tomorrozy/gesture-control-car/docs/README.md

# 文档中心

这里汇总了从零基础到完整实现这个项目所需的全部资料，一共 **47 篇**。

---

## 怎么读（两条路线）

### 路线 A：零基础，目标是把车做出来

```
03-零基础落地包/  →  01-八阶段教程/  →  02-图解字典/  →  04-调试笔记/
   器材、工具链         每阶段怎么实现        概念看不懂查这里      卡住了查这里
```

1. 先看 [`03-零基础落地包/`](03-零基础落地包/)：买什么、装什么、怎么供电上电
2. 按 [`01-八阶段教程/`](01-八阶段教程/) 从阶段一做到阶段八，每阶段做完对照
   [`03-零基础落地包/04-八阶段逐阶段操作与验收门禁.md`](03-零基础落地包/04-八阶段逐阶段操作与验收门禁.md) 验收
3. 遇到不懂的名词查 [`02-图解字典/`](02-图解字典/)
4. 出 bug 先翻 [`04-调试笔记/`](04-调试笔记/)

### 路线 B：有嵌入式基础，只想看实现

```
00-学习路线与工程全景  →  01-八阶段教程  →  05-参考资料
```

先看 [`00-学习路线与工程全景.md`](00-学习路线与工程全景.md) 建立整体架构，再按需查具体阶段。

---

## 目录说明

### [`00-学习路线与工程全景.md`](00-学习路线与工程全景.md)

整个工程的架构分层、代码地图、学习路线图。**建议最先看这篇。**

### [`01-八阶段教程/`](01-八阶段教程/)　13 篇

项目的九个阶段（对应《Taurus 2027 电控组三面》任务书）：

| 阶段 | 内容 | 文档 |
|---|---|---|
| 一 | 双机通信 | [阶段一_双机通信_V2.md](01-八阶段教程/阶段一_双机通信_V2.md) |
| 二 | 电机驱动 | [阶段二_电机驱动_V2.md](01-八阶段教程/阶段二_电机驱动_V2.md) |
| 三 | 通信控电机 | [阶段三_通信控电机_V2.md](01-八阶段教程/阶段三_通信控电机_V2.md) |
| 四 | 蓝牙无线 | [阶段四_蓝牙无线_V2.md](01-八阶段教程/阶段四_蓝牙无线_V2.md) |
| 五 | MPU6050 姿态解算 | [阶段五_MPU6050解算_V2.md](01-八阶段教程/阶段五_MPU6050解算_V2.md) |
| 六 | 手势控电机 | [阶段六_手势控电机_V2.md](01-八阶段教程/阶段六_手势控电机_V2.md) |
| 七 | 速度闭环 PID | [阶段七_速度闭环PID_V2.md](01-八阶段教程/阶段七_速度闭环PID_V2.md) |
| 八 | 手势控小车 | [阶段八_手势控小车_V2.md](01-八阶段教程/阶段八_手势控小车_V2.md) |
| 八·任务1 | 差速转向原理 | [阶段八任务1_原理详解.md](01-八阶段教程/阶段八任务1_原理详解.md) |
| 八·任务2 | 速度环与前馈 | [阶段八任务2_原理详解.md](01-八阶段教程/阶段八任务2_原理详解.md) |

### [`02-图解字典/`](02-图解字典/)　9 篇

每个阶段配一份图解，把抽象概念（PWM、编码器、互补滤波、PID）画成图和类比。
**看不懂教程时来这里查。**

### [`03-零基础落地包/`](03-零基础落地包/)　7 篇

从「什么都没有」到「板子上电」的完整清单：

- [01-器材采购与到货核对清单.md](03-零基础落地包/01-器材采购与到货核对清单.md)
- [02-工具链与软件安装配置.md](03-零基础落地包/02-工具链与软件安装配置.md)
- [03-供电共地与上电安全.md](03-零基础落地包/03-供电共地与上电安全.md)
- [04-八阶段逐阶段操作与验收门禁.md](03-零基础落地包/04-八阶段逐阶段操作与验收门禁.md)
- [05-引脚权威总表与阶段接线改动.md](03-零基础落地包/05-引脚权威总表与阶段接线改动.md)
- [06-各阶段编译前补文件清单.md](03-零基础落地包/06-各阶段编译前补文件清单.md)

### [`04-调试笔记/`](04-调试笔记/)　8 篇

每个阶段真实踩过的坑：现象 → 原因 → 排查方法 → 解决。按阶段对应，出问题直接查。

### [`05-参考资料/`](05-参考资料/)　5 篇

- [STM32电控术语词典.md](05-参考资料/STM32电控术语词典.md) —— 200+ 条电控术语，按主题分类
- [代码模板速查.md](05-参考资料/代码模板速查.md) —— 常用外设初始化代码片段
- [Yaw零飘问题详解.md](05-参考资料/Yaw零飘问题详解.md) —— MPU6050 航向角漂移的成因与对策
- [嘉立创硬件解析与软硬映射.md](05-参考资料/嘉立创硬件解析与软硬映射.md) —— 原理图与代码的对应关系
- [硬件事实清单.md](05-参考资料/硬件事实清单.md) —— 已核实 / 待确认的硬件参数表

另外还有：

- [`硬件与接线.md`](硬件与接线.md) —— 两端完整引脚表（从驱动源码提取，与代码一致）
- [`通信协议.md`](通信协议.md) —— 13 字节帧格式、校验算法、无线参数

---

## 说明

- 文档中的代码片段与本仓库 `遥控/`、`FreeRTOS小车/` 下的实际源码对应
- 部分文档来自早期学习与调试过程，个别图片未能保留（已在文中标注）
- 术语、引脚、参数以 [`硬件与接线.md`](硬件与接线.md) 与源码为准
