tomorrozy/gesture-control-car/docs/硬件与接线.md

# 硬件与接线

> 所有引脚均从对应驱动源码中提取，与实际工程一致。
> 修改接线后，若代码里的引脚宏没同步改，请以代码为准。

---

## 一、手柄端（遥控 · STM32F103 中容量）

启动文件为 `startup_stm32f10x_md.s`，对应中容量芯片（如 STM32F103C8T6 / RCT6）。

| 模块 | 信号 | 引脚 | 模式 | 代码位置 |
|---|---|---|---|---|
| MPU6050 | SCL | **PB6** | 开漏输出（软件 I2C） | `APP/MyI2C.c` |
| MPU6050 | SDA | **PB7** | 开漏输出 | `APP/MyI2C.c` |
| OLED | SCL | **PB8** | 开漏输出（软件 I2C） | `APP/OLED.c` |
| OLED | SDA | **PB9** | 开漏输出 | `APP/OLED.c` |
| nRF24L01 | CSN | **PA0** | 推挽输出 | `APP/nRF24L01_API.c` |
| nRF24L01 | CE | **PA1** | 推挽输出 | 同上 |
| nRF24L01 | SCK | **PA2** | 推挽输出 | 同上 |
| nRF24L01 | MOSI | **PA3** | 推挽输出 | 同上 |
| nRF24L01 | MISO | **PA4** | 上拉输入 | 同上 |
| nRF24L01 | IRQ | **PA5** | 上拉输入 | 同上 |
| 按键 | KEY1 | **PB12** | 上拉输入（按下为低） | `APP/key/key.h` |
| 按键 | KEY2 | **PB13** | 上拉输入 | 同上 |
| 按键 | KEY3 | **PB14** | 上拉输入 | 同上 |
| 按键 | KEY4 | **PB15** | 上拉输入 | 同上 |
| 按键 | KEY5 | **PA8** | 上拉输入 | 同上 |
| DHT22 | DATA | **PA12** | 单总线 | `APP/dht22.h`（未接入主流程） |
| LED | LED0 | **PC13** | 推挽输出 | `APP/led/led.h` |
| LED | LED8 | **PA7** | 推挽输出 | 同上 |
| 时基 | — | TIM4 | 1 ms 中断 | `Public/time4.c` |

> 注意：`led.h` 里定义了 LED0~LED8，但 `LED_Init()` 实际只初始化了 **LED0(PC13)** 和 **LED8(PA7)**，其余被注释掉了 —— 因为 LED2~LED6 与 nRF24L01 的 PA1~PA5 引脚冲突。

## 二、小车端（FreeRTOS · STM32F103ZE）

启动文件为 `startup_stm32f10x_hd.s`，对应高容量芯片（开发板为 STM32F103ZE）。

### 电机与编码器

| 功能 | 信号 | 引脚 | 模式 / 外设 | 代码位置 |
|---|---|---|---|---|
| 左电机方向 | IN1 | **PB12** | 推挽输出 | `HARDWARE/LED/Motor.c` |
| 左电机方向 | IN2 | **PB13** | 推挽输出 | 同上 |
| 右电机方向 | IN3 | **PB14** | 推挽输出 | 同上 |
| 右电机方向 | IN4 | **PB15** | 推挽输出 | 同上 |
| 左电机 PWM | PWM_A | **PA0** | TIM2_CH1，复用推挽 | `HARDWARE/LED/PWM.c` |
| 右电机 PWM | PWM_B | **PA1** | TIM2_CH2，复用推挽 | 同上 |
| 左编码器 | A / B 相 | **PA6 / PA7** | TIM3 编码器模式 TI12，上拉输入 | `HARDWARE/LED/Encoder.c` |
| 右编码器 | A / B 相 | **PB6 / PB7** | TIM4 编码器模式 TI12，上拉输入 | 同上 |

PWM 频率：`72 MHz / 36 / 100 = 20 kHz`（`PSC = 35`，`ARR = 99`），占空比 `0~100`。

### 无线与显示

| 模块 | 信号 | 引脚 | 模式 | 说明 |
|---|---|---|---|---|
| nRF24L01 | CSN | **PA2** | 推挽输出 | 软件 SPI |
| nRF24L01 | CE | **PA3** | 推挽输出 | |
| nRF24L01 | SCK | **PA4** | 推挽输出 | |
| nRF24L01 | MOSI | **PA5** | 推挽输出 | ⚠️ 与 LED1 复用，见下 |
| nRF24L01 | MISO | **PB0** | 上拉输入 | |
| nRF24L01 | IRQ | **PB1** | 上拉输入 | |
| OLED | SCL | **PB9** | 开漏输出 | ⚠️ 与手柄端**相反** |
| OLED | SDA | **PB8** | 开漏输出 | |
| 串口1 | TX / RX | **PA9 / PA10** | 复用推挽 / 浮空输入 | 115200 8N1 |
| LED | LED0 | **PC13** | 推挽输出 | |
| LED | LED1 | **PA5** | 推挽输出 | ⚠️ 与 nRF MOSI 冲突 |

> ⚠️ **已知引脚冲突**：小车端 `LED_Init()` 把 **PA5** 配成推挽输出，而 nRF24L01 的 **MOSI 也是 PA5**。
> `main()` 里 `NRF24L01_Init()` 在 `LED_Init()` 之后执行，所以最终是无线模块生效，LED1 实际不可用
> （SPI 通信时它会被高频翻转）。如果你要真正用 LED1，请改到别的引脚。

## 三、供电注意事项

- **nRF24L01 必须 3.3 V**，接 5 V 会烧毁；模块电源脚建议并联 **10 µF** 钽电容，否则上电握手偶发失败。
- 电机与主控建议**分开供电**，电机启动瞬间的电流跌落会导致单片机复位。
- H 桥和主控要**共地**。
- OLED、MPU6050 也是 3.3 V 器件，注意电平匹配。

## 四、原理图

[`1.原理图/手势小车.epro`](../1.原理图/手势小车.epro) 是**立创 EDA 专业版**工程文件，
用 [立创 EDA 专业版](https://pro.lceda.cn/) 打开即可查看/编辑。该文件是 ZIP 二进制格式，属于设计源文件，直接提交进 Git 仓库。
