tomorrozy/gesture-control-car/docs/00-学习资料总索引.md

---
title: 学习库总索引
tags:
  - RM电控
  - STM32/导航
  - MOC
version: V2
updated: 2026-10-23
---

> [!danger] 🚨 版本交接指令
> 请将旧版 `00_学习库总索引_V1.md` 移入回收站，保存此 `_V2` 文件，并确认全库双链无断链（当前 19 篇、0 断链）。

# 00 · RM_STM32 学习库总索引（V2）

> [!tip] 配套
> 本页是导航；八阶段教程与八篇 Debug 档案互链，找不到东西先回这里。

---

## 📡 本页怎么用

> [!info] 预习指南：先看这三个问题
> 本页只回答“从哪开始、现在缺什么、哪条是硬伤”。

| 你想干什么 | 点哪里 |
| :--- | :--- |
| 按顺序从头学 | 「八阶段进度表」，从阶段一开始 |
| 某个现象不对，想排错 | 对应阶段的 `Debug_阶段X_...` |
| 想知道代码里哪些是坑 | 「硬伤清单」与「待补信息」 |
| 想知道审到哪一步了 | 「审查与修复记录」 |

---

## 一、八阶段进度表（含审查状态）

| 阶段 | 主教程 | 错题本 | 核心一句话 | 审查 |
|:--:|---|---|---|:--:|
| 一 · 双机通信 | [[阶段一_主教程_双机通信_V2]] | [[Debug_阶段一_双机通信_V2]] | 13 字节帧：A5 / 长度 / 数据 / XOR / 0D | ✅ V2 |
| 二 · 电机驱动 | [[阶段二_主教程_电机驱动_V2]] | [[Debug_阶段二_电机驱动_V2]] | 20 kHz PWM + 四倍频编码器 | ✅ V2 |
| 三 · 通信控电机 | [[阶段三_主教程_通信控电机_V2]] | [[Debug_阶段三_通信控电机_V2]] | 收包 → 加锁 → 映射 → PID → 输出 | ✅ V2 |
| 四 · 蓝牙无线 | [[阶段四_主教程_蓝牙无线_V2]] | [[Debug_阶段四_蓝牙无线_V2]] | 软件 SPI + nRF24L01 寄存器 | ✅ V2 |
| 五 · 姿态解算 | [[阶段五_主教程_MPU6050解算_V2]] | [[Debug_阶段五_MPU6050解算_V2]] | 软件 I2C + 互补滤波 α=0.95 | ✅ V2 |
| 六 · 手势控电机 | [[阶段六_主教程_手势控电机_V2]] | [[Debug_阶段六_手势控电机_V2]] | gesture 是备用通道，车用连续量 | ✅ V2 |
| 七 · 速度闭环 PID | [[阶段七_主教程_速度闭环PID_V2]] | [[Debug_阶段七_速度闭环PID_V2]] | 位置式 PI，20 ms，无 D | ✅ V2 |
| 八 · 手势控小车 | [[阶段八_主教程_手势控小车_V2]] | [[Debug_阶段八_手势控小车_V2]] | 差速：一加一减 | ✅ V2 |

---

## 二、本库结构

```text
RM_STM32_学习库\
├─ 00_MOC与索引\00_学习库总索引_V2.md   ← 本页
├─ 01_阶段一_双机通信\ … 08_阶段八_手势控小车\   （各 1 篇 V2 主教程）
├─ 80_Debug错题本\                                （8 篇 V2，与主教程互链）
└─ _归档_V1\                                      （17 篇旧版，按 00_索引 + 01–08 子目录排序，仅备查）
```

**命名**：`阶段X_主教程_主题_Vn.md`、`Debug_阶段X_主题_Vn.md`；现行全为 **V2**，旧版统一收进 `_归档_V1\`（双链仍可解析，但不作为学习入口）。
**每篇结构**：YAML → `[!info]` 雷达 → 任务对表 → 结构总览 → 逐行（`【第 X 行】` + `[!abstract]`）→ 现象 → 缺口 → `[!success]` 审计报告 → 勘误记录。

---

## 三、基准事实（全库统一，已逐行核对）

| 项目 | 事实 | 出处 |
|---|---|---|
| MCU / 主频 | STM32F103C8T6 ×2；72 MHz（HSE 8 MHz × `PLLMULL9`） | `system_stm32f10x.c`、`stm32f10x.h` |
| 协议 | 13 字节：`A5 / 09 / pitch4 / roll4 / gesture1 / XOR / 0D` | 两端 `main.c` |
| 无线 | nRF24L01，`RF_CH=40`（2440 MHz）、2 Mbps、32 字节定长 | `nRF24L01_API.c` |
| 控制周期 | 20 ms（`configTICK_RATE_HZ=1000`） | `main.c:303`、`FreeRTOSConfig.h:97` |
| 发送节拍 | 100 ms（≈10 Hz） | `遥控 main.c:156` |
| 编码器 | 常数 `52` → 反推 **13 线**（4×13）；减速比 **1:13** → 676 计数/输出圈 | `main.c:265`、你的确认 |
| PID | 位置式 PI：Kp=2.0、Ki=1.5、Kd=0（D 未实现） | `main.c:84/166` |
| 时延 | 100 + 20 + 20 ≈ **140 ms** | `main.c:206/303` |

---

## 四、硬伤清单（审查后刷新）

| # | 硬伤 | 位置 | 后果 | 修法 |
|:--:|---|---|---|---|
| 1 | **失联不停车** | `task_rx` 无超时 | 遥控断电后车继续跑 | 记最后收包 tick，超 300 ms 目标清零 |
| 2 | **无 VOFA 打印** | 全工程裸 `printf` = 0 | 闭环无法量化 | 用阶段七 3.10 的打印，调参时开 |
| 3 | **差速无归一化** | `main.c:256–259` 各自截断 | 大角度斜推比例失真（5.5:1→3.25:1） | 等比缩放（阶段八 3.8） |
| 4 | **反馈系数 9.27666** | `main.c:265–266` | 与 1:13 不符 → 反馈高估约 40% | 改 `13.0f` 后重调 Ki（前提：线数=13） |
| 5 | **三套左右开关** | 遥控 `Gesture_Map:66` 互换后门 + 小车 `REVERSE_TURN` + 遥控 `×-1.0f` | 同时改会互相抵消，方向排查困难 | 只保留一个入口，其余置默认 |
| 6 | **三套阈值** | 遥控 15/15、控制 10/15、显示 10/15 | `pitch=12°` 时屏幕说停、车却走 30% | 统一常量，或把阈值集中到一个头文件 |

**死代码/死变量（答辩会被问）**：`g_gesture` 只写不读（96/202）；`MIN_SPEED` 未使用（221）；`channel` 未使用（97）；`cos_pitch` 算了不用（MPU6050.c:120）；`kd`/`prev_err` 未参与公式（85）。

---

## 五、待补信息（我仍未掌握，不猜）

| 项 | 需要什么 | 影响 |
|:--:|---|---|
| TB6612 实物接线 | PWMA/PWMB/AIN1/AIN2/BIN1/BIN2/STBY 各接哪 | “前进”是否与代码一致 |
| 嘉立创工程 | BOM（CSV）+ 原理图 PDF | `.eprj2` 当前只剩空 `attributes` 表，读不出元件/网络 |
| 编码器线数 | 是否 13 线 | 决定 52/676 与 40% 修正是否成立 |
| 电机额定转速 | 铭牌参数 | 决定 0~100 对应多少 cm/s |
| 物理方向 | 前进/左转是否与逻辑一致 | 需上车实测（`REVERSE_TURN`/取反/接线三者耦合） |
| `LOOP_TIME` | 主循环实测周期 | 阶段五互补滤波的 `0.01f` 是假设 |

---

## 六、审查与修复记录（本轮全量）

| 阶段 | 审查发现 | 处理 | 复验项 |
|:--:|---|---|:--:|
| 一 | 9 处行号偏移（3.1/3.2 与 Debug） | 已修（V1.1） | 29 |
| 二 | 13 处行号 + 4 类反向漏检（输入捕获/滤波、LED/OLED、13 线归因） | 已修 → **V2 落盘** | 107 |
| 三 | 局部量类型缺失、轮询无出处、分组错标 | 已修（V1.1） | 95 |
| 四 | 3.3/3.7 行号、代码块压缩未声明 | 已修（V1.1） | 79 |
| 五 | `cos_pitch` 块失真、`WriteReg` 依赖、main 双校准 | 已修（V1.1） | 153 |
| 六 | 66 行注释、`REVERSE_TURN` 宏、`#if` 分支 | 已修（V1.1） | 71 |
| 七 | 13 线归因、右轮补偿、全局量类型 | 已修（V1.1） | 71 |
| 八 | 显示任务整段漏检、`#if` 分支、补偿链路 | 已修 → **V2 落盘** | 74 |

**总计**：逐行断言复验 **约 730 项**，全库双链 **0 断链**。

---

## 七、学习顺序与依赖

```text
阶段一（协议）→ 阶段二（电机/编码器）→ 阶段三（链路打通）
   → 阶段四（无线）→ 阶段五（姿态）→ 阶段六（手势语义）
   → 阶段七（闭环）→ 阶段八（整机）
```

依赖：三←一+二；六←五；七←二+三；八←三+六+七。可跳读：阶段四寄存器细节、阶段七调参细节。

---

## 八、防幻觉审计报告

> [!success] 🛡️ 防幻觉审计报告
> 1. **代码出处核实**：是。本页所有基准事实、硬伤位置、死变量行号均来自已逐行审查的源文件（两端 `main.c`、`nRF24L01_API.c`、`MyI2C.c`、`MPU6050.c`、`PWM.c`、`Motor.c`、`Encoder.c`、`led.c/led.h`、`FreeRTOSConfig.h`、`system_stm32f10x.c`）。
> 2. **库的纯洁性**：未混用；全库按 StdPeriph + FreeRTOS 描述，无 `HAL_`。
> 3. **脑补排查**：否。硬件接线/线数/转速/物理方向/`LOOP_TIME` 一律列“待补”，未编造；`13 线`明确标为**反推值**。
> 4. **本次悬空依赖**：`00_学习库总索引_V1.md` 已由本 V2 取代；全库 19 篇、0 断链。

#RM电控 #STM32 #MOC
