tomorrozy/gesture-control-car/docs/00-学习路线与工程全景.md

---
tags:
  - STM32/教程
  - STM32/代码驱动
  - 电控组
aliases:
  - 代码驱动教程 00
  - 工程全景与学习路线图
type: 教程
status: 进行中
project: STM32手势小车
---

# 零基础 · 代码驱动教程｜第 0 步：工程全景与学习路线图

> **本轮只做"地图"，不逐行讲代码。** 目的只有一个：在你看第一行代码之前，先知道这个工程有几块、每块干什么、按什么顺序看、每章学完你会看到什么现象。

---

## 〇、开场三句实话（先说清楚，免得后面误会）

1. **你消息里的【总纲】【目录树】正文没有贴上来**（只传过来了 4 个 @ 路径）。所以我**没有等**，直接读了磁盘上的真实内容：
   - `Taurus 2027电控组三面.pdf`（7 页，八阶段 + 进阶拓展的题目要求）
   - `FreeRTOS小车\`、`遥控\` 两个 Keil 工程的全部源码（已转成 UTF-8 副本逐个读过）
   - 你库里已有的《三面题八阶段代码阶梯》《README 阅读顺序》等笔记
2. **我用来当"总纲"的是这两样东西**：`三面题八阶段代码阶梯_read0.txt` 的八阶段骨架 + PDF 的得分点。如果你手里那份总纲是**另一个文件**，把它发我，我按它重排章节（章节名、顺序都能改）。
3. **下面凡是我写"行号"的地方，都是我在磁盘上实测的真实行号**；凡是我不确定的（比如某个硬件参数），我会直接写"待确认"，不猜。

---

## 一、这是一个什么工程：一句话 + 两张角色卡

**一句话**：两块 STM32F103C8T6 组成的"手势遥控车"——
**手带端（`遥控\`）戴在手上**，用 MPU6050 测出俯仰角/横滚角，打包成 13 字节的无线帧发出去；
**小车端（`FreeRTOS小车\`）装车上**，收到帧后把角度换算成左右轮目标速度，用编码器做速度闭环 PID，驱动两个电机差速转向。

```
        手带端（遥控工程）                          小车端（FreeRTOS小车工程）
  ┌──────────────────────────┐             ┌──────────────────────────────┐
  │ MPU6050 ──软件I2C──┐     │             │  nRF24L01 ──软件SPI──┐         │
  │                    ↓     │  2.4GHz     │                      ↓         │
  │              互补滤波     │  13字节帧   │  解包 → pitch/roll            │
  │                    ↓     │ ──────────► │           ↓                   │
  │           手势映射 Gesture│             │   姿态→左右轮目标速度          │
  │                    ↓     │             │           ↓                   │
  │       打包 0xA5…0x0D      │             │   PID 闭环（编码器反馈）        │
  │                    ↓     │             │           ↓                   │
  │  OLED（给人看）  nRF发送   │             │  PWM → TB6612 → 电机 → 编码器  │
  └──────────────────────────┘             └──────────────────────────────┘
```

### 角色卡 A：手带端 `遥控\`

| 项目 | 实测值 |
|---|---|
| Keil 工程文件 | `Template.uvprojx` |
| 芯片 / 容量宏 | `STM32F103C8` / `STM32F10X_MD`（64 KB Flash、20 KB RAM） |
| 启动文件 | `Libraries\CMSIS\startup_stm32f10x_md.s` |
| **有没有操作系统** | **没有**。裸机：`main()` 里一个 `while(1)`，加一个 1 ms 定时器中断 |
| 时间基准 | `TIM4` 1 ms 中断（`Public\time4.c`），中断里给 `Time_ms` 加 1 并扫描按键 |
| 主循环节拍 | 循环显示 OLED；`Time_ms > 100` 时打包并发送一帧 → **约 10 Hz** |
| 无线 | nRF24L01，**软件 SPI**，引脚 `PA0~PA5`（CSN/CE/SCK/MOSI/MISO/IRQ） |
| 显示 | OLED SSD1306，**软件 I2C**，`SCL=PB8`、`SDA=PB9` |
| 姿态传感器 | MPU6050，**软件 I2C**，`SCL=PB6`、`SDA=PB7` |
| 人机输入 | 5 个按键：`PB12/PB13/PB14/PB15/PA8`（上拉输入，按下为低） |
| 指示灯 | `PC13`（LED0）、`PA7`（LED8） |

### 角色卡 B：小车端 `FreeRTOS小车\`

| 项目 | 实测值 |
|---|---|
| Keil 工程文件 | `USER\FreeRTOS.uvprojx` |
| 芯片 / 容量宏 | `STM32F103C8` / `STM32F10X_MD`（同左） |
| 启动文件 | `CORE\startup_stm32f10x_hd.s` ⚠️ **hd（大容量）启动文件 + MD 容量宏 = 不自洽，第 1 章专门核对** |
| **有没有操作系统** | **有**。FreeRTOS，4 个任务（start/rx/ctrl/disp），**全部静态创建**（不 malloc） |
| 任务节拍 | `task_rx` 20 ms 收一次包、`task_ctrl` 20 ms 跑一次 PID、`task_disp` 50 ms 刷一次屏 |
| 无线 | nRF24L01，软件 SPI，引脚 `PA2~PA5` + `PB0/PB1`（CSN/CE/SCK/MOSI + MISO/IRQ） |
| 显示 | OLED，软件 I2C，**`SCL=PB9`、`SDA=PB8`（与手带端正好相反！）** |
| 执行器 | 2 路 PWM：`PA0`(TIM2_CH1)、`PA1`(TIM2_CH2)；方向脚 `PB12~PB15`；接 TB6612 |
| 反馈 | 编码器：左轮 TIM3(`PA6/PA7`)、右轮 TIM4(`PB6/PB7`)，四倍频计数 |
| 指示灯 | `PC13`、`PA5` ⚠️ **PA5 同时是 nRF 的 MOSI，被 LED_Init 抢过一次** |

> **必须记住的一件事**：`nRF24L01_API.c`、`OLED.c`、`led.c` 在**两个工程里各有一份同名文件，但里面的引脚定义不同**。
> Windows 文件系统不区分大小写，VS Code 的标签页也长得一样 —— 这是新手最容易"改了没反应"的地方。
> 从下一章起，我每次都会在代码块第一行标清来源路径。

---

## 二、整体架构：五层楼

```
┌──────────────────────────────────────────────────────────────────────┐
│ L4 应用层   遥控/User/main.c          小车/USER/main.c                │
│            手势映射 + 打包            解包 + 姿态映射 + PID + 4任务    │
├──────────────────────────────────────────────────────────────────────┤
│ L3 中间件   内联协议(0xA5…0x0D)  XOR校验    ├── FreeRTOS 内核          │
│            互补滤波(MPU6050.c 内)           │  tasks/queue/list/timers │
│            速度环 PID(main.c 内)            │  port(ARM_CM3)/heap_4    │
├──────────────────────────────────────────────────────────────────────┤
│ L2 驱动层   led  PWM  Motor  Encoder  OLED  OLED_Data                 │
│             nRF24L01_API  MyI2C  MPU6050  key  time4  SysTick          │
│             usart  delay  sys           ← 这些是"本项目自己写的"        │
├──────────────────────────────────────────────────────────────────────┤
│ L1 库函数   STM32F10x_FWLib（23 个外设驱动：gpio/tim/usart/rcc/…）      │
│            作用：把"写寄存器"包装成"填结构体 + 调函数"                  │
├──────────────────────────────────────────────────────────────────────┤
│ L0 底座     startup_stm32f10x_*.s（向量表/复位入口）                    │
│             system_stm32f10x.c（时钟树 → 72 MHz）                      │
│             stm32f10x.h（所有寄存器的名字）  core_cm3（内核）           │
│             stm32f10x_it.c（异常/中断入口）                            │
└──────────────────────────────────────────────────────────────────────┘
                              ▲ 再往下就是硬件：芯片、电机、屏幕、无线模块
```

### 每层的职责，用一句人话讲

| 层 | 职责 | 什么时候你会改它 |
|---|---|---|
| **L0 底座** | 芯片上电后**第一段执行的代码**：填向量表 → 调 `SystemInit()` 把 8 MHz 晶振倍频到 72 MHz → 跳进 `main()` | 几乎不改，但**必须看懂一次**（第 1 章），否则永远不知道为什么"忘了开时钟外设就不动" |
| **L1 库函数** | 官方固件库。每个外设一套 `XXX_Init()/XXX_Cmd()` | 不改，只查：想确认某个参数有什么可选项时翻它的 `.h` |
| **L2 驱动层** | 本项目作者写的"把某个硬件变成几个函数"：`Motor_SetPWM()`、`Encoder_Get()`、`OLED_ShowString()` | **你最常改的一层**（换引脚、加显示行、调 PWM 频率） |
| **L3 中间件** | 跟具体硬件无关的"算法与调度"：协议打包/解包、互补滤波、PID、FreeRTOS | 调参、改进算法都在这层 |
| **L4 应用层** | 决定"什么时候调用谁"：任务循环、主循环、状态机 | 加功能先看这层 |

### 为什么这个工程要分这么多层（也是你以后自己写代码该照抄的结构）

- **换硬件只动 L2**：比如把 OLED 从 PB8/PB9 换到 PB10/PB11，只改 `OLED.c` 里 3 行，L3/L4 一行不动。
- **换算法只动 L3**：把互补滤波换成卡尔曼滤波，`main.c` 里 `MPU6050_GetAngle()` 的调用完全不用改。
- **换流程只动 L4**：把 `while(1)` 改成 FreeRTOS 任务，是因为 L3 的 PID、协议都被封装成了函数，可以随便搬。

---

## 三、一次完整的"抬手 → 轮子转"（8 跳数据流）

这一节是全套教程的**主线剧情**，后面每一章都是在这条链上摘下一环来讲。

| 跳 | 发生什么 | 代码位置（实测行号） |
|:--:|---|---|
| ① | **读传感器**：I2C 连读 14 字节 → 加速度 ax/ay/az + 陀螺 gx/gy/gz | `遥控\APP\MPU6050.c` `MPU6050_GetData()` |
| ② | **算角度**：加速度算"绝对倾角"，陀螺积分算"变化量"，两者用 α=0.95 互补融合 → `pitch/roll` | `遥控\APP\MPU6050.c` 第 89–137 行 |
| ③ | **变手势**：`pitch>15°`→前进，`<-15°`→后退，`roll>15°`→左，`<-15°`→右，否则停 | `遥控\User\main.c` 第 62–73 行 `Gesture_Map()` |
| ④ | **打包**：`[0xA5][0x09][pitch 4B][roll 4B][gesture 1B][XOR][0x0D]` = 13 字节，补 0 到 32 字节 | `遥控\User\main.c` 第 75–93 行 `Protocol_Pack()` |
| ⑤ | **发无线**：写 TX FIFO → CE 拉高 → 等 IRQ 变低（发送完成） | `遥控\APP\nRF24L01_API.c` `NRF24L01_SendData()` |
| ⑥ | **收无线 + 解包**：读 32 字节 → 逐字段校验 → 限幅 ±80° → 加互斥量写入全局变量 | `FreeRTOS小车\USER\main.c` 第 182–208 行 `task_rx()` / 第 42–55 行 `Protocol_Unpack()` |
| ⑦ | **变目标速度**：pitch→前后速度 `speed_x`（去 10° 死区），roll→转向分量 `speed_y`（去 15° 死区）；`targetL=speed_x+speed_y`、`targetR=speed_x-speed_y` | 同文件 第 230–259 行 |
| ⑧ | **闭环 + 驱动**：编码器测实际转速 → PID 算 PWM → 限幅/起转补偿 → `Motor_SetPWM()` → H 桥 → 轮子 → 编码器…回到 ⑧ | 同文件 第 261–304 行 + `Encoder.c` + `Motor.c` + `PWM.c` |

> **一句话记住整条链**：`姿态 → 角度 → 手势/速度 → 帧 → 空中 → 帧 → 左右轮速 → PWM → 轮子 → 编码器 → 回到 PID`。
> 学完之后，你应该能在纸上默画出这 8 跳，并说出每一跳在哪个文件。

---

## 四、零基础学习路线图：18 章（第 0 章是预备课）

**难度**：★ 入门（照着抄就能过）｜★★ 基础（理解概念）｜★★★ 进阶（要动手调试）｜★★★★ 较难（要查手册）｜★★★★★ 综合（要整机联调）

**学时**是"零基础 + 每章都要上板验证"的保守估计，全套约 **90~100 小时**，一周 2 章约 9~10 周。

### 第一部分 · 地基：让程序跑起来，并且知道自己为什么能跑（第 0~2 章）

| 章 | 标题 | 主要文件 | 学完你能看到的现象 | 难度 | 前置 | 学时 |
|:--:|---|---|---|:--:|:--:|:--:|
| **0** | **预备课：这套工程怎么打开、编译、下载** | `*.uvprojx`、`keilkilll.bat`、`OBJ\*.hex` | Keil 能编译 0 error、ST-Link 能下载、串口助手能连上 | ★ | 无 | 2 |
| **1** | **从复位到 main：芯片上电后的 100 毫秒** | `startup_stm32f10x_hd.s`、`system_stm32f10x.c`、`main.c` 第 141–172 行 | 说清"为什么每个外设都要先开时钟"；能在 `main()` 第一行打断点，看变量 | ★★ | 0 | 3 |
| **2** | **GPIO：点灯与按键** | `led.c/.h`、`key.c/.h` | PC13 灯 1 Hz 闪；按键短按/长按在同一块板上被区分开 | ★★ | 1 | 4 |

### 第二部分 · 接口：让芯片会说话、会看（第 3~5 章）

| 章 | 标题 | 主要文件 | 学完你能看到的现象 | 难度 | 前置 | 学时 |
|:--:|---|---|---|:--:|:--:|:--:|
| **3** | **串口 + printf：板子开口说话** | `usart.c/.h`、`delay.c` | 电脑串口助手每 500 ms 收到一行 `Hello 1`，且能反向发数据回板子 | ★★ | 1 | 4 |
| **4** | **OLED：给板子一张脸** | `OLED.c`、`OLED.h`、`OLED_Data.h` | 128×64 屏上显示中文"姿态："和数字；改一个数字立刻变 | ★★★ | 2,3 | 6 |
| **5** | **定时器：给程序装一颗心跳** | `time4.c`、`SysTick.c`、`main.c` 的 `Time_ms` | 1 ms 中断里计数，OLED 上看到秒表；理解"中断打断 main" | ★★★ | 2,3 | 4 |

### 第三部分 · 执行器与传感器：让它动、让它感知（第 6~9 章）

| 章 | 标题 | 主要文件 | 学完你能看到的现象 | 难度 | 前置 | 学时 |
|:--:|---|---|---|:--:|:--:|:--:|
| **6** | **PWM 与 H 桥：电机转起来** | `PWM.c/.h`、`Motor.c/.h` | 电机 0→100 占空比由慢到快，`-100` 反转 | ★★ | 2 | 4 |
| **7** | **编码器：让车知道自己转多快** | `Encoder.c/.h` | 串口打印"每 20 ms 的脉冲数"，用手转轮子数字会变正负 | ★★★ | 6 | 5 |
| **8** | **软件 I2C 与 MPU6050：读出姿态原始值** | `MyI2C.c/.h`、`MPU6050_Reg.h`、`MPU6050.c` 前半 | OLED 上 6 个数字：静止时 ax≈0、az≈2048，转动时 gx/gy 变化 | ★★★★ | 2,4 | 6 |
| **9** | **互补滤波：把抖动的数字变成稳定的角度** | `MPU6050.c` 第 89–137 行 | 板子倾斜 30°，屏幕角度跟手且不抖；快速晃动不飘 | ★★★★ | 8 | 6 |

### 第四部分 · 通信：让两块板子隔空对话（第 10~13 章）

| 章 | 标题 | 主要文件 | 学完你能看到的现象 | 难度 | 前置 | 学时 |
|:--:|---|---|---|:--:|:--:|:--:|
| **10** | **nRF24L01（上）：软件 SPI 与寄存器** | 小车端 `nRF24L01_API.c` 第 1–130 行 | `NRF24L01_Check()` 返回 0，OLED 显示"无线模块正常" | ★★★★ | 2,3 | 6 |
| **11** | **nRF24L01（下）：收发模式与 32 字节包** | 两端 `nRF24L01_API.c` 后半 + `main.c` 的初始化 | 一块板按键，另一块板 OLED 上的数字变 | ★★★★ | 10 | 6 |
| **12** | **自定义协议：0xA5 / 长度 / XOR / 0x0D** | 遥控 `main.c` 第 75–93 行、小车 `main.c` 第 42–55 行 | 串口助手抓到 13 字节帧；故意改坏校验字节，接收端丢弃 | ★★★ | 11 | 4 |
| **13** | **手势映射：角度变成指令** | 遥控 `main.c` 第 62–73、126–168 行 | 抬手显示"前进"、翻腕显示"左右"；10 Hz 发送节拍可测 | ★★ | 9,12 | 3 |

### 第五部分 · 闭环与整机：把碎片缝成一辆车（第 14~17 章）

| 章 | 标题 | 主要文件 | 学完你能看到的现象 | 难度 | 前置 | 学时 |
|:--:|---|---|---|:--:|:--:|:--:|
| **14** | **PID：速度闭环** | 小车 `main.c` 第 58–90、261–305 行 | 目标 50 时轮子稳定在 50；**用手捏住轮子，松手后它会"顶"回原速** | ★★★★★ | 7,12 | 8 |
| **15** | **差速转向：姿态变成左右轮速** | 小车 `main.c` 第 211–305 行 | 抬手前进、翻腕原地转、斜推走弧线；OLED 显示 9 种状态 | ★★★★★ | 13,14 | 6 |
| **16** | **FreeRTOS：把一个大循环拆成四个任务** | `FreeRTOSConfig.h`、`portmacro.h`、`main.c` 第 108–208 行 | 三个任务按 20/20/50 ms 各跑各的，OLED 不再拖慢 PID | ★★★★★ | 12,14 | 8 |
| **17** | **整机联调 + 答辩** | `stm32f10x_it.c`、`delay.c`、全部 | 车能跑；能回答"丢包怎么办""为什么 PID 要 20 ms 一次""yaw 为什么漂" | ★★★★★ | 全部 | 8 |

---

## 五、章节依赖图（先学哪章）

```
                        ┌──── 0 预备课 ────┐
                        │                  │
                        ▼                  ▼
                        1 启动 ──────────► 2 GPIO
                         │                  │  │  │
              ┌──────────┼───────────┐      │  │  └──────────────┐
              ▼          ▼           ▼      ▼  ▼                 ▼
          3 串口     5 定时器      6 PWM ──► 7 编码器          4 OLED
              │          │           │        │                   │
              │          │           │        │                   ▼
              │          │           │        │              8 I2C/MPU6050
              │          │           │        │                   │
              │          ▼           │        │                   ▼
              │      10 nRF(上)      │        │              9 互补滤波
              │          │           │        │                   │
              │          ▼           │        │                   │
              └─────► 11 nRF(下)     │        │                   │
                         │           │        │                   │
                         ▼           │        │                   │
                     12 协议 ────────┘        │                   │
                         │                    │                   │
                         ▼                    │                   │
                     13 手势映射 ◄────────────┼───────────────────┘
                         │                    │
                         ▼                    ▼
                     15 差速 ◄────────► 14 PID
                         │                    │
                         └──────┬─────────────┘
                                ▼
                          16 FreeRTOS
                                │
                                ▼
                          17 整机联调
```

**三条硬依赖**（违反就会听不懂）：
1. **第 4 章（OLED）必须在第 8 章之前** —— 后面所有调试都靠屏幕看数字，没有屏幕你没法自测。
2. **第 7 章（编码器）必须在第 14 章（PID）之前** —— PID 的"反馈量"就是编码器读数。
3. **第 12 章（协议）必须在第 13/14/15 章之前** —— 后面所有"数据从无线来"的假设都建立在这套帧格式上。

**可以跳过的章节**（如果你只想先让车动起来）：第 5、16 章可以最后补；但第 4、7、12 章跳过会卡住。

---

## 六、按什么顺序把代码发给我（批次表）

**规则三条**：
- **一次只发 1~2 个文件**，按下面批次顺序走。发多了我会主动说"这轮只用其中 X"，浪费你的带宽。
- **发文件时不用解释**，直接拖进来就行；如果我需要某个头文件（`.h`），会在表里写清。
- **.c 和 .h 成对发**（宏定义、函数声明常在 `.h` 里，缺了我就得猜，而我不猜）。

| 批次 | 发给我的文件（相对 `Taurus car\`） | 用到它的章节 | 备注 |
|:--:|---|:--:|---|
| **1** | `FreeRTOS小车\USER\main.c` | 第 1 章 | ★ 全套的地图。这轮只讲第 1–180 行，其余部分先当黑盒 |
| **2** | `FreeRTOS小车\HARDWARE\LED\led.c` + `led.h` | 第 2 章 | 最短的驱动（37 行），最适合第一次逐行拆 |
| **3** | `遥控\APP\key\key.c` + `key.h` | 第 2 章（下半） | 按键状态机 + 长按短按，第一次见"时间"参与逻辑 |
| **4** | `FreeRTOS小车\SYSTEM\usart\usart.c` + `usart.h` | 第 3 章 | printf 重定向 + 中断接收状态机 |
| **5** | `FreeRTOS小车\HARDWARE\LED\OLED.c` + `OLED.h` | 第 4 章 | 只用前 200 行（GPIO/软件 I2C/写命令）；字模文件不用发 |
| **6** | `遥控\Public\time4.c` + `遥控\Public\SysTick.c` | 第 5 章 | 定时器中断 vs SysTick 延时，两种"时间"对比 |
| **7** | `FreeRTOS小车\HARDWARE\LED\PWM.c` + `Motor.c` | 第 6 章 | 时基单元 + H 桥真值表 |
| **8** | `FreeRTOS小车\HARDWARE\LED\Encoder.c` + `Encoder.h` | 第 7 章 | 编码器接口模式 + 溢出 |
| **9** | `遥控\APP\MyI2C.c` + `MyI2C.h`、`MPU6050_Reg.h` | 第 8 章 | 软件 I2C 时序 + 寄存器地址表 |
| **10** | `遥控\APP\MPU6050.c` + `MPU6050.h` | 第 8–9 章 | 一次发，分两章讲（读数据 / 算角度） |
| **11** | `FreeRTOS小车\HARDWARE\LED\nRF24L01_API.c` + `nRF24L01_API.h` | 第 10 章 | 只讲前 130 行（SPI + 读写寄存器 + Check） |
| **12** | `遥控\APP\nRF24L01_API.c` | 第 11 章 | 对比两端差异（引脚、地址、发送流程） |
| **13** | `遥控\User\main.c` | 第 12–13 章 | 打包 + 手势 + 100 ms 节拍主循环 |
| **14** | （不用新文件）回头用第 1 批的 `main.c` | 第 14–15 章 | 讲第 58–90 行 PID 和第 211–305 行 task_ctrl |
| **15** | `FreeRTOS小车\FreeRTOS\include\FreeRTOSConfig.h` + `FreeRTOS\portable\RVDS\ARM_CM3\portmacro.h` | 第 16 章 | 配置项 + 移植层宏，讲清"任务切换靠什么" |
| **16** | `FreeRTOS小车\USER\stm32f10x_it.c` + `SYSTEM\delay\delay.c` | 第 17 章 | 中断总入口 + FreeRTOS 下的延时（最后一个坑：`SysTick_Handler` 在哪） |

**这些不用你发**（我已在磁盘上读过，讲课时会直接引用行号）：
`STM32F10x_FWLib\`（固件库）、`FreeRTOS\` 内核源码、`startup_*.s`、`stm32f10x.h`、`OLED_Data.c`（字模，只讲结构）、`Obj\*.o`、`*.uvguix.*`、`dht22.c`（**不在工程里，是遗留文件**）。

---

## 七、我先扫了一遍代码，记下了 12 个"坑"（讲到哪章就展开哪个）

> 这些不是我编的，都是代码里**真实存在**的不一致。**先给你看，是为了让你知道：这工程不是"完美教材"，而是"能跑的实战代码"——真正值钱的能力，是能看出这些。**

| # | 坑 | 位置 | 会放在哪章 |
|:--:|---|---|:--:|
| 1 | **两个工程的 OLED 的 SCL/SDA 正好相反**：小车 `SCL=PB9,SDA=PB8`；遥控 `SCL=PB8,SDA=PB9` | 两端 `OLED.c` 第 79–99 行 | 4 |
| 2 | 小车 `LED_Init()` 把 **PA5** 配成推挽输出并拉高，而 PA5 是 nRF 的 **MOSI** | `小车\led.c` 第 31–35 行 | 2 / 10 |
| 3 | 小车 `led.c` 注释写"PB5 和 PE5"，实际代码是 **PC13 和 PA5**（正点原子模板残留） | 同上 第 16、25 行 | 2 |
| 4 | `MyI2C.c` 注释写"PB10/PB11"，实际是 **PB6/PB7** | `遥控\MyI2C.c` 第 52–64 行 | 8 |
| 5 | 遥控端 **TX 地址 0x11…，RX_ADDR_P0 却是 0xAA…** → 自动 ACK 收不到，每包白重发 10 次 | `遥控\nRF24L01_API.c` | 11 |
| 6 | 遥控发送用 `while(NRF_IRQ == 1)` **死等**，没有超时 → 模块掉线就卡死 | 同上 `NRF24L01_SendData()` | 11 |
| 7 | 互补滤波里 `LOOP_TIME=0.01`（假设 10 ms 一次），但主循环里有软件 I2C + 整屏刷新，实际周期可能 30~100 ms → **积分时间失真** | `遥控\MPU6050.c` 第 13、127 行 | 9 |
| 8 | `Key_1menu()` 定义了但 `main()` **从没调用**（死代码）；`dht22.c` 根本没加进工程 | `遥控\User\main.c`、`uvprojx` 文件列表 | 2 |
| 9 | 手势字节 `gesture` 打包发了，但小车 **收下就存着不用**，控制和显示都重新用 pitch/roll 算 | 两端 `main.c` | 13 |
| 10 | `g_act_left = enc/52/0.02/9.27666*5` 里的 **9.27666 是经验标定系数**，不是物理常数 | 小车 `main.c` 第 265–266 行 | 14 |
| 11 | 小车启动文件是 **hd（大容量）**，器件却是 C8/MD；`configTOTAL_HEAP_SIZE=10KB` 且全部静态创建却仍链接 `heap_4.c` | `uvprojx`、`FreeRTOSConfig.h` | 1 / 16 |
| 12 | 遥控判"前进"阈值 15°，小车 `DEAD_ZONE` 却是 10° → 15°~10° 之间会出现"手以为在动、车没动"的空档 | 两端 `main.c` | 15 |

---

## 八、和你那份"总纲"（三面题八阶段）怎么对上

| 三面题阶段 | 题目得分点 | 落到本教程的哪几章 |
|:--:|---|---|
| 阶段一 双机通信基础 | UART 双向、两板互连、0xA5…0x0D 协议、UART+DMA | 第 3、10、11、12 章（**DMA 你这工程没做**，第 17 章给补法） |
| 阶段二 电机驱动基础 | PWM 正反转、转速/位置、按键模式 + LED、OLED 显示 | 第 2、4、6、7 章（**按键模式与 LED 指示小车端没有**，第 2 章给改法） |
| 阶段三 双机通信控电机 | 一板发指令、另一板执行、指令切目标速度 | 第 12 章 + 第 14 章 |
| 阶段四 无线通信 | 用蓝牙/nRF 替换有线 | 第 10、11 章（本工程用 nRF，**没用 HC-05**） |
| 阶段五 MPU6050 姿态解算 | I2C 原始数据、互补/卡尔曼、角度稳定、yaw 零漂 | 第 8、9 章（**yaw 零漂**在第 9 章专讲） |
| 阶段六 手势控单电机 | 手势映射、无线发手势 | 第 13 章 + 第 14 章 |
| 阶段七 速度闭环 PID | 固定目标、VOFA+ 波形整定、IMU 映射速度 | 第 14 章（**VOFA+ 打印**第 14 章末尾补） |
| 阶段八 手势控小车 | 差速前进/后退/左转/右转 | 第 15 章 |
| 进阶拓展 | FreeRTOS 调度 | 第 16 章（**CAN、上位机在线调参**没做，第 17 章列路线） |

> **一句话**：这个工程是"**八个阶段全部压进了最终版**"的一份代码，所以它很"满"——第 14 章以后你会看到，同一个 `main.c` 里同时有协议、PID、姿态映射、RTOS 四件事。教程的任务就是把它一层层拆开。

---

## 九、开讲之前，需要你补充 3 样东西（不阻塞，可以边学边补）

1. **接线**：TB6612 的 PWMA/PWMB/AIN1/AIN2/BIN1/BIN2 实际接哪几个脚？编码器 A/B 相是否按 `TIM3=PA6/PA7`、`TIM4=PB6/PB7` 接的 nRF 是 3.3 V 还是 5 V 转 3.3 V？
   → 一份**接线表或照片**即可。没有它，第 6/7/11 章的"现象"只能靠猜。
2. **电机参数**：型号（JGB37-520？）、减速比、编码器线数（11 线还是 13 线）。
   → 第 7、14 章要拿它验算 `52 计数/圈` 和 `9.27666` 到底对不对。
3. **你那份"学习总纲"的原文**：如果就是 `三面题八阶段代码阶梯` + PDF，回我一句"就是它"；如果是别的文件，发我，我按它重排第五节。

---

## 十、下一轮你会收到什么

你只要发**第 1 批**：`FreeRTOS小车\USER\main.c`（一个文件）。

我会按固定结构给你**第 1 章《从复位到 main：芯片上电后的 100 毫秒》**：
【本节目标】【先看现象：上电那一刻发生了什么】【代码逐段拆解（第 1–180 行，只讲 main + 任务创建骨架）】【背后的知识点：启动文件 / 向量表 / 时钟树 / 72 MHz 是怎么来的 / 为什么必须 `RCC_APB2PeriphClockCmd`】【关键调用链：`Reset_Handler → SystemInit → main → vTaskStartScheduler`】【常见坑：hd 启动文件、`NVIC_PriorityGroupConfig(NVIC_PriorityGroup_4)` 为什么是 4、`delay_init()` 里改了 SysTick】【动手练习 3 个】【本章小结】。

**本章学完的验收标准**（先给你，提前有个底）：
- [ ] 能在 Keil 里单步执行，看到程序从 `Reset_Handler` 走进 `main`
- [ ] 能说出 `SystemInit()` 把 8 MHz 变成 72 MHz 用了哪两级倍频
- [ ] 能把第 1 章 3 个练习改完并上板看到现象

---

*本文档由"第 0 步"生成，后续每章会以 `01 …`、`02 …` 递增命名，放在本文件夹内。*
