tomorrozy/gesture-control-car/docs/01-八阶段教程/阶段一_双机通信_V2.md

---
title: 阶段一 主教程 双机通信
tags:
  - RM电控
  - STM32/阶段一
  - STM32/外设/UART
  - STM32/协议
version: V2
updated: 2026-10-23
code_base:
  - FreeRTOS小车/SYSTEM/usart/usart.c
  - FreeRTOS小车/SYSTEM/usart/usart.h
  - FreeRTOS小车/USER/main.c
  - 遥控/User/main.c
---

> [!danger] 🚨 版本交接指令
> 请将旧版 `阶段一_主教程_双机通信_V1.md` 移入回收站，保存此 `_V2` 文件，并把 `Debug_阶段一_双机通信_V1.md` 与全库双链改指本文件。

# 阶段一 · 主教程 · 双机通信

> [!tip] 配套错题本
> 本阶段排错专用：[[Debug_阶段一_双机通信_V2]]

---

## 📡 本章前置知识点雷达

> [!info] 预习指南：在啃代码之前，先认识这些“硬核名词”
> 本章围绕以下 5 个概念展开。

| 知识点名称 | 一句话通俗解释 | 在本章代码中的角色 |
| :--- | :--- | :--- |
| **UART 异步串行** | 两根线按约定速度一位一位传，不共享时钟。 | `usart.c` 初始化 PA9/PA10 |
| **波特率 8N1** | 每秒多少位、几位数据、有无校验、几位停止位。 | `uart_init(115200)` |
| **中断接收 RXNE** | 收到一个字节就打断 CPU。 | `USART1_IRQHandler` |
| **自定义协议帧** | 给数据套“信封”：帧头/长度/数据/校验/帧尾。 | `Protocol_Pack / Unpack` |
| **printf 重定向** | 让 `printf` 的字从串口出去。 | `fputc` + `#pragma import` |

---

## 一、本阶段任务与得分点

| 任务 | 要求 | 本工程现状 |
|:--:|---|---|
| 1 | UART 与电脑双向通信 | 串口通了，但主程序**裸 `printf` 调用 0 处**、无人读接收缓冲 |
| 2 | 两块板 UART 互连 | 未做（实际走 nRF 无线） |
| 3 | 自定义协议 `0xA5…0x0D` | 已完成（13 字节，两端对称） |
| 4 | UART + DMA | 未做（`DMA_Init`/`USART_DMACmd` 各 0 处） |

---

## 二、代码结构总览

| 文件 | 行数 | 作用 | 本章重点行 |
|---|:--:|---|---|
| `SYSTEM\usart\usart.c` | 132 | 初始化 + printf 重定向 + 接收状态机 | 10–33、53–61、63–101、103–130 |
| `SYSTEM\usart\usart.h` | 38 | 缓冲长度、接收开关 | 1–37 |
| `USER\main.c`（小车） | 393 | 协议解包、`uart_init(115200)` | 22–55、145、192 |
| `User\main.c`（遥控） | 220 | 协议打包、发 32 字节 | 23–24、75–93、131–165 |

---

## 三、逐行精讲

### 3.1 半主机开关与标准库桩（usart.c 10–25 行）

```c
//加入以下代码,支持printf函数,而不需要选择use MicroLIB
#if 1
#pragma import(__use_no_semihosting)
//标准库需要的支持函数
struct __FILE
{
	int handle;

};
FILE __stdout;
//定义_sys_exit()以避免使用半主机模式
void _sys_exit(int x)
{
	x = x;
}
```

【第 10 行】注释：说明这段是为了“不勾 MicroLIB 也能用 printf”。
【第 11 行】`#if 1`：总开关，改 0 整段失效。
【第 12 行】`#pragma import(__use_no_semihosting)`：禁止半主机。
【第 13 行】注释。
【第 14 行】`struct __FILE`：标准库要求的文件句柄类型。
【第 15 行】`{` 开始。
【第 16 行】`int handle;` 成员。
【第 18 行】`};` 结束。
【第 20 行】`FILE __stdout;`：给 stdout 一个实体。
【第 22 行】`_sys_exit`：空实现骗过链接器。
【第 23–25 行】函数体 `{ x = x; }`，把参数用掉避免告警。

> [!abstract] 人话翻译
> 这段只为“让 `printf` 能编译、能链接”：工程没勾 MicroLIB，标准库要求补文件句柄类型、stdout 实体、退出函数，补完就不走半主机。

### 3.2 fputc：把字符塞进串口（usart.c 27–32 行）

```c
int fputc(int ch, FILE *f)
{
	while((USART1->SR&0X40)==0);//循环发送,直到发送完毕
    USART1->DR = (u8) ch;
	return ch;
}
```

【第 27 行】重定义 C 库“输出一个字符”。
【第 28 行】函数体开始。
【第 29 行】等 `SR` 的 bit6（TC，发送完成），没完成原地等。
【第 30 行】把字符写进 `DR`，硬件按波特率发出。
【第 31 行】返回字符。
【第 32 行】函数结束。

> [!abstract] 人话翻译
> `printf("Hi")` 会逐字符调用它：先等上一字节彻底发完（TC），再写新字节进数据寄存器，文字就从 PA9 流出。`0x40` 等的是“发完”，比等“寄存器空”更稳。

### 3.3 串口初始化 · 时钟与引脚（usart.c 63–80 行）

```c
void uart_init(u32 bound){
	GPIO_InitTypeDef GPIO_InitStructure;
	USART_InitTypeDef USART_InitStructure;
	NVIC_InitTypeDef NVIC_InitStructure;

	RCC_APB2PeriphClockCmd(RCC_APB2Periph_USART1|RCC_APB2Periph_GPIOA, ENABLE);
	...
	GPIO_InitStructure.GPIO_Pin = GPIO_Pin_9;
	GPIO_InitStructure.GPIO_Speed = GPIO_Speed_50MHz;
	GPIO_InitStructure.GPIO_Mode = GPIO_Mode_AF_PP;
	GPIO_Init(GPIOA, &GPIO_InitStructure);
	...
	GPIO_InitStructure.GPIO_Pin = GPIO_Pin_10;
	GPIO_InitStructure.GPIO_Mode = GPIO_Mode_IN_FLOATING;
	GPIO_Init(GPIOA, &GPIO_InitStructure);
```

【第 63 行】`uart_init(u32 bound)`：参数是波特率。
【第 64–66 行】三个结构体：GPIO、USART、NVIC。
【第 69 行】同时开 USART1 与 GPIOA 时钟。
【第 72 行】`GPIO_Pin_9`：PA9 = TX。
【第 73 行】`50MHz` 输出速度。
【第 74 行】`AF_PP`：复用推挽（交给串口外设）。
【第 75 行】写入 GPIOA 配置。
【第 78 行】`GPIO_Pin_10`：PA10 = RX。
【第 79 行】`IN_FLOATING`：浮空输入。
【第 80 行】写入配置。

> [!abstract] 人话翻译
> 先给串口和 GPIOA 通电，再把 PA9 设成“喇叭”（复用推挽）、PA10 设成“耳朵”（浮空输入）。两个模式不对称，这是 UART 的标准接法。

### 3.4 中断与串口参数（usart.c 83–101 行）

```c
	NVIC_InitStructure.NVIC_IRQChannel = USART1_IRQn;
	NVIC_InitStructure.NVIC_IRQChannelPreemptionPriority=3 ;
	NVIC_InitStructure.NVIC_IRQChannelSubPriority = 3;
	NVIC_InitStructure.NVIC_IRQChannelCmd = ENABLE;
	NVIC_Init(&NVIC_InitStructure);
	...
	USART_InitStructure.USART_BaudRate = bound;
	USART_InitStructure.USART_WordLength = USART_WordLength_8b;
	USART_InitStructure.USART_StopBits = USART_StopBits_1;
	USART_InitStructure.USART_Parity = USART_Parity_No;
	USART_InitStructure.USART_HardwareFlowControl = USART_HardwareFlowControl_None;
	USART_InitStructure.USART_Mode = USART_Mode_Rx | USART_Mode_Tx;
	USART_Init(USART1, &USART_InitStructure);
	USART_ITConfig(USART1, USART_IT_RXNE, ENABLE);
	USART_Cmd(USART1, ENABLE);
}
```

【第 83 行】选中 USART1 中断通道。
【第 84 行】抢占优先级 3。
【第 85 行】子优先级 3（本工程 `main.c:143` 用 Group_4，子优先级位宽 0，此值实际不生效）。
【第 86 行】使能该中断。
【第 87 行】写入 NVIC。
【第 91 行】波特率 = `bound`（实际调用 115200）。
【第 92 行】8 位数据。
【第 93 行】1 位停止。
【第 94 行】无校验。
【第 95 行】无硬件流控。
【第 96 行】收发都开。
【第 98 行】写入串口参数。
【第 99 行】开 RXNE 中断（收到字节就进中断）。
【第 100 行】串口总开关。
【第 101 行】函数结束。

> [!abstract] 人话翻译
> 顺序是：引脚 → 中断 → 通信暗号（115200 8N1、无流控）→ 中断使能 → 总开关。少一步都会“看着正常但不通”。

### 3.5 接收状态机前半（usart.c 103–119 行）

```c
void USART1_IRQHandler(void)
{
	u8 Res;

	if(USART_GetITStatus(USART1, USART_IT_RXNE) != RESET)
		{
		Res =USART_ReceiveData(USART1);

		if((USART_RX_STA&0x8000)==0)
			{
			if(USART_RX_STA&0x4000)
				{
				if(Res!=0x0a)USART_RX_STA=0;
				else USART_RX_STA|=0x8000;
				}
```

【第 103 行】中断函数名必须与向量表一致。
【第 104 行】函数体开始。
【第 105 行】`u8 Res;` 暂存字节。
【第 107 行】确认是 RXNE 引起中断。
【第 109 行】读走数据（读 DR 清 RXNE，防反复进中断）。
【第 111 行】bit15 = 接收完成。
【第 113 行】bit14 = 已收到过 0x0D。
【第 115 行】应是换行却不是 → 整帧作废。
【第 116 行】回车+换行齐 → 置完成位。
【第 119 行】未收到 0x0D 的分支开始。

> [!abstract] 人话翻译
> 中断里先确认“确实收到字节”，立刻读走；再看状态位：若已见回车，就只等换行——是换行举旗“收完”，不是就作废。

### 3.6 接收状态机后半（usart.c 120–130 行）

```c
				if(Res==0x0d)USART_RX_STA|=0x4000;
				else
					{
					USART_RX_BUF[USART_RX_STA&0X3FFF]=Res ;
					USART_RX_STA++;
					if(USART_RX_STA>(USART_REC_LEN-1))USART_RX_STA=0;
					}
				}
			}
     }
}
```

【第 120 行】收到 0x0D 只置 bit14，不存。
【第 121 行】否则是普通数据。
【第 123 行】用低 14 位当索引存字节。
【第 124 行】计数 +1。
【第 125 行】超 199 清零，防写穿缓冲。
【第 126–130 行】收尾闭合花括号。

> [!abstract] 人话翻译
> 普通字节写缓冲、计数加一，超限整体清零；0x0D 只标记。一个 16 位变量同时当“两个标志 + 计数器”，省内存但读取必须掩码。

### 3.7 协议定义与结构体（main.c 22–40 行）

```c
/* ==================== 通信协议（内联） ==================== */
#define FRAME_HEAD        0xA5
#define FRAME_TAIL        0x0D

#define GESTURE_NONE   0
#define GESTURE_FWD    1
#define GESTURE_BACK   2
#define GESTURE_LEFT   3
#define GESTURE_RIGHT  4
#define GESTURE_STOP   5

#define PAYLOAD_LEN  9
#define FRAME_LEN    (4 + PAYLOAD_LEN)   /* = 13 */

typedef struct {
    float   pitch;
    float   roll;
    uint8_t gesture;
} AttitudePayload_t;
```

【第 22 行】协议直接内联在 `main.c`，没有独立协议文件。
【第 23–24 行】帧头 `0xA5`、帧尾 `0x0D`。
【第 26–31 行】6 个手势编号 0~5。
【第 33 行】数据区 9 字节。
【第 34 行】整帧 = 4 + 9 = 13。
【第 36–40 行】结构体：两个 `float` + 一个 `uint8_t`。

> [!abstract] 人话翻译
> 13 字节 = 帧头 1 + 长度 1 + pitch 4 + roll 4 + gesture 1 + 校验 1 + 帧尾 1。`PAYLOAD_LEN=9` 是数据区长度，不是整帧长度——最容易记混。

### 3.8 解包：四道验身再取值（main.c 42–55 行）

```c
static int Protocol_Unpack(const uint8_t *buf, int len, AttitudePayload_t *p)
{
    uint8_t chk = 0, i;
    if (len != FRAME_LEN)             return -1;
    if (buf[0] != FRAME_HEAD)         return -1;
    if (buf[1] != PAYLOAD_LEN)        return -1;
    if (buf[len - 1] != FRAME_TAIL)   return -1;
    for (i = 1; i < 2 + PAYLOAD_LEN; i++) chk ^= buf[i];
    if (chk != buf[2 + PAYLOAD_LEN])  return -1;
    memcpy(&p->pitch,   buf + 2, 4);
    memcpy(&p->roll,    buf + 6, 4);
    p->gesture = buf[10];
    return 0;
}
```

【第 42 行】`static int`：仅本文件可见，成功 0、失败 −1。
【第 43–44 行】函数体与变量。
【第 45 行】长度必须 13。
【第 46 行】帧头必须 `0xA5`。
【第 47 行】长度字节必须 9。
【第 48 行】末字节必须 `0x0D`。
【第 49 行】第 1~10 字节逐字节异或。
【第 50 行】与第 11 字节比对。
【第 51 行】第 2~5 字节 → `pitch`。
【第 52 行】第 6~9 字节 → `roll`。
【第 53 行】第 10 字节 → `gesture`。
【第 54–55 行】返回成功 / 函数结束。

> [!abstract] 人话翻译
> 解包像验票：长度、票头、编号、撕口，最后对防伪码（异或）。用 `memcpy` 避免 float 对齐问题。

### 3.9 打包：清黑板、填格子、算防伪码（遥控 main.c 75–93 行）

```c
static int Protocol_Pack(const AttitudePayload_t *p, uint8_t *out)
{
    uint8_t chk = 0, i;
    memset(out, 0, 32);
    out[0] = FRAME_HEAD;
    out[1] = PAYLOAD_LEN;
    memcpy(out + 2, &p->pitch, 4);
    memcpy(out + 6, &p->roll,  4);
    out[10] = p->gesture;
    for (i = 1; i < 2 + PAYLOAD_LEN; i++) chk ^= out[i];
    out[2 + PAYLOAD_LEN] = chk;
    out[3 + PAYLOAD_LEN] = FRAME_TAIL;
    return FRAME_LEN;
}
```

【第 75 行】打包函数。
【第 76–77 行】函数体与变量。
【第 79 行】`memset(out, 0, 32)`：清 **32** 字节（运输层定长）。
【第 81–82 行】填帧头、数据区长度。
【第 83–84 行】两个 float。
【第 85 行】手势放第 10 字节。
【第 88–89 行】异或校验，放第 11 字节。
【第 90 行】帧尾放第 12 字节。
【第 92 行】返回有效长度 13。
【第 93 行】函数结束。

> [!abstract] 人话翻译
> 打包与解包完全对称：先擦 32 字节黑板，再按格子填；返回 13 告诉调用方“前 13 字节有效”。

### 3.10 真正发送：13 字节补成 32 字节（遥控 main.c 131、164–165 行）

```c
    uint8_t tx_frame[32]; // 固定32字节缓冲
...
        /* ★ 强制发送 32 字节 */
        NRF24L01_SendData(tx_frame, 32);
```

【第 131 行】固定 32 字节缓冲。
【第 164 行】注释强调强制 32 字节。
【第 165 行】把整包交给 nRF 驱动。

> [!abstract] 人话翻译
> **协议 13 字节，运输 32 字节**：后 19 个 0 只是把包撑满到 nRF 要求的定长。

---

## 四、硬件与现象对照

| 代码配置 | 引脚 | 外部接什么 | 现象 |
|---|---|---|---|
| `AF_PP` | PA9 | → USB-TTL 的 RXD | 串口助手能收到字符 |
| `IN_FLOATING` | PA10 | ← USB-TTL 的 TXD | 板子能收电脑发的字节 |
| 115200 8N1 | — | 助手设 115200 | 参数不一致就乱码 |
| 接收中断 | — | — | 发 `abc\r\n` 后 `USART_RX_STA` 变 `0x8003` |

> [!warning] 盲区提示
> 代码只说明 PA9/PA10 被配成串口，**没有排针位置和 USB-TTL 接线**。以板子丝印为准：PA9→RXD、PA10→TXD、GND→GND。

---

## 五、本阶段缺口

| 任务 | 现状 | 要补 |
|:--:|:--:|---|
| 1 电脑双向 | 串口就绪，但 0 处裸 `printf`、无人读缓冲 | 任务里加一行 `printf` 验证 |
| 2 两板 UART | 未做 | 遥控端补 `usart.c`，PA9/PA10 交叉接小车 |
| 3 协议 | 已完成 | 无 |
| 4 DMA | 未做 | 发 `DMA1_Channel4`、收 `DMA1_Channel5` + 空闲中断（手册固定映射） |

---

## 六、防幻觉审计报告

> [!success] 🛡️ 防幻觉审计报告
> 1. **代码出处核实**：是。`fputc`、`_sys_exit`、`uart_init`、`USART1_IRQHandler`、`USART_RX_STA`、`USART_RX_BUF`、`USART_REC_LEN`、`FRAME_HEAD/TAIL`、`PAYLOAD_LEN`、`FRAME_LEN`、`AttitudePayload_t`、`Protocol_Pack/Unpack`、`tx_frame[32]`、`NRF24L01_SendData` 均来自你提供的文件并标行号。
> 2. **库的纯洁性**：未混用。仅 StdPeriph（`GPIO_Init`/`USART_Init`/`NVIC_Init`/`USART_ITConfig`），无 `HAL_`。
> 3. **脑补排查**：否。引脚 PA9/PA10 来自 `usart.c:72/78`；排针位置、USB-TTL 接线标为盲区；未编造函数。
> 4. **本次悬空依赖**：`xTaskGetTickCount` 未出现；`printf` 依赖 `usart.c:27` 的 `fputc`（已提供）。**代码级盲区：无**。

---

## 七、版本与勘误记录

| 版本 | 日期 | 变更 |
|:--:|---|---|
| V1 | 2026-10-23 | 首版 |
| V1.1 | 2026-10-23 | QA 修正 3.1/3.2 行号偏移（`FILE __stdout`→20、`_sys_exit`→22、`fputc`→27、`while`→29、`DR`→30） |
| **V2** | **2026-10-23** | **按宪法重建**：加入版本交接指令；补齐 usart.h/收发调用行号；把“0 处 printf”精确为“裸 printf 调用 0 处”；`USART_RX_STA` 位域与 `0x8003` 示例复核通过 |

#RM电控 #STM32 #UART #协议
