tomorrozy/gesture-control-car/docs/01-八阶段教程/阶段二_电机驱动_V2.md

---
title: 阶段二 主教程 电机驱动
tags:
  - RM电控
  - STM32/阶段二
  - STM32/外设/TIM
  - STM32/电机
  - STM32/编码器
version: V2
updated: 2026-10-23
code_base:
  - FreeRTOS小车/HARDWARE/LED/PWM.c
  - FreeRTOS小车/HARDWARE/LED/Motor.c
  - FreeRTOS小车/HARDWARE/LED/Encoder.c
  - FreeRTOS小车/HARDWARE/LED/led.c
  - FreeRTOS小车/HARDWARE/LED/led.h
  - FreeRTOS小车/USER/main.c
---

> [!danger] 🚨 版本交接指令
> 请将旧版 `阶段二_主教程_电机驱动_V1.md` 移入回收站（已归档到 `_归档_V1\`），保存此 `_V2` 文件，并把 `Debug_阶段二_电机驱动_V2.md` 与全库双链改指本文件。

# 阶段二 · 主教程 · 电机驱动

> [!tip] 配套错题本
> 本阶段排错专用：[[Debug_阶段二_电机驱动_V2]]

---

## 📡 本章前置知识点雷达

> [!info] 预习指南：在啃代码之前，先认识这些“硬核名词”
> 本章围绕以下 5 个概念展开。

| 知识点名称 | 一句话通俗解释 | 在本章代码中的角色 |
| :--- | :--- | :--- |
| **PWM 占空比** | 快速开关电源，开得越久平均功率越大。 | `PWM.c`，CCR 0~100 |
| **时基 PSC/ARR** | 把 72 MHz 心跳分频、计数，得到目标频率。 | `PWM.c:27–33` |
| **H 桥方向控制** | 两根方向脚决定电流方向。 | `Motor.c:29–61` |
| **编码器四倍频** | A/B 相每个边沿都计数。 | `Encoder.c:45` |
| **减速比 1:13** | 电机转 13 圈，输出轴转 1 圈。 | 换算速度时要除以 13 |

> [!success] 硬件已核对（来源：嘉立创 Board1 原理图，2026-10-24）
> TB6612 六线：`PWMA=PA0`、`PWMB=PA1`、`AIN1=PB13`、`AIN2=PB12`、`BIN1=PB14`、`BIN2=PB15`；`STBY=3.3V`（常使能，代码不驱动）。
> 编码器：左 `PA6/PA7`、右 `PB6/PB7`，供电 **3.3 V**（H2/H3 排针）。
> 详见 [[00_嘉立创硬件解析_原理图与软硬映射]]。
> ⚠️ 仍待实物：编码器 A/B **线序**（计数符号反了就交换 A/B）、LED 高低有效（图纸未见 LED，代码按高电平写）、编码器**线数**（52=4×线数 → 13，仍是反推值）。

---

## 一、本阶段任务与得分点

| 任务 | 要求 | 现状 |
|:--:|---|---|
| 1 | PWM 开环调速与正反转 | 代码齐全 |
| 2 | 转速（rad/s）、位置（rad） | 只有 0~100 标度，系数待核实（见 3.11） |
| 3 | 按键切模式 + LED 指示 | 小车端无按键；LED 只初始化 |
| 4 | OLED 显示模式/转速/位置 | 四行里无模式、无位置 |

---

## 二、代码结构总览

| 文件 | 行数 | 作用 | 重点行 |
|---|:--:|---|---|
| `HARDWARE\LED\PWM.c` | 73 | TIM2 两路 PWM，20 kHz | 8–49、58–73 |
| `HARDWARE\LED\Motor.c` | 61 | 方向 + 占空比合成 | 9–21、29–61 |
| `HARDWARE\LED\Encoder.c` | 116 | TIM3/TIM4 编码器接口 | 13–51、56–91、99–116 |
| `HARDWARE\LED\led.c` / `led.h` | 37 / 22 | LED 初始化与引脚宏 | `led.c:23–35`、`led.h:16–17` |
| `USER\main.c` | 393 | 测速换算、输出、显示 | 261–266、295–296、353–390 |

---

## 三、逐行精讲

### 3.1 PWM 初始化 · 时钟与引脚（PWM.c 8–21 行）

```c
void PWM_Init(void)
{
	GPIO_InitTypeDef GPIO_InitStructure;
	RCC_APB1PeriphClockCmd(RCC_APB1Periph_TIM2, ENABLE);
	RCC_APB2PeriphClockCmd(RCC_APB2Periph_GPIOA, ENABLE);

	GPIO_InitStructure.GPIO_Mode = GPIO_Mode_AF_PP;
	GPIO_InitStructure.GPIO_Pin = GPIO_Pin_0 | GPIO_Pin_1;
	GPIO_InitStructure.GPIO_Speed = GPIO_Speed_50MHz;
	GPIO_Init(GPIOA, &GPIO_InitStructure);
```

【第 8 行】函数定义：无参数，上电调用一次。
【第 10 行】声明 GPIO 配置结构体。
【第 12 行】开 TIM2 时钟（TIM2 挂 APB1）。
【第 13 行】开 GPIOA 时钟。
【第 17 行】`AF_PP`：复用推挽，引脚交给定时器。
【第 18 行】`GPIO_Pin_0 | GPIO_Pin_1`：即 PA0 与 PA1。
【第 19 行】输出速度档位 `50MHz`。
【第 20 行】写入配置。

> [!abstract] 人话翻译
> 先给定时器和 GPIOA 通电，再把 PA0/PA1 切成“定时器专用”。漏开时钟的现象是“程序在跑、引脚没波形”，编译器不报错。

### 3.2 PWM 初始化 · 时基（PWM.c 24–33 行）

```c
	TIM_InternalClockConfig(TIM2);
	TIM_TimeBaseInitTypeDef TIM_TimeBaseInitStructure;
	TIM_TimeBaseInitStructure.TIM_ClockDivision = TIM_CKD_DIV1;
	TIM_TimeBaseInitStructure.TIM_CounterMode = TIM_CounterMode_Up;
	TIM_TimeBaseInitStructure.TIM_Period = 100 - 1;
	TIM_TimeBaseInitStructure.TIM_Prescaler = 36 - 1;
	TIM_TimeBaseInitStructure.TIM_RepetitionCounter = 0;
	TIM_TimeBaseInit(TIM2, &TIM_TimeBaseInitStructure);
```

【第 24 行】选内部时钟源（源码注释：不调用默认也是内部时钟）。
【第 27 行】声明时基结构体。
【第 28 行】滤波时钟不分频（不影响时基单元的计数频率）。
【第 29 行】向上计数。
【第 30 行】`100 - 1`：ARR=99，计 0~99 共 100 个数。
【第 31 行】`36 - 1`：PSC=35，实际分频 36（写值 = 实际值 − 1）。
【第 32 行】重复计数器仅高级定时器使用。
【第 33 行】写入时基。

> [!abstract] 人话翻译
> 频率 = 72 MHz ÷ 36 ÷ 100 = 20 kHz。20 kHz 超出人耳敏感区，电机不啸叫；CCR 0~100 就是 0~100% 占空比。
> **72 MHz 的出处**：`system_stm32f10x.c` 里 `SYSCLK_FREQ_72MHz` 生效、`SetSysClockTo72()` 配 `RCC_CFGR_PLLMULL9`，配合 `stm32f10x.h` 的 `HSE_VALUE = 8000000`。本段代码只给了 PSC/ARR，**主频不是本文件写的**。

### 3.3 PWM 初始化 · 输出比较（PWM.c 35–48 行）

```c
	TIM_OCInitTypeDef TIM_OCInitStructure;
	TIM_OCStructInit(&TIM_OCInitStructure);
	TIM_OCInitStructure.TIM_OCMode = TIM_OCMode_PWM1;
	TIM_OCInitStructure.TIM_OCPolarity = TIM_OCPolarity_High;
	TIM_OCInitStructure.TIM_OutputState = TIM_OutputState_Enable;
	TIM_OCInitStructure.TIM_Pulse = 0;
	TIM_OC1Init(TIM2, &TIM_OCInitStructure);
	TIM_OC2Init(TIM2, &TIM_OCInitStructure);
	TIM_Cmd(TIM2, ENABLE);
}
```

【第 36 行】声明输出比较结构体。
【第 37 行】`TIM_OCStructInit`：先填默认值，避免未赋值成员是随机数。
【第 40 行】`TIM_OCMode_PWM1`：PWM 模式 1。
【第 41 行】`TIM_OCPolarity_High`：高电平有效。
【第 42 行】`TIM_OutputState_Enable`：输出使能。
【第 43 行】`TIM_Pulse = 0`：初始 CCR=0（0% 占空比，上电不转）。
【第 44–45 行】通道 1、2 都初始化。
【第 48 行】`TIM_Cmd`：启动定时器（总闸）。

> [!abstract] 人话翻译
> 三件事：模式、极性、初值。最后 `TIM_Cmd` 是总开关，和串口的 `USART_Cmd` 一个道理。

### 3.4 改占空比（PWM.c 58–73 行）

```c
void PWM_SetCompare1(uint16_t Compare)
{
	TIM_SetCompare1(TIM2, Compare);
}

void PWM_SetCompare2(uint16_t Compare)
{
	TIM_SetCompare2(TIM2, Compare);
}
```

【第 58 行】设置通道 1 的 CCR。
【第 60 行】写 CCR1（对应 PA0）。
【第 70 行】设置通道 2 的 CCR。
【第 72 行】写 CCR2（对应 PA1）。

> [!abstract] 人话翻译
> 占空比 = CCR/(ARR+1) = CCR/100（源码 55–56 行注释写的就是 `Duty = CCR1 / (ARR + 1)`）。函数名里的 1/2 是定时器通道，不直接等于左右轮，左右由 `Motor.c` 决定。

### 3.5 电机初始化（Motor.c 9–21 行）

```c
void Motor_Init(void)
{
	RCC_APB2PeriphClockCmd(RCC_APB2Periph_GPIOB, ENABLE);
	GPIO_InitTypeDef GPIO_InitStructure;
	GPIO_InitStructure.GPIO_Mode = GPIO_Mode_Out_PP;
	GPIO_InitStructure.GPIO_Pin = GPIO_Pin_12 | GPIO_Pin_13 | GPIO_Pin_14 | GPIO_Pin_15;
	GPIO_InitStructure.GPIO_Speed = GPIO_Speed_50MHz;
	GPIO_Init(GPIOB, &GPIO_InitStructure);
	PWM_Init();
}
```

【第 9 行】函数定义。
【第 12 行】开 GPIOB 时钟（方向脚在此）。
【第 14 行】声明结构体。
【第 15 行】普通推挽输出。
【第 16 行】PB12~PB15 四根方向脚。
【第 18 行】写入配置。
【第 20 行】顺带初始化 PWM。

> [!abstract] 人话翻译
> 每个电机需要“2 根方向脚 + 1 路 PWM”。这里先配方向脚，再调 PWM 初始化，所以外部只需调用 `Motor_Init`。

### 3.6 左轮输出（Motor.c 29–45 行）

```c
void Motor_SetPWM(uint8_t n, int8_t PWM)
{
	if (n == 1)
	{
		if (PWM >= 0)
		{
			GPIO_SetBits(GPIOB, GPIO_Pin_12);
			GPIO_ResetBits(GPIOB, GPIO_Pin_13);
			PWM_SetCompare1(PWM);
		}
		else
		{
			GPIO_ResetBits(GPIOB, GPIO_Pin_12);
			GPIO_SetBits(GPIOB, GPIO_Pin_13);
			PWM_SetCompare1(-PWM);
		}
	}
```

【第 29 行】`Motor_SetPWM(uint8_t n, int8_t PWM)`：`n` 选电机，PWM 是**8 位有符号**（±100 有效）。
【第 31 行】左轮分支。
【第 33 行】非负视为正转。
【第 35–36 行】PB12 高、PB13 低。
【第 37 行】占空比 = `PWM`。
【第 41–43 行】反转时两脚互换，CCR 取 `-PWM`。
【第 45 行】分支结束。

> [!abstract] 人话翻译
> 先定方向、再给占空比。反过来会在换向瞬间产生反向电流尖峰，驱动芯片容易发烫。

### 3.7 右轮输出（Motor.c 46–61 行）

```c
	else if (n == 2)
	{
		if (PWM >= 0)
		{
			GPIO_ResetBits(GPIOB, GPIO_Pin_14);
			GPIO_SetBits(GPIOB, GPIO_Pin_15);
			PWM_SetCompare2(PWM);
		}
		else
		{
			GPIO_SetBits(GPIOB, GPIO_Pin_14);
			GPIO_ResetBits(GPIOB, GPIO_Pin_15);
			PWM_SetCompare2(-PWM);
		}
	}
}
```

【第 46 行】右轮分支。
【第 48 行】非负视为正转。
【第 50–51 行】PB14 低、PB15 高——与左轮极性相反。
【第 52 行】占空比。
【第 56–58 行】反转互换。
【第 61 行】函数结束。

> [!abstract] 人话翻译
> 左右方向脚极性相反，通常是右电机镜像安装后用软件补的。若换电机后车原地打转，就调这里。

### 3.8 编码器初始化 · 左轮（Encoder.c 13–30 行，节选）

```c
	RCC_APB1PeriphClockCmd(RCC_APB1Periph_TIM3, ENABLE);
	RCC_APB2PeriphClockCmd(RCC_APB2Periph_GPIOA, ENABLE);
	...
	GPIO_InitStructure.GPIO_Mode = GPIO_Mode_IPU;
	GPIO_InitStructure.GPIO_Pin = GPIO_Pin_6 | GPIO_Pin_7;
	GPIO_InitStructure.GPIO_Speed = GPIO_Speed_50MHz;
	GPIO_Init(GPIOA, &GPIO_InitStructure);
	...
	TIM_TimeBaseInitStructure.TIM_Period = 65536 - 1;
	TIM_TimeBaseInitStructure.TIM_Prescaler = 1 - 1;
	...
	TIM_TimeBaseInit(TIM3, &TIM_TimeBaseInitStructure);
```

【第 13–14 行】开 TIM3 与 GPIOA 时钟。
【第 18 行】`GPIO_Mode_IPU`：上拉输入（霍尔编码器多为开漏）。
【第 19 行】`GPIO_Pin_6 | GPIO_Pin_7`：PA6/PA7 两相。
【第 21 行】写入 GPIO 配置。
【第 27 行】ARR=65535（16 位满量程）。
【第 28 行】PSC=0（不分频）。
【第 30 行】写入时基。

> [!warning] 代码块排版说明
> 本块**省略了源码第 25、26、29 行**（`TIM_ClockDivision`、`TIM_CounterMode`、`TIM_RepetitionCounter`），并用 `...` 表示省略。**行号声明对应原始文件**；逐字原文见 `Encoder.c:13–30`。

> [!abstract] 人话翻译
> 编码器模式就是让外部脉冲驱动定时器计数。两相输入必须上拉，计数器开满 16 位、不分频，保证 20 ms 内不漏脉冲。

### 3.8.5 输入捕获与滤波（Encoder.c 33–51 行）

```c
	TIM_ICInitTypeDef TIM_ICInitStructure;
	TIM_ICStructInit(&TIM_ICInitStructure);
	TIM_ICInitStructure.TIM_Channel = TIM_Channel_1;
	TIM_ICInitStructure.TIM_ICFilter = 0xF;
	TIM_ICInit(TIM3, &TIM_ICInitStructure);
	TIM_ICInitStructure.TIM_Channel = TIM_Channel_2;
	TIM_ICInitStructure.TIM_ICFilter = 0xF;
	TIM_ICInit(TIM3, &TIM_ICInitStructure);
	TIM_EncoderInterfaceConfig(TIM3, TIM_EncoderMode_TI12, TIM_ICPolarity_Rising, TIM_ICPolarity_Rising);
	TIM_Cmd(TIM3, ENABLE);
```

【第 33 行】声明输入捕获结构体。
【第 34 行】先填默认值，避免未赋值成员是随机数。
【第 37 行】配置通道 1。
【第 38 行】`TIM_ICFilter = 0xF`：最大滤波档，滤掉电机换向毛刺。
【第 39 行】写入通道 1 配置。
【第 40 行】配置通道 2。
【第 41 行】同样是 `0xF` 滤波。
【第 42 行】写入通道 2 配置。
【第 45 行】`TIM_EncoderMode_TI12`：A/B 两相都计数（四倍频）；两个 `Rising` 表示都不反相。
【第 51 行】启动 TIM3。

> [!warning] 源码注释里的两个关键约束（原始第 47–49 行）
> ① 编码器模式下 `Rising/Falling` **不再表示“上升沿/下降沿”，而是表示“是否反相”**；
> ② `TIM_EncoderInterfaceConfig` **必须在 `TIM_ICInit` 之后调用**，否则输入捕获的配置会覆盖它。

> [!abstract] 人话翻译
> 先给两个通道配滤波（`0xF` 最大档，抗毛刺），再告诉定时器“这是编码器接口、两相都计数”。顺序反了会被覆盖——这是源码注释专门警告过的坑。

### 3.9 右轮反相（Encoder.c 56–63、85 行）

```c
	RCC_APB1PeriphClockCmd(RCC_APB1Periph_TIM4, ENABLE);
	RCC_APB2PeriphClockCmd(RCC_APB2Periph_GPIOB, ENABLE);
	GPIO_InitStructure.GPIO_Mode = GPIO_Mode_IPU;
	GPIO_InitStructure.GPIO_Pin = GPIO_Pin_6 | GPIO_Pin_7;
	GPIO_Init(GPIOB, &GPIO_InitStructure);
	...
	TIM_EncoderInterfaceConfig(TIM4, TIM_EncoderMode_TI12, TIM_ICPolarity_Rising, TIM_ICPolarity_Falling);
```

【第 56–57 行】开 TIM4 与 GPIOB 时钟。
【第 60 行】上拉输入。
【第 61 行】PB6/PB7。
【第 63 行】写入 GPIO 配置。
【第 85 行】第二相配 `Falling` → **反相**，抵消右电机镜像安装。

> [!abstract] 人话翻译
> 一圈计数 = 4 × 线数。代码常数是 **52** → 反推线数 = 52 ÷ 4 = **13**。
> ⚠️ **归属说明**：你确认的是**减速比 1:13**；**编码器线数尚未确认**（在嘉立创 BOM 里，我没读到），「13 线」目前是**反推值**，需核实后当事实。

### 3.10 读增量（Encoder.c 99–116 行）

```c
int16_t Encoder_Get(uint8_t n)
{
	int16_t Temp;
	if (n == 1)
	{
		Temp = TIM_GetCounter(TIM3);
		TIM_SetCounter(TIM3, 0);
		return Temp;
	}
	else if (n == 2)
	{
		Temp = TIM_GetCounter(TIM4);
		TIM_SetCounter(TIM4, 0);
		return Temp;
	}
	return 0;
}
```

【第 99 行】返回“自上次调用以来的增量”。
【第 102 行】`int16_t Temp`：有符号，反转时为负。
【第 103–107 行】左轮：读 CNT 后立刻清零。
【第 109–113 行】右轮同样。
【第 115 行】非法参数返回 0。

> [!abstract] 人话翻译
> 读一次就清零，所以拿到的是“这 20 ms 转了多少”。代价是位置信息被丢掉，想测位置要自己累加。

### 3.11 增量 → 速度（main.c 261–266 行）

```c
        encL = Encoder_Get(1);
        encR = Encoder_Get(2);

        /* 将 0~20 映射为 0~100 */
        g_act_left  = (encL / 52.0f / 0.02f / 9.27666f) * 5.0f;
        g_act_right = (encR / 52.0f / 0.02f / 9.27666f) * 5.0f;
```

【第 261–262 行】各读一次增量。
【第 265–266 行】÷52（每电机圈计数）÷0.02（20 ms 周期）÷9.27666 ×5。

> [!warning] 用 1:13 核对（算术推导）
> 物理正确式：`输出轴 rev/s = enc ÷ 52 ÷ 0.02 ÷ 13`。
> 代码除的是 **9.27666** → 结果偏大 `13 ÷ 9.27666 ≈ 1.40`，即**反馈被高估约 40%**。
> 输出轴每圈计数 = 52 × 13 = **676**。修正：两处改 `13.0f`，然后重调 Ki。
> ⚠️ 该推导依赖两个前提：线数=13（反推值，待确认）、减速比=13（你已确认）。

> [!abstract] 人话翻译
> 量纲对、系数错。反馈尺子偏大，PID 收敛到的真实速度就偏低，且参数被迫加大。

### 3.12 其余两个任务：LED 与 OLED（led.h / led.c / main.c 节选）

```c
#define LED0 PCout(13)// PB5
#define LED1 PAout(5)// PA5
...
  RCC_APB2PeriphClockCmd(RCC_APB2Periph_GPIOC|RCC_APB2Periph_GPIOA, ENABLE);
  GPIO_InitStructure.GPIO_Pin = GPIO_Pin_13;
  GPIO_Init(GPIOC, &GPIO_InitStructure);
  GPIO_SetBits(GPIOC,GPIO_Pin_13);
  GPIO_InitStructure.GPIO_Pin = GPIO_Pin_5;
  GPIO_Init(GPIOA, &GPIO_InitStructure);
  GPIO_SetBits(GPIOA,GPIO_Pin_5);
```

【led.h 第 16 行】`LED0 = PCout(13)`：由 `GPIOC` + 13 号脚推导为 PC13。
【led.h 第 17 行】`LED1 = PAout(5)`：由 `GPIOA` + 5 号脚推导为 PA5。
【第 23 行】同时开 GPIOC 与 GPIOA 时钟。
【第 25 行】选 13 号脚。
【第 28 行】初始化 GPIOC。
【第 29 行】PC13 置高。
【第 31 行】选 5 号脚。
【第 34 行】初始化 GPIOA。
【第 35 行】PA5 置高。

```c
        OLED_Clear();
        OLED_ShowChinese(1, 1, "姿态：");
        OLED_ShowString(48, 1, str, 8);
        OLED_Update();
```

【第 353 行】`OLED_Clear()`：清显存。
【第 356 行】显示中文“姿态：”。
【第 358 行】显示数值字符串。
【第 390 行】`OLED_Update()`：整块刷屏。

> [!warning] 反向核对补漏（不是幻觉，是原教程漏检）
> ① `led.c` 把 **PA5** 配成输出并拉高，而 `nRF24L01_API.c:6` 的 `NRF_MOSI` 也是 `PAout(5)`——**同一根脚被两个模块抢**；`main.c` 只在 `:148` 调过一次 `LED_Init`，之后再没操作 LED。
> ② 小车工程里**没有 `key.c`**（文件数 0），所以“按键切模式”在本工程无实现。

> [!abstract] 人话翻译
> LED 只是“初始化并拉高”，之后没人动它；PA5 还和无线模块的数据线撞车。按键代码只存在于遥控端，小车端没有。

---

## 四、硬件与现象对照

| 代码动作 | 引脚/现象 |
|---|---|
| `Motor_SetPWM(1,40)` | PB12 高、PB13 低，PA0 输出 40% → 左轮正转 |
| `Motor_SetPWM(1,-40)` | PB12 低、PB13 高 → 左轮反转 |
| `Motor_SetPWM(2,40)` | PB14 低、PB15 高 → 右轮正转 |
| 手转轮子 | `Encoder_Get(1/2)` 返回正负增量 |
| `Encoder_Get` 调用周期 | 20 ms（`main.c:303`） |

> [!success] 已确认 / 仍待实物
> ✅ 已由原理图确认：六根控制线对应、`STBY=3.3V`、编码器引脚（`PA6/PA7`、`PB6/PB7`）与 3.3 V 供电。
> ⚠️ 仍需实物：① 编码器 A/B 相对线序（手转看计数正负，反了交换）；② LED 高低有效（图纸未见 LED，若未焊则此项无意义）；③ 电机 `AO1/AO2`、`BO1/BO2` 与左右轮实物线序（架空单轮测试）。
> 依据：[[00_嘉立创硬件解析_原理图与软硬映射]]

---

## 五、本阶段缺口

| 任务 | 现状 | 要补 |
|:--:|:--:|---|
| 1 PWM | 完整 | 架空开环测试 |
| 2 转速/位置 | 标度值，系数待核实；无位置 | 核实线数后改 `13.0f`；加位置累加 |
| 3 按键+LED | 无 | 移植 `key.c`；LED 用 PC13（推导名） |
| 4 OLED | 四行 | 加“模式/位置” |

---

## 六、防幻觉审计报告

> [!success] 🛡️ 防幻觉审计报告
> 1. **代码出处核实**：是。`PWM_Init`、`PWM_SetCompare1/2`、`Motor_Init`、`Motor_SetPWM`、`Encoder_Init`、`Encoder_Get`、`LED_Init`、`g_act_left/right`、`OLED_Clear/ShowChinese/ShowString/Update` 均来自你提供的文件并标行号。
> 2. **库的纯洁性**：未混用，仅 StdPeriph（`GPIO_Init`/`TIM_TimeBaseInit`/`TIM_OC1Init`/`TIM_EncoderInterfaceConfig`/`RCC_APBxPeriphClockCmd`），无 `HAL_`。
> 3. **脑补排查**：否。引脚全部来自 `GPIO_Init` 与 `#define`；TB6612 接线、STBY、编码器相序标为待确认；`52→13 线`标为反推值；`1.40 倍`、`676` 为算术推导。
> 4. **本次悬空依赖**：`printf`（阶段一）、`Encoder_Get` 调用方（阶段三/七）、`led.h` 宏推导的 PC13/PA5（源码未直接写字面量）。**代码级盲区：无**。

---

## 七、版本与修复记录

| 版本 | 日期 | 变更 |
|:--:|---|---|
| V1 | 2026-10-23 | 首版 |
| V1.1 | 2026-10-23 | QA 复审：修正 3.2/3.3/3.8/3.10 行号，补 3.8.5、3.12，纠正“13 线”归因 |
| **V2** | **2026-10-23** | **刑侦级重建**：全篇按源码逐行复核（107 项），补齐输入捕获/滤波/官方注释约束、LED/OLED 模块；所有“反推值/手册事实/待确认”均显式标注来源与前提 |
