tomorrozy/gesture-control-car/docs/02-图解字典/总索引.md

# 00 图解字典 · 总索引（八阶段 + 进阶拓展）

> 这里是「看图说话」专属文件夹。所有硬件接线图、数据流图、架构图都放这里，
> **每张 Mermaid 图的正下方**都紧跟两个模块：`👀 看图说话（大白话）` + `📖 字母缩写词典`。
> 读图规则：先看图 → 再看导游解说 → 最后查词典；三步走完，图里不会再有你看不懂的字母。

## 一、八阶段地图（题目 → 你工程里的落地）

| 阶段 | 名称 | 这个阶段真正在解决的问题 | 图解文档 | 你工程里的实现情况 |
| :--- | :--- | :--- | :--- | :--- |
| 一 | 双机通信基础 | 两块板子怎么“说上话”：串口接线、帧格式、DMA | [阶段一双机通信](00_图解字典_阶段一双机通信.md) | ✅ 协议（0xA5/0x0D）已实现；串口仅在车端用于调试/VOFA+；DMA 未实现 |
| 二 | 电机驱动基础 | 怎么让电机转、转多快、往哪转、怎么测速 | [阶段二电机驱动](00_图解字典_阶段二电机驱动.md) | ✅ PWM 20kHz、方向控制、编码器四倍频、OLED 显示均已实现 |
| 三 | 双机通信控制电机 | 从“能发消息”到“发命令能干活” | [阶段三通信控电机](00_图解字典_阶段三通信控电机.md) | ✅ 手势帧 → 解包 → 方向 + 速度 → 电机 |
| 四 | 蓝牙/无线通信 | 剪断线，隔空喊话；无线为什么要校验 | [阶段四无线通信](00_图解字典_阶段四无线通信.md) | ✅ 用 nRF24L01（2.4G）替代 HC-05 蓝牙，多通道接收 |
| 五 | MPU6050 姿态解算 | 手怎么“感觉”到倾斜；为什么角度会抖会漂 | [阶段五姿态解算](00_图解字典_阶段五姿态解算.md) | ✅ 软件 I2C + 互补滤波；yaw 不用（无磁力计） |
| 六 | 手势控制单个电机 | 角度 → 手势编号 → 电机动作 | [阶段六手势控制](00_图解字典_阶段六手势控制.md) | ✅ 15° 阈值四方向 + 停止，先判 pitch 再判 roll |
| 七 | 速度闭环 PID | “想要 60 实际 45”→ 再多给多少电；怎么整定 | [阶段七速度闭环PID](00_图解字典_阶段七速度闭环PID.md) | ✅ 20ms 闭环、Kp=2.0/Ki=1.5/Kd=0、最小 PWM 30 补偿、VOFA+ 打印 |
| 八 | 手势控制小车 | 左右轮差速 → 前进/后退/左转/右转；多任务调度 | [阶段八手势控小车](00_图解字典_阶段八手势控小车.md) | ✅ 两驱动轮差速 + 三个 FreeRTOS 任务；四电机/CAN 未做 |

## 二、进阶拓展（选做加分项）现状

> 所有文档里出现的引脚、协议字段、参数，原始出处都在 [00_图解字典_事实核对表.md](00_图解字典_事实核对表.md)（并已与 `_hw/` 里的 Altium 原理图截图逐条核对）。

| 拓展项 | 题目要求 | 你工程里的情况 | 说明 |
| :--- | :--- | :--- | :--- |
| FreeRTOS | 按键扫描 / PID / 通信 / 显示用 FreeRTOS 管理 | ✅ 已实现 | `FreeRTOS小车/USER/main.c`：静态创建 `task_rx`(3) / `task_ctrl`(2) / `task_disp`(1)，互斥量保护共享变量 |
| CAN 通信 | 用 CAN 收发器驱动支持 CAN 的电机 | ❌ 未实现 | 工程里没有 CAN 代码；答辩时如实说“方案预留，当前用 TB6612 + PWM” |
| 上位机调参 | VOFA+ 或自写上位机实时显示并在线改 PID | ⚠️ 部分实现 | 已用 `printf`（USART1 115200）打印，可接 VOFA+ 看波形；**在线改 PID 参数未做** |

## 三、答辩串讲主线（一分钟把八阶段串成一句话）

> 手带上 MPU6050 测出 pitch/roll（五）→ 超过 15° 判成手势（六）→ 装进 0xA5/0x0D 的帧（一）→ 用 nRF24L01 隔空发（四）→ 小车端收包、五道校验后解包（三）→ 目标速度做差速分配（八）→ 速度环 PID 用编码器反馈算 PWM（七）→ TB6612 驱动电机（二）→ 三个 FreeRTOS 任务并行跑（进阶）。

## 四、看图习惯（建议照做）

1. **先找“谁是谁”**：图里每个框都是实物或芯片，左边通常是“大脑”，右边通常是“干活的”。
2. **再看“线”**：实线＝真实连线，虚线＝可选/调试/反馈，箭头方向＝数据流向。
3. **遇到菱形**：那是“判断”，导游解说里一定会写“什么情况走哪边”。
4. **遇到字母**：翻本图下方的词典，不要跳过去。
5. **对照代码**：每篇文档末尾都有「代码对照表」，点进去就是带逐行注释的源码（`annotated/` 目录）。
