tomorrozy/gesture-control-car/docs/03-零基础落地包/00-零基础落地包 索引.md

---
tags:
  - STM32/导航
  - 电控组
  - 零基础
aliases:
  - 零基础落地包
  - 落地包索引
  - 零基础落地包 索引
type: MOC
status: ✅ 新增
project: STM32手势小车
---

# 00 零基础落地包 · 索引

> [!summary] 这一页解决什么问题
> 库里的**知识**已经很全（原理 19 篇 + 八阶段答卷 + 代码汇编），
> 但「**一个零基础的人，从今天开始，到小车真的按八个阶段跑起来**」这条路上，
> 有几段是**空着的**：**买什么 → 装什么软件 → 电怎么供 → 每阶段怎么做完算过 → 线到底接哪个脚**。
>
> ★ **本文件夹就是补这几段的**，一共 6 篇，按顺序做。

## 六篇的定位

| 序 | 文档 | 一句话 | 什么时候用 | 预计耗时 |
|:--:|---|---|---|:--:|
| **1** | [[01 器材采购与到货核对清单]] | **照着买、照着点货**（含规格、数量、预算、选型避坑） | ★ **下单前** | 1~2 小时 |
| **2** | [[02 工具链与软件安装配置]] | Keil5 / 器件包 / ST-Link / CH340 / 串口助手，**把库里的安装包串成步骤** | ★ **收货当天** | 2~3 小时 |
| **3** | [[05 引脚权威总表与阶段接线改动]] | **一张表说清所有引脚**，并列出**必须改接的 3 根线** | ★ **接线前必看** | 30 分钟 |
| **4** | [[06 各阶段编译前补文件清单]] | ★ **二~七阶段的工程缺公共文件，不补就编不过**（含精确复制来源） | ★ **每次 F7 之前** | 20 分钟 |
| **5** | [[03 供电共地与上电安全]] | 电源树 + 电流估算 + 星型接地 + **第一次上电的正确姿势** | ★ **第一次接线前后** | 1 小时 |
| **6** | [[04 八阶段逐阶段操作与验收门禁]] | 八阶段**每阶段：开哪个工程 → 烧哪块板 → 看到什么 → 怎么算过** | ★ **每做一个阶段** | 全程用 |

> [!warning] 先读这一条：本副本有「半同步」问题
> 你现在打开的这份库（`桌面\Taurus\`）里，**同一批阶段目录存在两份**：
> - `一阶段\`~`八阶段\`（**不带数字前缀**）→ ★ **真实内容在这里**（本落地包的路径都以它为准）
> - `01 一阶段\`~`08 八阶段\`（**带数字前缀**）→ ⚠️ **空壳**，里面只有索引文件，没有代码
>
> 原因：`01 一阶段\`…这套目录是从**另一份更新的库**（`D:\Documents\Obsidian知识库\STM32手势小车\`）同步过来的**目录骨架**，
> 而正文/代码留在了旧布局里。**权威库在 D 盘那份**（0 断链），本副本有 139 条链接点不开。
>
> ★ 详见根目录的 **[[补充建议 零基础落地缺口清单]]** 第 1 节。

## 和库里已有文档的关系（不重复造）

| 你要做的事 | 本落地包 | 库里已有的、别丢的那一份 |
|---|---|---|
| 懂原理 | — | [[原理讲解 索引]]（19 篇） |
| 看每个阶段做了什么 | [[04 八阶段逐阶段操作与验收门禁]] | 各阶段 `综合答卷` / `完整代码汇编` / `MOC` |
| 编译前改参数 | [[04 八阶段逐阶段操作与验收门禁]] | 各阶段 `README_编译前必读 *.md`（★ 二~八阶段有，**一阶段缺**） |
| ★ 编译不过怎么办 | [[06 各阶段编译前补文件清单]] | 各阶段 `README_编译前必读 *.md` 的「还需要补的文件」 |
| 工程在哪、怎么打开 | [[02 工具链与软件安装配置]] | [[Keil 工程搭建说明]] |
| 接线图 | [[05 引脚权威总表与阶段接线改动]] | [[接线图索引]]、[[接线总图与总表]]、[[各阶段接线变化说明]] |
| 实测 11 步 + 参数回填 | [[03 供电共地与上电安全]]（上电前） | [[硬件实测清单]]（★ 上板那天的总清单） |
| 调 PID 看波形 | — | [[VOFA+ 教程 索引]]、[[VOFA+ 波形反查参数 A4 一键打印]] |
| 面试/答辩 | — | [[00 模拟面试 MOC]]、[[12 模拟面试题库 第三轮 故障模拟30题与答辩预演]] |
| 名词不懂 | — | [[STM32电控术语词典]] |

## 一条最短路径（照抄即可）

```text
① 下单        → [[01 器材采购与到货核对清单]]
② 装软件      → [[02 工具链与软件安装配置]]
③ 读引脚总表  → [[05 引脚权威总表与阶段接线改动]]（★ 先记住「阶段 8 要改 3 根线」）
④ 接线+上电   → [[03 供电共地与上电安全]]（★ 先不接电机、先量电压）
⑤ 补公共文件  → [[06 各阶段编译前补文件清单]]（★ 二~七阶段必做，否则 F7 报错）
⑥ 逐阶段做    → [[04 八阶段逐阶段操作与验收门禁]]（★ 一门不过不进下一门）
⑦ 调参数      → [[硬件实测清单]] 的「参数回填表」17 项
⑧ 出数据      → [[硬件实测清单]] 的「第三部分 实测记录」（答辩用）
```

> [!danger] 三句话，比任何文档都重要
> 1. **电机必须由电池供**，USB 只给逻辑电（PDF 硬性要求 1）。
> 2. **必须共地**：STM32、TB6612、电池、编码器、蓝牙的 GND 要连在一起。
> 3. **阶段 7 做完、进阶段 8 之前，有 3 根线必须改接**（PA3→STBY 拔掉、MPU6050 从 PB6/PB7 挪到 PB8/PB9、右电机/右编码器新增 PB3/PB4/PB6/PB7）——
>    ★ **不改就会出现「右轮抽搐」或「姿态全 0」**，见 [[05 引脚权威总表与阶段接线改动]]。

---

> 关联：[[补充建议 零基础落地缺口清单]]（★ 为什么补这五篇、还缺什么）｜ [[STM32手势小车 MOC]]（项目总览）｜ [[看我工作内容的顺序表]]（原有零基础总入口）
