tomorrozy/gesture-control-car/docs/03-零基础落地包/04-八阶段逐阶段操作与验收门禁.md

---
tags:
  - STM32/流程
  - 电控组
  - 零基础
aliases:
  - 八阶段操作手册
  - 阶段验收门禁
  - 04 八阶段逐阶段操作与验收门禁
type: 清单
status: ⬜ 待执行（硬件未搭建）
project: STM32手势小车
---

# 04 八阶段逐阶段操作与验收门禁

> [!summary] 这一页解决什么问题
> 库里的八阶段材料是**「答卷 + 代码讲解」**式的（每个阶段一篇 `综合答卷` + 一篇 `完整代码汇编`），
> **讲得清楚「为什么这么做」，但不方便「照着做」** ——
> 你得自己在 6 篇文档之间拼：「开哪个工程？烧哪块板？改哪个文件？看到什么算过？」
>
> ★ 这一篇把它压成**一张可执行的进度表 + 八张操作卡 + 一道门禁**。
> 详细原理仍然看原来的答卷，本文只负责「动作和验收」。

## 路径说明（★ 先看这一条）

> 你现在这份库（`桌面\Taurus\`）里，**真实内容在不带前缀的阶段目录**：
> `一阶段\`、`二阶段\` … `八阶段\`
> ⚠️ `01 一阶段\` … `08 八阶段\`（带前缀）是**空壳**，别进去找工程。
>
> **权威库**（`D:\Documents\Obsidian知识库\STM32手势小车\`）用的是**带前缀**目录：
> 把本文的 `一阶段\` 读作 `01 一阶段\`、`模拟面试\` 读作 `09 模拟面试\` 即可。

---

## 一、阶段门禁（★ 三条铁规）

| # | 铁规 | 为什么 |
|:--:|---|---|
| 1 | ★★ **上一阶段的「通过标准」没有全部打勾，不进下一阶段** | 八阶段是**递进**的：阶段 3 用阶段 1 的协议，阶段 7 用阶段 2 的编码器。带着未修的 bug 往上走，后面每个阶段都会「现象对不上」 |
| 2 | ★★ **每次只新增一个变量** | 这是库里的核心方法论。加了新东西出问题 → 一定是新加的那部分；不要把「加蓝牙」和「改协议」一起做 |
| 3 | ★★ **每次上电前两轮悬空** | 阶段 2 起就有电机；阶段 8 若「同号性」没验，一上电小车会冲出去 |

---

## 二、总表：逐阶段「开哪个工程 / 烧哪块板 / 改什么 / 怎么算过」

> [!warning] ★★ 动手前必读：**二~七阶段的工程不能直接编过**
> 它们**缺 2~3 个公共模块**（`OLED.c/h`、`OLED_Font.h`、`Key.c/h`、`Delay.c/h`），
> 不补的话 F7 第一条报错就是 `cannot open source input file "OLED.h"`。
> **只有「一阶段」和「八阶段」是拿来就能编的。**
> 👉 **补文件清单与精确来源：[[06 各阶段编译前补文件清单]]**（每个阶段开工前先做这一步）

| 阶段 | ★ 打开的工程（相对本库根） | 烧哪块板 | 接线新增 | ★ 编译前必改 | ★ 通过标准（关键 3 条） | 详细依据 |
|:--:|---|---|---|---|---|---|
| **一** | `一阶段\Keil工程\一阶段-任务1-串口双向\Project.uvprojx`<br>`…任务2-双机通信\`<br>`…任务3-自定义协议\`<br>`…任务4-UART+DMA\` | 任务 1 = 1 块<br>任务 2~4 = **2 块** | USB-TTL → PA9/PA10（**交叉**）；第二块板；OLED PB8/PB9 | ⚠️ **没有** `README_编译前必读 一阶段`（★ 库内缺此篇，见 [[补充建议 零基础落地缺口清单]]）<br>注意 `Serial.c` 与 `Frame.c` 的 `USART1_IRQHandler` **重复定义** | ① 串口助手能双向收发<br>② 两块板互相显示一致<br>③ 故意发错校验帧**被丢弃**且不影响后续 | [[一阶段 综合答卷]] |
| **二** | `二阶段\Keil工程\二阶段\Project.uvprojx` | **1 块**（单板） | TB6612（PA2/PA3/PA4/PA5）、编码器 PA6/PA7、LED PA1/PA0、按键 PB1/PB11、OLED | `Encoder.h` 的 `ENCODER_PPR / GEAR_RATIO`（★ 用手转一圈应 = **1560**） | ① 量 PA2 = **20 kHz**<br>② 手转一圈计数 = **1560**<br>③ 20% PWM 时读数**为正** | [[二阶段 综合答卷]]、`README_编译前必读 二阶段` |
| **三** | `三阶段\Keil工程\三阶段-发送端\`<br>`三阶段\Keil工程\三阶段-接收端\` | **2 块**（各烧一个） | ★ **一根线都没加**（还是 PA9/PA10 + 共地） | 缩放宏两端**共用同一个头文件** | ① 发 `-3.000` 电机**反转**<br>② **拔掉 TX 线 500ms 后自动停**<br>③ 超范围目标被**钳位** | [[三阶段 综合答卷]]、`README_编译前必读 三阶段` |
| **四** | `四阶段\Keil工程\四阶段-发送端\`<br>`四阶段\Keil工程\四阶段-接收端\` | **2 块** | **有线换蓝牙**：两块 HC-05，各接自己那块板 PA9/PA10 | HC-05 配置：一块 `ROLE=1`、一块 `ROLE=0`、`UART=9600`、`PSWD` 一致 | ① AT 模式 `AT` 返回 `OK`<br>② 上电后 LED **双闪**<br>③ 走远丢帧率**上升**（可量化） | [[四阶段 综合答卷]]、`README_编译前必读 四阶段` |
| **五** | `五阶段\Keil工程\五阶段\Project.uvprojx` | **1 块**（先单板调通） | MPU6050 → **PB6/PB7**（★ 与接线图写的 PB8/PB9 **不一样**，见 [[05 引脚权威总表与阶段接线改动]]） | ★ **MPU6050 的 AD0 接 GND**（地址 0x68）<br>`ATT_TAU_S` 互补滤波时间常数 | ① `WHO_AM_I` = **0x68**<br>② 静止 `az ≈ ±1g`<br>③ 互补滤波角度**平滑且不漂** | [[五阶段 综合答卷]]、`README_编译前必读 五阶段`、[[Yaw零飘问题详解]] |
| **六** | `六阶段\Keil工程\六阶段-手带端\`<br>`六阶段\Keil工程\六阶段-小车端\` | **2 块** | 先**有线**（任务 1）再换蓝牙（任务 2） | 迟滞双阈值（12° 进 / 7° 出）；心跳周期 20ms | ① 8°~15° 抖动时**状态不变**（迟滞生效）<br>② **保持手势 5 秒车不停**（心跳生效）<br>③ 拔手带端电源 → **500ms 停机** | [[六阶段 综合答卷]]、`README_编译前必读 六阶段` |
| **七** | `七阶段\Keil工程\七阶段-单板PID调试\`<br>`七阶段\Keil工程\七阶段-手带端\`<br>`七阶段\Keil工程\七阶段-小车端\` | 先 **1 块**（单板调 PID）<br>后 **2 块** | 编码器 PA6/PA7（**第一次有反馈**）；VOFA+ 用串口 | `PID_KP/KI/KD`（★ 初值 **8.0 / 1.2 / 0.0**，见 `七阶段\完整工程代码\小车端\main.c` L51-53）；映射死区 | ① VOFA+ **能看到目标 vs 实际波形**（★ 硬性要求 7）<br>② 手腕前倾转速**平滑增长**<br>③ OLED **四项都对** | [[七阶段 综合答卷]]、`README_编译前必读 七阶段` |
| **八** | `八阶段\Keil工程\八阶段-手带端\`<br>`八阶段\Keil工程\八阶段-小车端\` | **2 块** | ★★ **3 改 3 增**（PA3→STBY 拔掉；MPU6050 PB6/PB7→PB8/PB9；新增 PB3/PB4/PB6/PB7） | `Encoder.h` 的**左右符号**（★ 不做会飞车）、`Diff.h` 轮径**半径** 0.0325、`DiffMap.h`、PID 5.0/0.5/0.0 | ① **同号性**：小正 PWM → 两轮读数**都为正**<br>② 左右目标一正一负 → 两轮**反向转**<br>③ 前倾 → 两轮同向 `L≈R`；侧倾 → 两轮反向 | [[八阶段 综合答卷]]、`README_编译前必读 八阶段`、[[05 引脚权威总表与阶段接线改动]] |

> 💡 **单端 / 双端**：一阶段任务 1、二阶段、五阶段是**单板**；三/四/六/七/八阶段是**两块板各烧一个**。
> ⚠️ **双端工程只烧一端 = 另一端毫无反应** —— 这是新手第一次最容易卡的地方（[[Keil 工程搭建说明]] 已提醒）。

---

## 三、八张操作卡（照抄执行）

### 阶段一 · 双机通信基础

```text
目标：让两块板「能互相说话」，并让数据带帧头帧尾、错误帧被丢弃。

① 打开 一阶段\Keil工程\一阶段-任务1-串口双向\Project.uvprojx
② F7 编译 → F8 下载（★ 任务 1~4 依次做，每个都能单独编译烧录）
③ 任务 1：USB-TTL 的 TX→PA10、RX→PA9、GND→GND（★★ 交叉 + 共地）
④ 打开串口助手，按代码里的波特率打开 COM 口
⑤ 按键 → 串口助手应显示 Hello；电脑发字符 → OLED 应显示
⑥ 任务 2：把「电脑」换成第二块 STM32（还是交叉 + 共地）
⑦ 任务 3：做「故意发错校验」的测试 —— 错误帧必须被丢弃
⑧ 任务 4：改用 DMA，行为应与任务 3 完全一致

★ 卡住先看：一阶段 综合答卷 的「排错清单」；原理看 [[原理讲解 12 串口通信原理]]、[[原理讲解 14 自定义协议设计]]
★ 已知坑：Serial.c 与 Frame.c 都定义 USART1_IRQHandler → 只能留一个
★ 本阶段没有 README_编译前必读（库内缺失），编译前请照 [[02 工具链与软件安装配置]] 的固定配置核对
```

### 阶段二 · 电机驱动基础（★ 第一次有电机，先悬空）

```text
目标：把「闭环控制所需的零件」逐个造出来：PWM、测速、状态机、显示。

⓪ ★★ 先补文件：从江科大例程拷 OLED.c/h/OLED_Font.h、Key.c/h（★ 4 针 I2C 版）
   并「Add Existing Files to Group」加进工程 → 见 [[06 各阶段编译前补文件清单]]
① 打开 二阶段\Keil工程\二阶段\Project.uvprojx（★ 单板，先不用第二块）
② 接线：PA2→PWMA、PA3→STBY、PA4→AIN1、PA5→AIN2、
        PA6/PA7→编码器 A/B、OLED→PB8/PB9、按键 PB1/PB11、LED PA1/PA0
       ★ VM 接电池、VCC 见 [[03 供电共地与上电安全]]、★★ 全部共地
③ ★★ 两轮悬空后再上电
④ 编译前改 Encoder.h 的 PPR / 减速比（用手转一圈，累计计数必须 = 1560）
⑤ 先给 20% PWM（不接方向脚）→ 电机应转；再改方向脚 → 应反转
⑥ 示波器/逻辑分析仪量 PA2 → 应为 20 kHz
⑦ 悬空给 20% PWM → 读数必须为正（这是阶段 8「同号性」的预演）
⑧ 按 K1 切模式、看 OLED 三项（模式/转速/位置）、切到关控应「自由滑行」

★ 卡住先看：二阶段 综合答卷 的「排错清单」；`README_编译前必读 二阶段` 的「上电前检查清单」
```

### 阶段三 · 一块板发指令，另一块控电机

```text
目标：把阶段 1 的协议 + 阶段 2 的电机接起来（★ 接线一根都没加）。

⓪ ★★ 先补文件：发送端要 OLED.c/h/OLED_Font.h + Key.c/h，接收端要 OLED.c/h/OLED_Font.h
   （★ 4 针 I2C 版）→ 见 [[06 各阶段编译前补文件清单]]
① 打开 三阶段-发送端 / 三阶段-接收端（两个工程各烧一块板）
② 两块板 PA9/PA10 交叉 + 共地（有线，先别上蓝牙）
③ 发送端发 +3.000 rad/s → 接收端电机正转约 3 rad/s
④ 发 -3.000 → ★ 必须反转；发 0 → 停（滑行）
⑤ 按发送端按键切档位（1/3/5 rad/s）→ 接收端转速跟着变
⑥ ★ 拔掉 TX 线 → 500ms 后电机必须自动停（超时保护）
⑦ 发一个超范围目标（如 100 rad/s）→ 应被钳位到 100%，不溢出

★ 卡住先看：三阶段 综合答卷；原理看 [[原理讲解 15 丢包 心跳与超时]]
```

### 阶段四 · 蓝牙无线（★ 换介质，不改协议）

```text
目标：把 3 根杜邦线换成两个 HC-05；并学会量化链路可靠性。

⓪ ★★ 先补文件：发送端 OLED.c/h/OLED_Font.h + Key.c/h；接收端 OLED.c/h/OLED_Font.h
   → 见 [[06 各阶段编译前补文件清单]]
① 两块 HC-05 分别：按住按键上电 → 进 AT 模式（LED 约 2 秒闪一次）
② 串口助手 38400：一块 AT+ROLE=1（主机）、一块 AT+ROLE=0（从机）、
   都 AT+UART=9600,0,0；主机 AT+BIND=<从机地址>、AT+CMODE=0
③ 断开 AT 口，两块重新上电（不按键）→ ★ LED 应变「双闪/常亮」= 已连接
   一直快闪 = 没连上（查 ROLE / BIND / 波特率）
④ 两块板的 PA9/PA10 分别接各自的 HC-05（★ 仍然是 TX↔RX 交叉）
⑤ 烧 四阶段-发送端 / 四阶段-接收端 → 小车端应显示 RX:OK
⑥ 走远/遮挡 → 丢帧率应上升（这是「可量化」的证据）
⑦ ★ 给电机加速 → 观察蓝牙是否掉线（本阶段最容易踩的坑；解药是给 HC-05 并电容）

★ 卡住先看：四阶段 综合答卷 的「HC-05 配置」与「稳定性排查」；[[蓝牙通信使用说明]]
```

### 阶段五 · MPU6050 与姿态解算（★ 引脚与接线图不同，看清楚）

```text
目标：读出 pitch/roll，并理解「为什么必须融合两个传感器」。

⓪ ★★ 先补文件：OLED.c/h/OLED_Font.h + Key.c/h + Delay.c/h（★ Delay 也缺）
   → 见 [[06 各阶段编译前补文件清单]]
① 打开 五阶段\Keil工程\五阶段\Project.uvprojx（★ 单板）
② ★★ 接线：MPU6050 的 SCL→PB6、SDA→PB7（不是接线图上的 PB8/PB9！）
   ★ AD0 必须接 GND（地址 0x68）；OLED 仍在 PB8/PB9
③ 第一步永远是读 WHO_AM_I → 必须返回 0x68（0x00/0xFF = 没通）
④ 静止平放：az ≈ ±1g，ax/ay ≈ 0；手转轴看陀螺仪有响应
⑤ 零偏标定（静止约 1 秒）→ 重复两三次标定值应接近
⑥ 依次切 ATT_MODE_ACCEL（抖）/ COMPLEMENTARY（★ 平滑不漂）/ KALMAN
⑦ 绕垂直轴转 90° → ★ 观察 yaw 漂移（正好验证 [[原理讲解 07 yaw 零飘]]）

★ 卡住先看：五阶段 综合答卷；专题看 [[Yaw零飘问题详解]]
```

### 阶段六 · 手势 → 单电机（迟滞 + 心跳）

```text
目标：把姿态变成「手势指令」，并解决手抖与掉线两个问题。

⓪ ★★ 先补文件：手带端 OLED.c/h/OLED_Font.h + Delay.c/h；小车端 OLED.c/h/OLED_Font.h
   （★ 手带端不需要 Key）→ 见 [[06 各阶段编译前补文件清单]]
① 打开 六阶段-手带端 / 六阶段-小车端
② 任务 1 先用**有线**走通：手腕前倾 → 前进；回平 → 停
③ ★ 在 8°~15° 之间来回抖 → 状态必须**不变**（双阈值迟滞生效）
④ 任务 2 换蓝牙：行为必须与有线**完全一致**
⑤ ★ 保持手势 5 秒不动 → 车不能停（心跳生效）
⑥ 拔掉手带端电源 → 500ms 后小车必须停
⑦ 走远/遮挡 → 丢帧率可量化

★ 卡住先看：六阶段 综合答卷；原理看 [[原理讲解 11 迟滞与死区]]
```

### 阶段七 · 速度闭环 PID（★ 硬性要求 7 的证据在这里）

```text
目标：让电机「说转多快就转多快」，并用波形整定参数。

⓪ ★★ 先补文件：单板工程要 OLED.c/h/OLED_Font.h + Key.c/h + Delay.c/h；
   手带端/小车端各要 OLED.c/h/OLED_Font.h + Delay.c/h（★ 三个工程都要补）
   → 见 [[06 各阶段编译前补文件清单]]
① 先单板：打开 七阶段\Keil工程\七阶段-单板PID调试\（★ 不接蓝牙）
② 接 VOFA+（[[VOFA+ 教程 06 VOFA+ 配置傻瓜教程]]），确认能画出「目标 vs 实际」
③ 整定四步：只开 P（加到小幅振荡取 60%）→ 加 I 消静差 → 最后试 D（噪声大就保持 0）
④ 按键/串口改目标 → 转速跟随且响应及时
⑤ 再接 手带端 + 小车端（两块板）：姿态 → 目标速度 → 闭环
⑥ ★ 手腕缓慢前倾 → 转速应**平滑增长**（不是「咯噔」一下）
⑦ 手腕回平 → 转速回 0（死区生效）
⑧ ★★ 录一段 VOFA+ 波形存下来（**答辩硬性要求 7 的证据**）

★ 卡住先看：七阶段 综合答卷；[[VOFA+ 波形反查参数 A4 一键打印]]
```

### 阶段八 · 手势控制小车（★★ 三改三增，先验同号性）

```text
目标：两个轮子 → 能前进/后退/左转/右转/原地转的差速小车。

⓪ ✅ 本阶段**不需要补文件**：`手带端\`、`小车端\` 里已自带 OLED.c/h、OLED_Font.h、Delay.c/h，
   且工程已把它们加进去了 —— 直接 F7 就能编过（与一阶段一样是自包含的）。
① ★★ 先做「3 改 3 增」（见 [[05 引脚权威总表与阶段接线改动]]）：
   改 1：拔掉 PA3→STBY，STBY 改接 3.3V
   改 2：MPU6050 从 PB6/PB7 挪到 PB8/PB9（与 OLED 并接）
   改 3：MPU6050 的 AD0 接 GND
   增 1：PB3/PB4 → 右电机 BIN1/BIN2      （★ 需禁 JTAG，代码里 Board_Init 已做）
   增 2：PB6/PB7 → 右编码器 A/B          （★ 就是刚让出来的两个脚）
   增 3：PA3 → 右电机 PWMB（TIM2_CH4）
② 两轮悬空；只烧小车端、先不接蓝牙 → OLED 应显示 RX:LOST、STP 0%、两轮不转
   ★ 两轮若一转 → **立刻断电**（失联保护没生效）
③ ★★ 第 4 步（绝不能跳）：给小的正 PWM → OLED 上 l、r **都为正**
   哪个为负 → 把对应 ENCODER_DIR_L/R 改成 −1.0
④ 左右目标一正一负 → 两轮必须**反向转**
⑤ 接蓝牙，两端上电 → 小车端 RX:OK、默认 HLF 50%
⑥ 手腕前倾 → 两轮同向 L≈R、v 为正；侧倾 → 两轮反向（原地转）
⑦ 前倾+侧倾同时 → 一大一小（画弧）；放下手腕 → 目标回 0、电机停
⑧ ★ **最后**才整定 PID（八阶段有前馈，KI 要比七阶段小）

★ 卡住先看：`README_编译前必读 八阶段` 的「八、常见故障速查」
★ 底盘几何：轮半径填 0.0325（65mm 的**半径**，不是 0.065！）
```

---

## 四、阶段门禁打卡表（★ 打印，一格不打勾就不往下走）

| 阶段 | 门禁条件（全勾才放行） | ✔ |
|:--:|---|:--:|
| **一** | ⬜ 串口双向收发正常 ⬜ 两块板互显一致 ⬜ 错校验帧被丢弃 | ⬜ |
| **二** | ⬜ PWM 实测 20 kHz ⬜ 手转一圈 = 1560 ⬜ 20% PWM 读数为正 ⬜ 关控能滑行 | ⬜ |
| **三** | ⬜ 反向指令生效 ⬜ 拔线 500ms 自停 ⬜ 超范围被钳位 | ⬜ |
| **四** | ⬜ 两块 HC-05 LED 双闪 ⬜ RX:OK ⬜ 丢帧率可量化 ⬜ 电机加速不掉线 | ⬜ |
| **五** | ⬜ WHO_AM_I=0x68 ⬜ az≈1g ⬜ 互补滤波不漂 ⬜ 看得到 yaw 漂 | ⬜ |
| **六** | ⬜ 迟滞不抖 ⬜ 保持手势 5 秒不停 ⬜ 拔电源 500ms 自停 | ⬜ |
| **七** | ⬜ VOFA+ 波形可见 ⬜ 四步整定完成 ⬜ 前倾平滑增长 ⬜ **波形已存档** | ⬜ |
| **八** | ⬜ **同号性通过** ⬜ 左正右负两轮反向 ⬜ 前倾 L≈R ⬜ 侧倾原地转 ⬜ PID 整定完 | ⬜ |

---

## 五、★ 八阶段全程总验收（做出「完美运行」的那一天）

> 把下面 12 步一次走完，全程无异常 = **八个阶段全部通过**。
> 建议**录像**，答辩时比任何文档都有说服力。

| # | 做什么 | 期望 | ✔ |
|:--:|---|---|:--:|
| 1 | 电池 + 降压 + 开关接好，万用表确认 5V 与 VM 正常 | 5.00V / ≈电池电压 | ⬜ |
| 2 | 两块板都上电，不接电机，看 OLED | 正常显示，无花屏 | ⬜ |
| 3 | 接电机，两轮悬空，烧小车端（不接蓝牙） | `RX:LOST`、`STP 0%`、两轮不转 | ⬜ |
| 4 | 按 K1 切档 | `HLF/3/4/FUL/STP` 循环 | ⬜ |
| 5 | ★ 同号性复验 | l、r 都为正 | ⬜ |
| 6 | 接蓝牙，两端上电，先小车端后手带端 | LED 双闪，`RX:OK` | ⬜ |
| 7 | 手腕前倾 | 两轮同速前进，`v` 为正 | ⬜ |
| 8 | 手腕后倾 / 侧倾 / 原地转 | 后退 / 画弧 / 原地转 | ⬜ |
| 9 | 手腕回平 | 目标回 0，电机停 | ⬜ |
| 10 | 保持手势 5 秒 | 车不停（心跳） | ⬜ |
| 11 | 关掉手带端电源 | 500ms 后小车停 | ⬜ |
| 12 | ★ 把小车放地上，低速前倾直行 2 米 | 直线跑、不跑偏；**记录时间算实际速度** | ⬜ |

> ⚠️ **第 12 步是「从悬空到落地」的分水岭**：一旦落地，会出现打滑、负载变化、电池跌落，
> PID 手感可能变差 —— 这才是真正需要整定的时刻。
> ★ **库内所有参数至今都是估算值**（本项目从未在真车上跑过），落地后请照 [[硬件实测清单]] 回填。

---

## 六、硬性要求 8 条 · 最终对照

> 题目出自 `Taurus 2027电控组三面.pdf`（库根目录）。★ 注意 `STM32手势小车 MOC.md` 的清单里 **「代码规范」误编号为第 8 条**（有两行都是 8），本文按实际内容列出。

| # | 硬性要求 | 由哪个阶段完成 | 自验方式 | ✔ |
|:--:|---|---|---|:--:|
| 1 | **独立供电**（电池 + 降压，禁止 USB） | 阶段 2 起全程 | 拔掉所有 USB，车能跑 | ⬜ |
| 2 | **无线通信**（HC-05 或 NRF24L01） | 阶段 4 | 两块 HC-05 LED 双闪，无线能控 | ⬜ |
| 3 | **自定义协议**（帧头 `0xA5`、帧尾 `0x0D`） | 阶段 1 任务 3 | 抓包/串口打印能看到帧格式 | ⬜ |
| 4 | **姿态解算**（互补滤波或卡尔曼） | 阶段 5 | 切模式对比，角度平滑不漂 | ⬜ |
| 5 | **电机速度 PID 闭环** | 阶段 7（阶段 8 扩展成双轮） | VOFA+ 目标 vs 实际贴合 | ⬜ |
| 6 | **OLED 显示**（手势指令 / 目标速度 / 实际速度） | 阶段 6/7/8 | 八阶段显示两轮目标 + 实际 | ⬜ |
| 7 | **VOFA+ 打印闭环波形** | 阶段 7 任务 1 | ★ **波形截图/录像存档** | ⬜ |
| 8 | **手势控制小车**（前进/后退/左转/右转） | 阶段 8 | 第五节 12 步总验收 | ⬜ |
| （附） | 代码规范（模块化、注释、命名） | 每阶段 | 每个任务独立模块 + 注释 | ⬜ |

---

> 关联文档：
> - ★ 缺口总清单：[[补充建议 零基础落地缺口清单]]
> - ★ 引脚与改线：[[05 引脚权威总表与阶段接线改动]]
> - ★ 电源与上电：[[03 供电共地与上电安全]]
> - ★ 上板实测 11 步 + 回填 17 项：[[硬件实测清单]]
> - 工程一览（18 个）：[[Keil 工程搭建说明]]
> - 阶段索引：[[一阶段 MOC]] ｜ [[二阶段 MOC]] ｜ [[三阶段 MOC]] ｜ [[四阶段 MOC]] ｜ [[五阶段 MOC]] ｜ [[六阶段 MOC]] ｜ [[七阶段 MOC]] ｜ [[八阶段 MOC]]
