tomorrozy/gesture-control-car/docs/03-零基础落地包/05-引脚权威总表与阶段接线改动.md

---
tags:
  - STM32/硬件
  - 电控组
  - 零基础
  - 引脚
aliases:
  - 引脚总表
  - 引脚权威总表
  - 05 引脚权威总表与阶段接线改动
type: 说明
status: ✅ 按代码核对
project: STM32手势小车
---

# 05 引脚权威总表与阶段接线改动

> [!summary] 这一页解决什么问题
> 库里引脚信息**散在 6 处以上**（`Board.h` 注释、各阶段 `README_编译前必读`、`接线图索引`、`接线总图与总表`、`各阶段接线变化说明`、`引脚规划与改动说明`），
> **而且其中「接线类文档」和「阶段代码」有两处真实冲突**（见第四节）。
> 这一篇把它们**统一成一张表**，并明确 **★ 冲突时以谁为准**。
>
> ★ 本文所有结论均**逐一对照过源码宏定义**（文件与行号已标出）。

---

## 一、★ 手带端（戴在手腕上的那块板）引脚总表

| 引脚 | 功能 | 外设/模式 | 从哪阶段 | 备注 |
|---|---|---|---|---|
| **PA9** | 蓝牙 TX | USART1 复用推挽 | 4（有线从 1） | ★ 与 HC-05 的 **RXD** 相接 |
| **PA10** | 蓝牙 RX | USART1 上拉输入 | 4（有线从 1） | ★ 与 HC-05 的 **TXD** 相接 |
| **PB8** | I2C SCL | 软件 I2C（开漏） | 5 | ★ **OLED 与 MPU6050 共用**（阶段 8 起） |
| **PB9** | I2C SDA | 软件 I2C（开漏） | 5 | 同上 |
| **PB6** | MPU6050 SCL | 软件 I2C（开漏） | **5~7** | ⚠️ ★ **阶段 8 起 PB6/PB7 改作他用，MPU6050 必须挪到 PB8/PB9** |
| **PB7** | MPU6050 SDA | 软件 I2C（开漏） | **5~7** | 同上 |
| PA13 / PA14 | SWD 调试 | SWDIO / SWCLK | 全程 | ★ 保留，别禁用 |

**源码依据**：
- `八阶段\完整工程代码\手带端\MyI2C.h` L30-31 → `GPIO_Pin_8 / GPIO_Pin_9`
- `五阶段\完整工程代码\MyI2C.h` L19-20、`六阶段\完整工程代码\手带端\MyI2C.h` L19-20、`七阶段\完整工程代码\手带端\MyI2C.h` L19-20 → `GPIO_Pin_6 / GPIO_Pin_7`
- `八阶段\完整工程代码\手带端\main.c` L79-87（注释里的引脚说明与代码一致）

> [!note] 手带端**不需要**的引脚
> 手带端只用 `MyI2C / MPU6050 / Attitude / DiffMap / Diff / Frame / Timer / DisplayTx / OLED / Delay` 十个模块，
> **没有电机、没有编码器、没有按键、没有 LED**。
> ⚠️ 但 `手带端\Board.h` 与 `小车端\Board.h` **是同一个文件（哈希完全一致）**，
> 所以它顶部那张表里写着电机/编码器/按键 —— **那是小车端的表，手带端用不到，别被误导**。

---

## 二、★ 小车端（装在车上那块板）引脚总表

| 引脚 | 功能 | 外设/模式 | 阶段 1 | 2~7 | **8** | 备注 |
|---|---|:--:|:--:|:--:|:--:|---|
| **PA9** | 串口 TX | USART1 复用推挽 | ✅ | ✅ | ✅ | 与 HC-05 **RXD** 接；阶段 1 接 USB-TTL |
| **PA10** | 串口 RX | USART1 上拉输入 | ✅ | ✅ | ✅ | 与 HC-05 **TXD** 接 |
| **PA2** | 左电机 PWM（PWMA） | TIM2_CH3 复用推挽 | — | ✅ | ✅ | ARR=99、PSC=35 → 20kHz；CCR 直接是百分数 |
| **PA3** | **阶段 2~7：TB6612 的 STBY**<br>**阶段 8：右电机 PWM（PWMB）** | 阶段 2~7 推挽输出<br>阶段 8 TIM2_CH4 复用推挽 | — | ✅ | ★ **改了** | ⚠️★ **进阶段 8 必须把 PA3→STBY 这根线拔掉** |
| **PA4** | 左电机 AIN1 | 推挽输出 | — | ✅ | ✅ | 方向位 1 |
| **PA5** | 左电机 AIN2 | 推挽输出 | — | ✅ | ✅ | 方向位 2 |
| **PB3** | **右电机 BIN1** | 推挽输出 | — | — | ★ **新增** | ⚠️★ **复位后是 JTAG 的 JTDO，必须先 `GPIO_Remap_SWJ_JTAGDisable`** |
| **PB4** | **右电机 BIN2** | 推挽输出 | — | — | ★ **新增** | ⚠️同上（NJTRST） |
| **PA6** | 左编码器 A 相 | TIM3 编码器接口 | — | ✅（阶段 2 起） | ✅ | ★ **同号性**：给正 PWM 读数必须为正 |
| **PA7** | 左编码器 B 相 | TIM3 编码器接口 | — | ✅ | ✅ | 同上 |
| **PB6** | **阶段 5~7：MPU6050 SCL**<br>**阶段 8：右编码器 A 相** | 阶段 5~7 软件 I2C<br>阶段 8 TIM4 编码器接口 | — | ⚠️ 见左 | ★ **改了** | ⚠️★ **同一根针换功能，必须改接** |
| **PB7** | **阶段 5~7：MPU6050 SDA**<br>**阶段 8：右编码器 B 相** | 同上 | — | ⚠️ 见左 | ★ **改了** | 同上 |
| **PB8** | I2C SCL（OLED；阶段 8 起 + MPU6050） | 软件 I2C | ✅ | ✅ | ✅ | 全程不变 |
| **PB9** | I2C SDA（OLED；阶段 8 起 + MPU6050） | 软件 I2C | ✅ | ✅ | ✅ | 全程不变 |
| **PB1** | 按键 K1 | 上拉输入 | ✅ | ✅ | ✅ | 阶段 3 起用于切档/模式 |
| **PB11** | 按键 K2 | 上拉输入 | ✅ | ✅ | ✅（保留未用） | ★ 阶段 8 为了保住它，才把 MPU6050 挪去共用总线 |
| **PA1** | LED1（模式指示） | 推挽输出 | — | ✅ | ✅ | `Led.h` L15 |
| **PA0** | LED2（运行心跳） | 推挽输出 | — | ✅ | ✅ | `Led.h` L16 |
| **PA13 / PA14** | SWD 调试 | SWDIO / SWCLK | ✅ | ✅ | ✅ | ★ 禁 JTAG 时**必须保留 SWD**，否则下次下载不了 |
| **3.3V** | TB6612 的 STBY（常使能） | 电源（不占 GPIO） | — | 阶段 2~7 由 PA3 控制 | ★ **接 3.3V** | ★ **不接 = 电机完全不转且不报错** |

**源码依据**：
- `八阶段\完整工程代码\小车端\Board.h` L15-34（★ 该文件自称「唯一事实来源」，与本文一致）
- `二阶段\完整工程代码\Motor.h` L24-28、`Encoder.h`（TIM3 = PA6/PA7）
- `一阶段\完整工程代码\公共模块\{Key.c,OLED.c,Serial.c}`

---

## 三、★★ 阶段 7 → 阶段 8 必须做的「3 改 + 3 增」

> [!danger] 这是整套材料里**最容易漏、后果最明显**的一步
> 阶段 8 为了「两路 PWM + 两个编码器接口」，把引脚重排了一遍。
> **如果你沿用阶段 7 的接线直接烧阶段 8 的固件，一定出问题**，但报错现象会误导你。

| # | 动作 | 不改的后果 | 出处 |
|:--:|---|---|---|
| **改 1** | ★★ **拔掉 PA3 → TB6612 的 STBY 线，把 STBY 改接 3.3V** | 右轮**抽搐、时转时停**（PWM 在不停开关整片使能） | `八阶段 MOC` L188、`README_编译前必读 八阶段` L119 |
| **改 2** | ★★ **把 MPU6050 的 SCL/SDA 从 PB6/PB7 挪到 PB8/PB9**（与 OLED 并接） | **姿态读数全 0 或乱跳**，看 OLED 正常但车不动 | `八阶段 完整代码汇编` L462、`README_编译前必读 八阶段` L454 |
| **改 3** | ★ **MPU6050 的 AD0 必须接 GND**（地址 0x68） | 地址错 → 读不到 | `接线总图与总表` L87 |
| **增 1** | ★ **PB3 → 右电机 BIN1、PB4 → 右电机 BIN2** | 右轮完全不转 | `Board.h` L22-23 |
| **增 2** | ★ **PB6/PB7 → 右编码器 A/B 相** | 右轮没有反馈 → PID 失控 | `Board.h` L25 / L61-62 |
| **增 3** | ★ **PA3 → 右电机 PWMB（TIM2_CH4）** | 右轮没有调速能力 | `Board.h` L19 / L46 |

另加：**TB6612 的 AO1/AO2 → 左电机，BO1/BO2 → 右电机**。

> ★ 阶段 8 的 `Board.h` L37-38 已经把这两条写成警告：
> 「PB3/PB4 复位后是 JTAG 的 JTDO/NJTRST，不禁用 JTAG 则配了也没波形」
> 「若已按七阶段把 PA3 接到 TB6612 的 STBY，必须拆掉改接 3.3V」。

---

## 四、★ 文档冲突清单（已核实，**结论：以代码/阶段 README 为准**）

### 冲突 1（★ 最要命）：阶段 5~7 的 MPU6050 到底在 PB6/PB7 还是 PB8/PB9

| 说法 | 出处 | 内容 |
|---|---|---|
| **A. 代码 = PB6/PB7** | `五阶段\完整工程代码\MyI2C.h` L19-20；`六阶段\完整工程代码\手带端\MyI2C.h` L19-20；`七阶段\完整工程代码\手带端\MyI2C.h` L19-20；`五阶段\完整工程代码\README_编译前必读 五阶段.md` L42-43、L56、L103 | 「SCL→**PB6**、SDA→**PB7**（★ 不是例程的 PB10/PB11）」 |
| **B. 接线图 = PB8/PB9** | `接线\接线图索引.md` L27；`接线总图\各阶段接线变化说明.md` L132；`接线总图\接线总图与总表.md` L81-82；`接线\接线全过程 总图与分步.md` L104；`接线总图\面包板接线图\面包板接线图.md` L35 | 「五阶段 新增 **PB8/PB9** → MPU6050（与 OLED 共用）」 |

> [!warning] 结论
> **接线类文档画的是「最终（阶段 8）形态」的引脚，被套用到了阶段 5/6/7 上。**
> ★ **做阶段 5、6、7 时，MPU6050 接 PB6/PB7**（否则代码读不到，`WHO_AM_I` = 0x00）；
> ★ **做阶段 8 时，必须挪到 PB8/PB9**。
> 这处冲突会直接让零基础的人在阶段 5 卡住一整天，**必须修**（修法见 [[补充建议 零基础落地缺口清单]]）。

### 冲突 2：TB6612 的 VCC 接 5V 还是 3.3V

| 说法 | 出处 |
|---|---|
| **接 5V** | `二阶段\任务1\阶段二 任务1 PWM开环调速与正反转.md` L45/L48；`七阶段\完整工程代码\README_编译前必读 七阶段.md` L44；`六阶段\...README` L69 |
| **接 3.3V** | `接线总图\接线总图与总表.md` L70；`接线\接线全过程 总图与分步.md` L153 |

> ★ **结论**：为与 STM32 的 3.3V 电平匹配，**建议 VCC 接 3.3V**；
> 已接 5V 且功能正常的可以不改，但要**记进实测记录**（详见 [[03 供电共地与上电安全]] 第五节）。

### 冲突 3（轻微）：阶段 8 的定时器号写法

| 说法 | 出处 | 说明 |
|---|---|---|
| 控制周期用 **TIM1** | `八阶段\完整工程代码\README_编译前必读 八阶段.md` §3.1 | ★ 八阶段的正确做法 |
| 「由 **TIM4** 中断调用」 | `二阶段\完整工程代码\Encoder.h` L29、`七阶段\...Encoder.h` L29 | 那是二/七阶段的注释；★ 二/七阶段确实用 TIM4 做控制周期，**八阶段改成 TIM1**（TIM4 被右编码器占了） |

---

## 五、外设 / 定时器分配总表（阶段 8）

| 外设 | 用途 | 引脚 | 说明 |
|---|---|---|---|
| **TIM1** | 控制周期中断（10ms） | — | ★ 八阶段改用它（不是 SysTick、也不是 TIM4） |
| **TIM2** | 双路 PWM（20kHz） | PA2 (CH3) / PA3 (CH4) | ARR=99、PSC=35 |
| **TIM3** | 左编码器接口 | PA6 / PA7 | 硬件编码器模式 |
| **TIM4** | 右编码器接口 | PB6 / PB7 | ★ 八阶段新增 |
| **USART1** | 蓝牙（+ DMA） | PA9 / PA10 | 9600,8,N,1（两端一致） |
| **软件 I2C** | OLED (+MPU6050) | PB8 / PB9 | ★ 必须**全在主循环**，不能放中断 |
| **GPIO** | 方向 / 按键 / LED / STBY | PA4 PA5 PB3 PB4 / PB1 PB11 / PA1 PA0 / 3.3V | — |
| **调试** | SWD | PA13 / PA14 | 禁 JTAG 时**保留 SWD** |

> ★ **为什么八阶段必须重排引脚**：C8T6 只有 3 个通用定时器 + 1 个高级定时器，
> 而「编码器接口」必须**独占整个定时器的 CH1/CH2**，两路编码器就吃掉了 TIM3 和 TIM4。
> 推导过程见 `八阶段\引脚规划与改动说明.md`。

---

## 六、接线自查 10 条（★ 每次改完线都过一遍）

| # | 检查 | 为什么 |
|:--:|---|---|
| 1 | ★★ **TX 与 RX 交叉**（TX→RX，RX→TX） | 不交叉 = 两张嘴对喊，永远收不到 |
| 2 | ★★ **共地**：所有模块 GND 连到一起 | 不共地 = 乱码/读不到 |
| 3 | ★★ **电机两轮悬空**再上电 | 防冲出去 |
| 4 | ★ **STBY 电压 = 3.3V**（万用表量） | 不为高 → 电机完全不转且不报错 |
| 5 | ★ **TB6612 的 VM 有 12V、VCC 有 3.3V/5V** | 缺 VM 芯片不工作 |
| 6 | ★ **PA3 上到底接的是 STBY 还是 PWMB** | 阶段 8 混淆就会出现「右轮抽搐」 |
| 7 | ★ **MPU6050 接的是 PB6/PB7 还是 PB8/PB9** | 阶段 5~7 与阶段 8 **不一样** |
| 8 | ★ **MPU6050 的 AD0 是否接 GND** | 决定地址 0x68 / 0x69 |
| 9 | ★ **OLED 的 SCL/SDA 有没有接反** | 全黑屏 |
| 10 | ★ **电源正负极是否接反、杜邦线是否插到底** | 反接 = 烧板 |

---

## 七、想更细的话，看这几篇（各有侧重，别只看一篇）

| 想看什么 | 去哪 |
|---|---|
| 逐针总表 + 系统总图 | [[接线总图与总表]] |
| 每一步只新增哪些线 | [[接线全过程 总图与分步]] |
| 每阶段的接线变化与理由 | [[各阶段接线变化说明]] |
| 面包板实物摆放 | [[面包板接线图]] |
| 阶段 8 为什么这么排（取舍过程） | `八阶段\引脚规划与改动说明.md` |
| 代码里的「唯一事实来源」 | `八阶段\完整工程代码\小车端\Board.h` |
| 上电前的电压核对 | [[03 供电共地与上电安全]] |

---

> 关联文档：
> - ★ 上一步：[[02 工具链与软件安装配置]]
> - ★ 下一步：[[03 供电共地与上电安全]] → [[04 八阶段逐阶段操作与验收门禁]]
> - ★ 缺口总清单：[[补充建议 零基础落地缺口清单]]
