tomorrozy/gesture-control-car/docs/05-参考资料/Yaw零飘问题详解.md

---
tags:
  - STM32/阶段五
  - STM32/任务3
  - STM32/姿态解算
  - STM32/专题
  - 电控组
aliases:
  - Yaw零飘问题详解
  - yaw漂移
  - 航向角漂移
  - 磁力计融合
type: 专题
status: 已完成
project: STM32手势小车
stage: 第五阶段-姿态解算
---

# Yaw 零飘问题详解

> [!summary] 一句话总结
> yaw 会飘，是因为**没有任何传感器能直接测出它**。加速度计测的是重力方向，而绕重力轴旋转时重力方向**在传感器坐标系里的表示完全不变** —— 所以加速度计对 yaw 是"瞎"的。yaw 只能靠陀螺仪积分，而陀螺仪有零偏、有噪声、有温漂，积分就是**误差累加器**，必然越飘越远。
>
> **结论**：yaw 的漂移无法从原理上根除，只能**抑制**（零偏标定）或**引入外部绝对参考**（磁力计）。而手势控制**用不到 yaw**，所以本题正确的做法是**绕开它**。

> [!info] 配套
> 实测程序见 [[阶段五 任务3 角度稳定性与Yaw漂移]]，姿态解算原理见 [[阶段五 任务2 原理详解]]。

---

# 目录

1. [现象：什么是 yaw 零飘](#一现象什么是-yaw-零飘)
2. [根因一：加速度计对 yaw 完全无感](#二根因一加速度计对yaw完全无感)
3. [根因二：陀螺仪的六种误差](#三根因二陀螺仪的六种误差)
4. [误差如何累积：积分就是误差累加器](#四误差如何累积积分就是误差累加器)
5. [量化：单位换算与典型数值](#五量化单位换算与典型数值)
6. [方法一：零偏标定（必做）](#六方法一零偏标定必做)
7. [方法二：温度补偿](#七方法二温度补偿)
8. [方法三：静止检测 + 零速修正（ZUPT）](#八方法三静止检测--零速修正zupt)
9. [方法四：磁力计融合（根本解法）](#九方法四磁力计融合根本解法)
10. [方法五：外部绝对参考](#十方法五外部绝对参考)
11. [五种方法对比](#十一五种方法对比)
12. [本项目的结论：绕开它](#十二本项目的结论绕开它)
13. [完整可用代码](#十三完整可用代码)
14. [常见误区](#十四常见误区)

---

# 一、现象：什么是 yaw 零飘

## 1.1 定义

把 MPU6050 **完全静止**放在桌面上，什么都不做，只观察三个角度：

| 角度 | 静止时的表现 |
|---|---|
| **Pitch（俯仰）** | 稳定在某个值，波动 ±0.1° |
| **Roll（横滚）** | 稳定在某个值，波动 ±0.1° |
| **Yaw（偏航）** | **慢慢地、持续地往一个方向跑** ← 这就是零飘 |

**"零飘"的"零"指的是零输入** —— 没有任何转动输入，输出却一直在变。

## 1.2 怎么观察

用 [[阶段五 任务3 角度稳定性与Yaw漂移]] 的程序，平放模块不要碰，盯住串口输出：

```text
T(s) | Pitch |  Roll |   Yaw | Drift(deg/s) | Temp(C)
   1 |  12.3 |   3.5 |   0.1 |         0.09 |   29.5
  10 |  12.3 |   3.5 |   0.9 |         0.09 |
  30 |  12.3 |   3.5 |   2.7 |         0.09 |
  60 |  12.3 |   3.5 |   5.4 |         0.09 |
 120 |  12.3 |   3.5 |  10.8 |         0.09 |
```

**注意观察**：
- Pitch 和 Roll **纹丝不动**（波动几十毫度）
- Yaw **以固定速率线性增长**（这里约 0.09 °/s）

这个"固定速率"就是**残余零偏** —— 标定之后剩下的那部分。

## 1.3 典型数值范围

| 状态 | 漂移率 | 1 分钟累计 | 10 分钟累计 |
|---|---|---|---|
| **未标定**（直接用出厂值） | 0.5 ~ 5 °/s | 30 ~ 300° | 300 ~ 3000° |
| **静止标定后** | 0.02 ~ 0.5 °/s | 1 ~ 30° | 12 ~ 300° |
| **带温度补偿的标定** | 0.01 ~ 0.1 °/s | 0.6 ~ 6° | 6 ~ 60° |
| **磁力计融合** | 不漂（有界误差） | 取决于磁干扰 | 取决于磁干扰 |

> [!warning] 这三个数字要记住
> **未标定的模块，转 10 分钟能自己"转"好几圈。**
> 这就是为什么零偏标定是"必做"而不是"可选"。

---

# 二、根因一：加速度计对 yaw 完全无感

这是整个问题的**核心**。理解了这一条，后面所有方法都顺理成章。

## 2.1 三个角度的"参考物"

姿态解算的本质是回答："物体相对**地面坐标系**转了多少？"

| 角度 | 转轴 | 需要的参考物 | 哪个传感器能提供 |
|---|---|---|---|
| **Pitch** | 绕 Y 轴（横轴） | 重力方向 | ✅ 加速度计 |
| **Roll** | 绕 X 轴（纵轴） | 重力方向 | ✅ 加速度计 |
| **Yaw** | 绕 Z 轴（**重力轴**） | **水平面内的某个固定方向**（比如地磁北） | ❌ 加速度计**不行** |

**关键差异**：pitch/roll 绕着"与重力垂直的轴"转，yaw 绕着"与重力平行的轴"转。

## 2.2 加速度计为什么能校正 pitch/roll

加速度计静止时测到的是**比力**（支撑力的反作用力），方向**垂直于水平面朝上**，大小约 1g。

用重力矢量在传感器三个轴上的**投影**，就能反推物体的倾斜：

```text
        传感器坐标系（跟着模块转）
             Z ↑
               │
               │
               └────→ X
              ╱
             Y

  模块平放：g 全在 Z 轴上      → gx=0, gy=0, gz=1g   → 倾角 = 0
  模块前倾：g 有了 X 分量      → gx=0.5g, gz=0.87g   → pitch = atan(0.5/0.87) ≈ 30°
  模块右倾：g 有了 Y 分量      → gy=0.5g, gz=0.87g   → roll  = atan(0.5/0.87) ≈ 30°
```

**重力方向是绝对的、不随时间变化的**，所以每次测量都能给 pitch/roll 一个"绝对参照"，误差不会累积。

## 2.3 加速度计为什么对 yaw 完全无感 —— 数学证明

这一小节是本文的核心，请务必看懂。

### 设定

设**地面坐标系**（n 系）中重力矢量为：

```text
g_n = [0, 0, g]ᵀ      （按 Z 轴向上为正的约定，静止时比力朝上）
```

设**传感器坐标系**（b 系）相对地面坐标系的旋转矩阵为 `R`，则重力在传感器坐标系中的表示为：

```text
g_b = Rᵀ · g_n
```

### 关键一步：绕 Z 轴旋转不改变 Z 分量

绕 Z 轴（重力轴）旋转 ψ 角（即 yaw）的旋转矩阵是：

```text
        ⎡ cosψ  -sinψ   0 ⎤
Rz(ψ) = ⎢ sinψ   cosψ   0 ⎥
        ⎣   0      0     1 ⎦
```

把这个矩阵作用到重力矢量上：

```text
        ⎡ cosψ  -sinψ   0 ⎤   ⎡ 0 ⎤   ⎡ 0 ⎤
Rz(ψ) · ⎢ sinψ   cosψ   0 ⎥ · ⎢ 0 ⎥ = ⎢ 0 ⎥
        ⎣   0      0     1 ⎦   ⎣ g ⎦   ⎣ g ⎦
```

**结果是 [0, 0, g]ᵀ —— 和旋转前一模一样！**

> [!important] 这就是全部答案
> **绕 Z 轴（重力轴）旋转任意角度，重力矢量在传感器坐标系中的表示完全不变。**
>
> 换句话说：**"模块朝向东南西北哪个方向"这件事，加速度计一点都测不出来。**

### 直观理解

想象你手里拿一杯水，让它自转（像转盘一样绕竖直轴转）：

- 水面**始终是水平的**，晃都不晃一下
- 水**完全感知不到**你在转它

加速度计就是那杯水。它只能感知"倾斜"，感知不到"自转"。

### 严格一点的说明

如果姿态矩阵按 yaw→pitch→roll 的顺序分解：

```text
R = Rz(ψ) · Ry(θ) · Rx(φ)
```

则：

```text
g_b = Rᵀ · g_n = Rx(φ)ᵀ · Ry(θ)ᵀ · Rz(ψ)ᵀ · g_n
                            ↑
                     这一项作用在 g_n 上等于 g_n 本身
```

所以：

```text
g_b = Rx(φ)ᵀ · Ry(θ)ᵀ · g_n     ← 式子里根本没有 ψ！
```

**g_b 的表达式里不含 ψ，所以无论怎么测量 g_b，都解不出 ψ。** 这就是"加速度计对 yaw 无感"的严格表述。

## 2.4 推论：没有参考，就没有修正

姿态解算里，"用 A 传感器修正 B 积分"的前提是：**A 能测到 B 所描述的那个量**。

| 角度 | 陀螺仪能测吗 | 加速度计能测吗 | 能否融合修正 |
|---|---|---|---|
| Pitch | ✅ gy | ✅ 重力投影 | ✅ 可以 |
| Roll | ✅ gx | ✅ 重力投影 | ✅ 可以 |
| **Yaw** | ✅ gz | ❌ **测不到** | ❌ **不能** |

**所以 yaw 只能靠陀螺仪纯积分：**

```c
Yaw += gz * dt;          // 没有任何东西能"拉回"它
```

> [!important] 这就是 yaw 零飘的根源
> 不是代码写得不好，不是滤波器参数没调对 ——
> **是物理上就没有可用的参考量。**
>
> 任何声称"用软件算法消除 MPU6050 的 yaw 漂移"的说法，都是错的。
> 软件只能**抑制**（减少零偏），或者**引入新的参考**（磁力计）。

---

# 三、根因二：陀螺仪的六种误差

既然 yaw 只能靠陀螺仪积分，那么陀螺仪的所有误差都会直接变成 yaw 的漂移。

## 3.1 误差清单

| # | 误差类型 | 物理原因 | 表现 | 能否标定消除 |
|:--:|---|---|---|:--:|
| ① | **常值零偏** (Bias Offset) | 制造工艺、MEMS 结构不对称 | 静止输出非 0 的固定值 | ✅ **可以**（静止标定） |
| ② | **零偏温漂** (Bias Drift over Temp) | 硅材料的温度特性 | 温度变了零偏跟着变 | ⚠️ 可以补偿（查表/拟合） |
| ③ | **零偏重复性** (Bias Repeatability) | 每次上电的应力状态不同 | 每次开机零偏都不一样 | ✅ 每次上电重新标定 |
| ④ | **角度随机游走** (ARW) | 白噪声积分 | 漂移量随时间 √t 增长 | ❌ 无法标定 |
| ⑤ | **标度因数误差** (Scale Factor Error) | 灵敏度不准 | 转 90° 显示 87° | ⚠️ 可以标定（转台） |
| ⑥ | **非正交/轴间耦合** | 三轴不正交 | 绕 X 转，Y/Z 也有输出 | ⚠️ 需要复杂标定 |

## 3.2 哪些误差对 yaw 影响最大

**按影响程度排序**：

```text
① 常值零偏   >>  ② 温漂  >  ④ 随机游走  >  ⑤ 标度因数  >  ⑥ 非正交
   ↑                                                              ↑
 最大，但最容易解决                                       最小，最难解决
```

| 误差 | 典型量级 | 对 yaw 的影响（10 分钟） |
|---|---|---|
| 常值零偏（未标定） | 0.5 ~ 5 °/s | **300 ~ 3000°** |
| 常值零偏（标定后残余） | 0.02 ~ 0.5 °/s | 12 ~ 300° |
| 温漂（10°C 变化） | 0.1 ~ 2 °/s | 60 ~ 1200° |
| 随机游走 | 约 0.05 °/√s | 约 12°（与时间成 √t） |

## 3.3 为什么"常值零偏"这么重要

因为它**在积分里变成了线性增长**：

```text
θ_error(t) = b × t
```

| 零偏 b | 1 分钟 | 10 分钟 | 1 小时 |
|:--:|:--:|:--:|:--:|
| 0.01 °/s | 0.6° | 6° | 36° |
| 0.1 °/s | 6° | 60° | **360°（转一整圈）** |
| 1 °/s | 60° | 600° | 3600°（10 圈） |

**看第三行：只要零偏是 0.1°/s，一小时后 yaw 就"自己转了一整圈"。**

## 3.4 零偏从哪来

### ① 制造误差（出厂就有）

MEMS 陀螺仪是微米级机械结构，刻蚀、封装过程中不可避免有不对称。MPU6050 数据手册给出的零偏指标相当宽松：

> **Gyroscope Zero-Rate Output (ZRO)：±20 °/s**（未标定的最坏情况）

±20°/s 意味着：**理论上最坏情况下一分钟能飘 1200°**。当然实测通常没这么夸张，但这也说明**不标定根本没法用**。

### ② 温度（工作中的主要变化源）

零偏随温度变化，数据手册给出的全温区（−40 ~ +85°C）变化量也在 ±20°/s 量级。折算到**实际会遇到的 10°C 变化**，大约是 **1~3 °/s** 量级 —— 仍然远大于标定后的残余零偏。

**更麻烦的是**：
- MPU6050 自身会发热（工作电流几 mA），开机后温度会缓慢上升
- 所以**刚开机标定得到的零偏，过几分钟就不准了**
- 这就是为什么"标定一次管一辈子"是不成立的

### ③ 应力（每次上电不同）

封装应力、PCB 焊接应力会随温度循环变化，导致每次上电的零偏都有差异（称为"零偏重复性"）。

**所以正确做法是：每次上电都重新标定。**

---

# 四、误差如何累积：积分就是误差累加器

## 4.1 积分的基本性质

陀螺仪测的是**角速度** ω(t)，要通过积分得到**角度**：

```text
θ(t) = θ(0) + ∫₀ᵗ ω(τ) dτ
```

如果测量有误差 ε(t)：

```text
θ_measured(t) = θ_true(t) + ∫₀ᵗ ε(τ) dτ
                               ↑
                        误差的积分 = 误差累加器
```

## 4.2 不同误差的时间特性

| 误差类型 | ε(t) 的性质 | ∫ε dt 的增长 | 举例 |
|---|---|---|---|
| **常值零偏** | ε = b（常数） | **线性** `b·t` | 0.1°/s → 1 小时 360° |
| **随机游走** | 白噪声 | **与 √t 成正比** | 增长较慢，长期会被线性项淹没 |
| **周期性误差** | 正弦 | **有界**（积分互相抵消） | 振动引起的误差不会累积 |

**关键结论**：

```text
短期（秒级）  → 随机游走为主，抖动明显
中期（分钟级）→ 常值零偏主导，线性漂移
长期（小时级）→ 常值零偏 + 温漂完全主导
```

> [!important] 所以"消除常值零偏"的性价比最高
> 它增长最快（线性），也最容易消（静止求平均）。
> **一行代码，效果立竿见影。**

---

# 五、量化：单位换算与典型数值

## 5.1 三种常用单位

工程上描述陀螺仪精度有三种单位，很容易混：

| 单位 | 含义 | 用于描述 |
|---|---|---|
| **°/s** | 度每秒 | 零偏大小、漂移速率 |
| **°/h** | 度每小时 | 惯导行业习惯（1 °/h = 1/3600 °/s） |
| **°/√h** | 度每根号小时 | 角度随机游走（ARW） |

### 换算关系

```text
1 °/s   = 3600 °/h
1 °/h   = 1/3600 °/s ≈ 0.000278 °/s
0.1 °/s = 360 °/h
```

### ARW 的换算（° / √s ↔ ° / √h）

```text
1 °/√h = 1 ° / √3600 s = 1/60 °/√s ≈ 0.0167 °/√s
1 °/√s = 60 °/√h
```

**为什么要用 °/√h**：因为随机游走导致的误差和 √t 成正比，用"每小时"定义能让数字不随时间变化。

## 5.2 一个实用的速算表

| 漂移率 | 1 分钟 | 1 小时 | 好不好 |
|:--:|:--:|:--:|---|
| 10 °/s | 600° | 36000° | ❌ 完全不可用 |
| 1 °/s | 60° | 3600° | ❌ 不可用 |
| 0.1 °/s | 6° | **360°** | ⚠️ 短时间勉强能用 |
| 0.01 °/s | 0.6° | 36° | ✅ 手势/短时控制够用 |
| 0.001 °/s | 0.06° | 3.6° | ✅ 接近消费级惯导 |

> [!tip] 记住这个换算
> **`°/s` 乘以 3600 = `°/h`**
> **`°/s` 乘以 60 = 1 分钟漂的角度**
>
> 看到"0.1°/s"就立刻反应："一分钟飘 6 度，一小时飘 360 度。"

## 5.3 怎么实测自己模块的漂移率

这是**必须动手做**的一步 —— 别人的数据对你的模块没意义。

### 实验步骤

```text
1. 把 MPU6050 平放在稳固的桌面上（别放在会震动的桌子、别放在音响旁边）
2. 上电，等零偏标定完成（约 1 秒，期间保持静止）
3. 不要碰它，让它跑 10 分钟
4. 记录 Yaw 从 0 漂到了多少
5. 漂移率 = ΔYaw / 600s
```

### 判断标准

| 实测漂移率 | 评价 | 下一步 |
|---|---|---|
| > 5 °/s | 异常大 | 检查标定是否真的静止、模块是否在振动 |
| 1 ~ 5 °/s | 偏大 | 检查电源纹波、附近是否有振动源 |
| 0.1 ~ 1 °/s | 正常（标定后） | 可考虑温度补偿 |
| 0.01 ~ 0.1 °/s | 很好 | 已接近 MPU6050 的实用极限 |
| < 0.01 °/s | 极好 | 检查是不是数据没更新（可能程序卡住了） |

### 用本工程的程序自动测

[[阶段五 任务3 角度稳定性与Yaw漂移]] 的程序每秒输出一行，**`Drift` 列就是漂移率**（按 5 秒窗口计算）。

把串口输出保存成 CSV，用 Excel 画 `Yaw` 对时间的曲线：
- **直线** → 常值零偏主导（标定没做好或有残余）
- **弯曲/台阶** → 温漂主导（看看是不是和温度列相关）

> [!tip] 一个漂亮的诊断方法
> 把 `Yaw` 和 `Temp` 两列画在同一张图上。
> 如果两条曲线**形状相关**（温度升，yaw 变化率变大/变形），
> 那就是**温漂**，而不是常值零偏 —— 这说明该做温度补偿了。

---

# 六、方法一：零偏标定（必做）

> [!important] 性价比最高的一步
> **不做这一步，其他所有方法都是在错误的基础上做优化。**

## 6.1 原理

陀螺仪静止时，理想输出应该是 **0 °/s**。实际输出是一个小的固定值：

```text
静止时的读数 = 0（真实角速度） + b（零偏） + n（噪声）
```

把静止时的读数**求平均**，噪声 n 被平均掉（N 次平均能降 √N 倍），剩下就是 b：

```text
b ≈ (Σ 读数) / N
```

之后每次读数都减去 b，常值零偏就被消掉了。

## 6.2 代码实现

```c
/* 陀螺仪零偏（°/s） */
static float GyroBiasX = 0, GyroBiasY = 0, GyroBiasZ = 0;

/**
  * 函    数：陀螺仪零偏标定
  * 说    明：**调用期间模块必须完全静止！**
  */
static void GyroCalibrate(void)
{
    float ax, ay, az, gx, gy, gz;
    float sx = 0, sy = 0, sz = 0;
    uint16_t i;

    for (i = 0; i < ATT_CALIB_N; i++)          /* ATT_CALIB_N = 500 */
    {
        MPU6050_GetData(&ax, &ay, &az, &gx, &gy, &gz);
        sx += gx; sy += gy; sz += gz;
        /* 采样间隔约 2ms，总共约 1 秒 */
        { volatile uint32_t d; for (d = 0; d < 3000; d++); }
    }

    GyroBiasX = sx / ATT_CALIB_N;
    GyroBiasY = sy / ATT_CALIB_N;
    GyroBiasZ = sz / ATT_CALIB_N;      /* ← Z 轴零偏是 yaw 漂移的主因 */
}
```

**每次使用前扣掉：**

```c
gx -= GyroBiasX;
gy -= GyroBiasY;
gz -= GyroBiasZ;      /* yaw 用这一路 */
```

## 6.3 参数怎么选

| 参数 | 建议值 | 说明 |
|---|---|---|
| 采样次数 N | 300 ~ 1000 | 越多越准，但耗时越长 |
| 采样间隔 | 2 ~ 5 ms | 不能太快（要跨越若干噪声周期） |
| 总耗时 | 1 ~ 3 秒 | 用户能接受的等待时间 |
| **静止要求** | **必须** | 有振动会让标定结果直接错掉 |

## 6.4 效果

| | 未标定 | 标定后 |
|---|---|---|
| 常值零偏 | 0.5 ~ 5 °/s | ~0（只剩残余） |
| 1 分钟漂移 | 30 ~ 300° | 1 ~ 30° |
| 10 分钟漂移 | 300 ~ 3000° | 12 ~ 300° |

**提升约 10~50 倍，而代码只有二十行。**

## 6.5 局限（必须知道的）

> [!warning] 零偏标定只能解决"标定那一刻"的常值零偏
> 它解决不了：
> 1. **温漂** —— 温度一变，零偏就变了
> 2. **零偏重复性** —— 每次上电零偏略有不同（所以每次都要标定）
> 3. **随机游走** —— 白噪声积分，无法通过标定消除
> 4. **标度因数误差** —— 转 90° 显示 87° 这类问题
>
> **残余漂移通常在 0.02 ~ 0.5 °/s** —— 比未标定好很多，但 10 分钟仍会漂 12~300°。

## 6.6 工程上的几种做法

| 做法 | 触发时机 | 优缺点 |
|---|---|---|
| **上电标定**（本工程） | 初始化时 | ✅ 简单可靠；⚠️ 用户要等 1 秒 |
| 按键标定 | 用户按按键时 | ✅ 可按需重新标定；⚠️ 需要按键和提示 |
| 自动静止检测标定 | 检测到静止时自动做 | ✅ 免人工；⚠️ 判据设计不好会误标 |
| 开机持续后台标定 | 前 N 秒持续更新零偏 | ✅ 无感；⚠️ 期间不能动 |

**本工程用"上电标定"，因为最简单，而且提示明确（串口/OLED 会提示"保持静止"）。**

---

# 七、方法二：温度补偿

## 7.1 为什么需要

零偏标定把"标定那一刻"的零偏消掉了。但**MPU6050 自己会发热**：

```text
上电瞬间：芯片温度 = 室温（比如 25°C）
工作 1 分钟：29°C
工作 5 分钟：33°C
工作 10 分钟：35°C（趋于稳定）
```

芯片温度变了几度，零偏就跟着变几度/秒 —— 于是**刚标定完很准，用着用着又开始飘**。

## 7.2 原理

零偏随温度的关系近似是**线性的**（在窄温区内）：

```text
b(T) = b₀ + k × (T − T₀)
        ↑     ↑
     参考零偏  温漂系数
```

如果能测出 `k`，并且知道当前温度 `T`，就能实时修正。

## 7.3 怎么测温漂系数

### 方法一：两点法（最简单）

```text
1. 在室温 T₁ 下静止标定 → 得到 b₁
2. 用吹风机/热水袋把模块加热到 T₂（别太热，40~50°C 即可）
3. 稳定后再次静止标定 → 得到 b₂
4. k = (b₂ − b₁) / (T₂ − T₁)
```

### 方法二：连续记录法（更准）

```text
1. 上电后立刻开始记录（温度 × 零偏），每 10 秒一组
2. 用吹风机缓慢加热，同时保持静止
3. 记录 5~10 分钟，得到一组 (T, b) 数据
4. 用 Excel 做线性拟合，斜率就是 k
5. 同时画出散点图 —— 如果不是直线，说明需要分段或二次拟合
```

> [!tip] 注意"升温"和"降温"曲线可能不重合
> 这叫**迟滞（hysteresis）**。如果差异明显，说明纯线性模型不够，
> 需要分别拟合升温/降温，或者用查表法。

## 7.4 代码实现（线性模型）

```c
/* 温漂补偿参数：按你自己的实测填入 */
#define TEMP_REF        25.0f       /* 参考温度(℃) */
#define BIAS_TEMP_K     0.05f       /* 温漂系数 ((°/s)/℃)，实测得到 */

static float RefBiasZ = 0;          /* 参考温度下的 Z 轴零偏 */
static float RefTemp  = TEMP_REF;

/**
  * 函    数：带温度补偿的 Z 轴零偏
  * 参    数：Temp 当前芯片温度(℃)
  * 返 回 值：补偿后的 Z 轴零偏(°/s)
  */
float GetBiasZ_Compensated(float Temp)
{
    return RefBiasZ + BIAS_TEMP_K * (Temp - RefTemp);
}
```

**使用：**

```c
ChipTemp = MPU6050_GetTemp();
gz -= GetBiasZ_Compensated(ChipTemp);
```

## 7.5 查表法（非线性时用）

```c
/* 温度分段点与对应零偏（实测填入） */
const float TempTable[5]  = {20, 25, 30, 35, 40};
const float BiasZTable[5] = {0.12f, 0.05f, -0.02f, -0.08f, -0.15f};

float GetBiasZ_Lookup(float Temp)
{
    uint8_t i;
    if (Temp <= TempTable[0]) return BiasZTable[0];
    if (Temp >= TempTable[4]) return BiasZTable[4];

    for (i = 0; i < 4; i++)
    {
        if (Temp < TempTable[i+1])
        {
            /* 线性插值 */
            float ratio = (Temp - TempTable[i]) / (TempTable[i+1] - TempTable[i]);
            return BiasZTable[i] + ratio * (BiasZTable[i+1] - BiasZTable[i]);
        }
    }
    return BiasZTable[4];
}
```

## 7.6 更好的做法：把温漂写进滤波器

互补滤波/卡尔曼里本来就在估计零偏，可以让它同时承担温漂补偿。但简单做法是：

```c
/* 在扣零偏时一并扣掉温漂 */
gz -= (GyroBiasZ + BIAS_TEMP_K * (ChipTemp - RefTemp));
```

> [!note] 实用建议
> 如果只是做手势控制（每次用几分钟），**温度补偿的收益有限** —— 因为时间短，温漂还没积累多少。
> 温漂补偿主要在**长时间运行**（比如 30 分钟以上）时才有明显价值。

## 7.7 一个免费的加分项：让模块先热身

```text
上电 → 等 30~60 秒（让温度稳定）→ 再标定零偏
```

这样标定时的温度和后续工作温度接近，温漂的影响自然小了。

**代价**：用户要等。是否值得取决于应用场景。

---

# 八、方法三：静止检测 + 零速修正（ZUPT）

ZUPT = Zero Velocity Update（零速修正），惯导里的经典技术。

## 8.1 核心思想

**如果检测到模块处于静止，那么它的真实角速度就是 0。**

那就可以做出一个非常强的判断：

```text
静止时：gz 的读数应该是 0
       如果读到 0.08 °/s，那么这个 0.08 就是当前零偏！
       → 用它来更新零偏估计 → 顺便把 yaw 的变化冻结
```

**每检测到一次静止，就等于免费做了一次零偏标定。**

## 8.2 怎么判断"静止"

单独看一路陀螺仪不可靠（零偏本身就让读数偏离 0）。要综合判断：

| 判据 | 方法 | 说明 |
|---|---|---|
| **陀螺仪模长小** | `√(gx²+gy²+gz²) < 阈值` | 转得慢 |
| **加速度计模长 ≈ 1g** | `| ‖a‖ − 1 | < 阈值` | 没有线性加速度 |
| **加速度计方差小** | 连续 N 次读数波动小 | 更可靠（要缓存历史） |
| **角度变化小** | pitch/roll 在 N 次内几乎不变 | 综合判据 |

**最实用的组合**：陀螺仪模长 + 加速度计模长偏差，再加一个"持续 N 个周期都满足"的条件。

## 8.3 代码实现

```c
#define STILL_GYRO_TH      0.8f     /* 陀螺仪模长阈值(°/s) */
#define STILL_ACC_TH       0.08f    /* 加速度模长偏差阈值(g) */
#define STILL_COUNT_TH     20       /* 连续满足多少个周期才算静止（20×10ms=0.2s） */

static uint16_t StillCount = 0;
static uint8_t  IsStill    = 0;

/**
  * 函    数：静止检测
  * 参    数：ax,ay,az 加速度(g)；gx,gy,gz 已经扣过零偏的角速度(°/s)
  * 返 回 值：1=静止
  */
uint8_t CheckStill(float ax, float ay, float az,
                   float gx, float gy, float gz)
{
    float gNorm, aNorm;

    /* 判据1：陀螺仪三轴模长小 */
    gNorm = sqrtf(gx*gx + gy*gy + gz*gz);

    /* 判据2：加速度计模长接近 1g（没有线性加速度） */
    aNorm = sqrtf(ax*ax + ay*ay + az*az) - 1.0f;
    if (aNorm < 0) aNorm = -aNorm;

    if (gNorm < STILL_GYRO_TH && aNorm < STILL_ACC_TH)
    {
        if (StillCount < STILL_COUNT_TH) StillCount++;
    }
    else
    {
        StillCount = 0;
    }

    IsStill = (StillCount >= STILL_COUNT_TH);
    return IsStill;
}
```

**在姿态更新里使用：**

```c
if (IsStill)
{
    /* 静止 → 当前 gz 读数就是零偏，用一阶低通慢慢更新零偏估计 */
    GyroBiasZ = GyroBiasZ * 0.99f + gz * 0.01f;

    /* 并且把 yaw 的更新冻结（此时真实角速度为 0，不该有变化） */
    /* yaw += 0; */          /* 不动 */
}
else
{
    Yaw += gz * dt;          /* 运动时才积分 */
}
```

## 8.4 效果与局限

| | 说明 |
|---|---|
| **效果** | 间歇静止的场景下效果极好 —— 每次静止都把零偏"刷新"一遍 |
| **局限** | **只能用于有静止间歇的场景** |
| **不适合** | 连续运动的场景（比如一直拿着挥动的手势控制） |

> [!warning] 对本项目的适用性
> 手势控制时，用户的手**大部分时间是静止的**（等指令的时候）。
> 所以 ZUPT **在手势控制里其实挺有用** —— 但要注意：
> 手"静止"不等于模块完全静止（手会抖），阈值要调好，否则会把微小的手抖当成"零偏"学进去，
> 反而让零偏估计变差。

## 8.5 变体：自适应零偏估计

比 ZUPT 更温和的做法：**不要求完全静止，而是在"运动量小"时以较小的增益更新零偏**。

```c
/* 运动越剧烈，越不信"当前读数就是零偏" */
float MotionLevel = fabsf(gx) + fabsf(gy) + fabsf(gz);
float Gain = (MotionLevel < 1.0f) ? 0.002f : 0.0f;   /* 越安静，学得越快 */
GyroBiasZ = GyroBiasZ * (1 - Gain) + gz * Gain;
```

**这是卡尔曼滤波估计零偏的思想的简化版。**

---

# 九、方法四：磁力计融合（根本解法）

> [!important] 这是唯一能从根本上"消除"漂移的方法
> 因为它是**唯一一个能给 yaw 提供绝对参考**的传感器。

## 9.1 原理：地磁是天然的方向标

地球磁场在**水平面内有稳定的指向**（指向磁北）。这个方向和重力一样，是**绝对的、不随时间漂移的**。

```text
重力矢量  →  给出"哪边是下"     →  校正 pitch / roll
地磁矢量  →  给出"哪边是北"     →  校正 yaw       ← 这就是我们缺的东西
```

**把磁力计加进来，yaw 就有了和 pitch/roll 一样的"修正源"。**

## 9.2 硬件选择

MPU6050 **本身没有磁力计**，必须外接或换芯片：

| 方案 | 说明 | 价格 / 难度 |
|---|---|---|
| **MPU6050 + 外接磁力计** | 加一颗 HMC5883L 或 QMC5883L | 便宜，但两颗芯片的坐标系要对齐 |
| **MPU9250** | 9 轴（3 加速度 + 3 陀螺 + 3 磁力） | 稍贵，接口现成，**推荐** |
| **ICM20948** | 9 轴升级版 | 更贵，性能更好 |
| **BNO055** | 内置姿态融合，直接输出四元数 | 最省事，但学不到东西（融合是黑盒） |

| 磁力计型号 | 接口 | 备注 |
|---|---|---|
| HMC5883L | I2C | 经典款，很多模块已停产/涨价 |
| **QMC5883L** | I2C | HMC5883L 的常见替代（**两者寄存器不兼容！**） |
| LIS3MDL | I2C/SPI | ST 原厂，性能好 |

> [!warning] HMC5883L 和 QMC5883L 寄存器不兼容
> 外形和引脚一样，很多卖家混着卖，代码不能通用。
> 买之前确认型号，或者买"兼容两种"的驱动库。

## 9.3 第一步：椭球校准（必须做，否则数据没法用）

**未经校准的磁力计数据基本是废的。** 原因有两类干扰：

### 硬磁干扰（Hard Iron）

模块上的**永久磁性物质**（喇叭、螺丝、焊锡中的铁磁材料）会产生一个**固定磁场**，叠加在地磁上。

**表现**：把模块朝各个方向转一圈，磁力计读数画出的轨迹是一个**偏离原点的球**。

```text
        理想                    实际（硬磁干扰）
      ╭─────╮                  ╭─────╮
     ╱   ·   ╲               ╱   ·   ╲
    │    O    │             │    ●────│──→ 球心偏移了
     ╲       ╱               ╲       ╱
      ╰─────╯                  ╰─────╯
     球心在原点                球心偏离原点到 ●
```

**解法**：测出球心 `(x₀, y₀, z₀)`，读数减去它：

```c
mx -= x0;  my -= y0;  mz -= z0;
```

球心怎么求：把模块**绕各个方向慢慢转一圈**（尽量覆盖所有姿态），

```text
x₀ = (max(mx) + min(mx)) / 2
y₀ = (max(my) + min(my)) / 2
z₀ = (max(mz) + min(mz)) / 2
```

### 软磁干扰（Soft Iron）

附近的**铁磁材料**会"扭曲"磁场分布，让球变成**椭球**。

**解法**：求一个 3×3 的变换矩阵，把椭球"拉回"成球。

**工程简化做法**：只做各轴的独立缩放（假设椭球主轴与传感器轴对齐）：

```c
/* 各轴的半轴长度 */
float rx = (max(mx) - min(mx)) / 2;
float ry = (max(my) - min(my)) / 2;
float rz = (max(mz) - min(mz)) / 2;

/* 以平均半径为目标，做独立缩放 */
float rAvg = (rx + ry + rz) / 3.0f;

mx = (mx - x0) * rAvg / rx;
my = (my - y0) * rAvg / ry;
mz = (mz - z0) * rAvg / rz;
```

**完整的椭球拟合**需要解最小二乘问题（用 MATLAB/Python 离线算好矩阵写进代码），
对初学者来说上面的"最简版"已经能明显改善。

## 9.4 第二步：倾斜补偿（重要且容易漏）

**只有模块水平时，`atan2(my, mx)` 才是航向角。**

模块一旦倾斜，磁力计的 X/Y 分量就混进了重力的影响，算出来的航向就错了。

**解法**：用已算好的 pitch/roll，把磁场矢量**投影到水平面**：

```c
/* 把磁力计读数旋转到水平面 */
Xh = mx * cosf(Pitch) + my * sinf(Roll) * sinf(Pitch) + mz * cosf(Roll) * sinf(Pitch);
Yh = my * cosf(Roll) - mz * sinf(Roll);

/* 水平面内的航向角 */
Heading = atan2f(-Yh, Xh) * RAD2DEG;
```

（具体符号取决于你的坐标系定义和磁力计安装方向，需要实测调整。）

> [!warning] 这里有个"鸡生蛋"问题
> 倾斜补偿需要 pitch/roll，而 pitch/roll 来自加速度计+陀螺仪 —— 这部分已经有了，所以没问题。
> 但要注意：**如果 pitch/roll 本身有误差，会传导到航向角上**。

## 9.5 第三步：融合

有了绝对航向 `Heading`，就可以像 pitch/roll 一样做融合了。

### 互补滤波版

```c
/* 注意：角度要处理 -180~+180 的回绕！ */
float YawErr = Heading - Yaw;
while (YawErr >  180.0f) YawErr -= 360.0f;
while (YawErr < -180.0f) YawErr += 360.0f;

Yaw = Yaw + gz * dt + 0.02f * YawErr;      /* 陀螺仪为主，磁力计慢修正 */
```

> [!important] 角度回绕是最容易出的 bug
> `359°` 和 `1°` 只差 2°，但直接相减得到 `358°`。
> **任何涉及航向角的减法，都必须先处理回绕。**

### 卡尔曼滤波版

把状态扩成"角度 + 零偏 + 磁干扰"，用磁力计作为观测量。实现复杂得多，
一般用现成库（如 Madgwick、Mahony 算法）—— 这两个是开源的姿态融合算法，
支持 6 轴/9 轴，代码量不大，效果比手写互补滤波好。

## 9.6 磁力计最大的问题：干扰

> [!danger] 在机器人上，磁力计经常不可用
> 磁力计的干扰源：
> - **电机**（永磁体 + 大电流）—— 影响最大
> - **电源线 / 大电流回路**
> - **铁质/磁性车架**、螺丝
> - **附近的手机、音响、金属桌椅**
>
> **RoboMaster 的车上，磁力计基本是废的。** 因此：
> - 比赛机器人通常**不用磁力计**，靠其他方式确定航向
> - 或把磁力计**装在高处（远离电机）**，并做严格的动态校准

### 判断磁力计是否可信

```c
/* 地磁总强度应该接近一个常数（约 0.25~0.65 高斯，因纬度而异） */
float magNorm = sqrtf(mx*mx + my*my + mz*mz);
if (fabsf(magNorm - MAG_NOMINAL) > MAG_TOLERANCE)
{
    /* 磁场异常 → 磁力计数据不可信 → 这一次不做修正 */
}
```

**这个"磁力计可信度检查"是必须的** —— 否则干扰会被当成真实航向，反而把 yaw 拉错。

## 9.7 磁偏角（Declination）

磁力计指向的是**磁北**，而地图上的是**真北**，两者有夹角（磁偏角），大小随地理位置变化：

| 地区 | 磁偏角 |
|---|---|
| 北京 | 约 −7° |
| 上海 | 约 −5° |
| 广州 | 约 −2° |
| 乌鲁木齐 | 约 +3° |

**对你的应用**：如果只是"手势控制小车转向"，磁偏角**不用管** —— 它只是个固定偏移。
如果要和地图/真北对齐，才需要补偿。

---

# 十、方法五：外部绝对参考

除了磁力计，还有这些能给 yaw 提供绝对参考的手段：

| 方法 | 原理 | 精度 | 成本 | 适用 |
|---|---|---|---|---|
| **视觉标记** | 摄像头识别已知位置的标记，反推朝向 | 高（0.1°） | 高 | 有固定场地、算力充足 |
| **UWB 定位** | 多个基站测距，三角定位出朝向 | 中（1~5°） | 高 | 室内、多机器人编队 |
| **机械限位/零点开关** | 每次转到某个位置就校准零点 | 极高 | 极低 | **只在特定位置能校** |
| **已知方向的起始姿态** | 开机时朝向已知，之后靠陀螺仪 | 中 | 零 | 短时间任务 |
| **GPS 双天线** | 两个天线的相位差给出航向 | 高 | 很高 | 室外、车辆 |

> [!tip] 最实用的一个：机械限位
> 如果系统里能设计一个"每次回到这个位置就知道朝向"的机械结构
> （比如云台的回中点、小车的起始挡块），
> **每次碰到它就重置 yaw** —— 零成本，但效果极好。
>
> 这是"用机械设计解决软件难题"的典型例子。

---

# 十一、五种方法对比

| 方法 | 能否消除漂移 | 精度提升 | 实现难度 | 额外硬件 | 本工程适用性 |
|---|---|:--:|:--:|---|---|
| **零偏标定** | ❌ 只减小 | **10~50×** | ⭐ 极低 | 无 | ✅✅ **必做** |
| 温度补偿 | ❌ 只减小 | 1.5~5× | ⭐⭐ 低 | 无（芯片自带温度） | ✅ 可选 |
| 静止检测 ZUPT | ❌ 只减小 | 2~10× | ⭐⭐⭐ 中 | 无 | ✅ 适合手势场景 |
| **磁力计融合** | ✅ **能（有界）** | 根本性改善 | ⭐⭐⭐⭐ 高 | **需要磁力计** | ⚠️ 小车上有电机干扰 |
| 外部绝对参考 | ✅ 能 | 最好 | ⭐⭐⭐⭐⭐ 极高 | 相机/UWB 等 | ❌ 不适合 |

### 效果叠加顺序（推荐）

```text
必做：  零偏标定
  ↓
可选：  温度补偿（长时间运行时）
  ↓
可选：  静止检测（有静止间歇的场景）
  ↓
需要绝对航向时：  磁力计融合
```

> [!important] 最重要的一句话
> **前三个方法都是"抑制"，只有磁力计/外部参考是"消除"。**
> 如果你的应用真的需要长期准确的 yaw，就必须加磁力计或外部参考 ——
> 这不是算法能绕过去的物理问题。

---

# 十二、本项目的结论：绕开它

## 12.1 手势控制只用 pitch 和 roll

回到题目的要求：

| 手势 | 用到的角度 |
|---|---|
| 手前倾 → 前进 | **Pitch** |
| 手后倾 → 后退 | **Pitch** |
| 手左倾 → 左转 | **Roll** |
| 手右倾 → 右转 | **Roll** |
| 手平放 → 停止 | Pitch/Roll 都在死区内 |

**yaw 一次都没用到。**

## 12.2 正确的决策

> [!important] 对一个用不到的量，最好的处理方式是"不管它"
> 可以这么回答面试官/评审：
>
> "yaw 零飘我们分析过：**根因是加速度计对绕重力轴的旋转无感，所以没有参考量可以做融合**，只能靠陀螺仪积分，必然漂移。
> 解决办法有零偏标定、温度补偿、ZUPT、磁力计融合四类，前三个只是抑制，只有磁力计能根治。
> **但本题的手势映射只用 pitch 和 roll，这两个角有重力做绝对参考、不会漂，所以 yaw 的漂移不影响功能，我们选择不做磁力计。**
> 如果后续需要航向信息，方案是加一颗 QMC5883L 做椭球校准 +
> 倾斜补偿 + 互补滤波融合，但小车上电机磁干扰大，可能需要把磁力计装在远离电机的位置。"
>
> **这段话展示的是**：懂原理 → 知道方案 → 能判断收益 → 做出取舍。
> 比"我加了个磁力计"更有说服力。

## 12.3 什么情况下必须解决 yaw

| 场景 | 是否需要 yaw |
|---|---|
| 手势控制（本题） | ❌ 不需要 |
| 小车直线行驶（防跑偏） | ✅ 需要（但可用编码器差速 + 陀螺仪短期参考） |
| 云台绝对指向 | ✅ 需要（通常用磁力计或编码器） |
| 自主导航、路径规划 | ✅ 必须（惯导 + 磁力计 + 视觉） |
| 姿态演示（看飞机模型） | ✅ 需要（但可以接受缓慢漂移） |

**注意"小车防跑偏"这个场景**：其实不需要绝对航向，只需要**短期准确**就行 —— 因为控制器会不断修正。

```text
目标：直行
方法：陀螺仪测出"车头偏了多少"（相对起始方向）→ 反向修正
     只要几秒钟内不漂太多就够用
     → 零偏标定 + ZUPT 完全足够，不需要磁力计
```

**这是个重要的思路：很多应用需要的不是"绝对精准"，而是"短期内够准"。**

---

# 十三、完整可用代码

## 13.1 零偏标定 + 扣零偏

```c
/* ---------- Attitude.c ---------- */
static float GyroBiasX = 0, GyroBiasY = 0, GyroBiasZ = 0;

static void GyroCalibrate(void)
{
    float ax, ay, az, gx, gy, gz;
    float sx = 0, sy = 0, sz = 0;
    uint16_t i;

    for (i = 0; i < 500; i++)
    {
        MPU6050_GetData(&ax, &ay, &az, &gx, &gy, &gz);
        sx += gx; sy += gy; sz += gz;
        { volatile uint32_t d; for (d = 0; d < 3000; d++); }
    }
    GyroBiasX = sx / 500;
    GyroBiasY = sy / 500;
    GyroBiasZ = sz / 500;
}
```

## 13.2 温度补偿（线性模型）

```c
#define TEMP_REF        25.0f       /* 标定时的参考温度 */
#define BIAS_TEMP_K     0.05f       /* 实测得到的温漂系数 ((°/s)/℃) */

static float RefBiasZ = 0;          /* 参考温度下的零偏 */

/* 标定结束时记录参考零偏 */
RefBiasZ = GyroBiasZ;

/* 每次使用时做温度补偿 */
float temp = MPU6050_GetTemp();
float biasZ_now = RefBiasZ + BIAS_TEMP_K * (temp - TEMP_REF);
gz -= biasZ_now;
```

## 13.3 静止检测（ZUPT）

```c
#define STILL_GYRO_TH    0.8f       /* °/s */
#define STILL_ACC_TH     0.08f      /* g */
#define STILL_COUNT_TH   20         /* 连续周期数 */

static uint16_t StillCount = 0;
static uint8_t  IsStill    = 0;

uint8_t CheckStill(float ax, float ay, float az,
                   float gx, float gy, float gz)
{
    float gNorm = sqrtf(gx*gx + gy*gy + gz*gz);
    float aNorm = sqrtf(ax*ax + ay*ay + az*az) - 1.0f;
    if (aNorm < 0) aNorm = -aNorm;

    if (gNorm < STILL_GYRO_TH && aNorm < STILL_ACC_TH)
    {
        if (StillCount < STILL_COUNT_TH) StillCount++;
    }
    else StillCount = 0;

    return (IsStill = (StillCount >= STILL_COUNT_TH));
}
```

## 13.4 在姿态更新里综合使用

```c
void Attitude_Update(void)
{
    float ax, ay, az, gx, gy, gz;
    float dt = ATT_SAMPLE_MS / 1000.0f;
    float norm, temp;

    MPU6050_GetData(&ax, &ay, &az, &gx, &gy, &gz);
    temp = MPU6050_GetTemp();

    /* --- 1) 扣零偏（含温度补偿） --- */
    gx -= GyroBiasX;
    gy -= GyroBiasY;
    gz -= (GyroBiasZ + BIAS_TEMP_K * (temp - TEMP_REF));

    /* --- 2) 加速度计角度（归一化，避免运动干扰） --- */
    norm = sqrtf(ax*ax + ay*ay + az*az);
    if (norm > 0.5f)
    {
        AccPitch = atan2f(ax/norm, az/norm) * RAD2DEG;
        AccRoll  = atan2f(ay/norm, az/norm) * RAD2DEG;
    }

    /* --- 3) 静止检测（ZUPT） --- */
    CheckStill(ax, ay, az, gx, gy, gz);
    if (IsStill)
    {
        /* 静止 → 当前 gz 就是零偏残差，用低通慢慢学 */
        GyroBiasZ = GyroBiasZ * 0.995f + gz * 0.005f;
    }

    /* --- 4) pitch / roll 融合（互补滤波） --- */
    Pitch = ATT_ALPHA * (Pitch + gy * dt) + (1.0f - ATT_ALPHA) * AccPitch;
    Roll  = ATT_ALPHA * (Roll  + gx * dt) + (1.0f - ATT_ALPHA) * AccRoll;

    /* --- 5) yaw：静止时不积分，运动中积分 --- */
    if (!IsStill)                 /* ← 这就是 ZUPT 对 yaw 的作用 */
    {
        Yaw += gz * dt;
    }
    /* 静止时 Yaw 保持不动 —— 相当于每次静止都"冻结"了漂移 */
}
```

## 13.5 磁力计融合（如果以后要做到这一步）

```c
/* ---------- 需要先做椭球校准，参数离线算好 ---------- */
#define MAG_X0   (-23.5f)       /* 硬磁偏移 */
#define MAG_Y0   (  12.8f)
#define MAG_Z0   ( -8.2f)
#define MAG_SX   (1.02f)        /* 软磁缩放 */
#define MAG_SY   (0.98f)
#define MAG_SZ   (1.01f)
#define MAG_NOMINAL  45.0f      /* 当地地磁总强度（需查表/实测） */
#define MAG_TOLERANCE 15.0f

/**
  * 函    数：读磁力计并算出绝对航向
  * 返 回 值：1=数据可信，航向有效；0=磁干扰太大，本次不用
  */
uint8_t MagGetHeading(float Pitch, float Roll, float *Heading)
{
    float mx, my, mz, Xh, Yh, norm;

    Mag_Read(&mx, &my, &mz);                    /* 读原始值 */

    /* 硬磁 + 软磁校准 */
    mx = (mx - MAG_X0) * MAG_SX;
    my = (my - MAG_Y0) * MAG_SY;
    mz = (mz - MAG_Z0) * MAG_SZ;

    /* 可信度检查：总强度应该接近当地地磁强度 */
    norm = sqrtf(mx*mx + my*my + mz*mz);
    if (fabsf(norm - MAG_NOMINAL) > MAG_TOLERANCE) return 0;    /* 有干扰，弃用 */

    /* 倾斜补偿：投影到水平面 */
    Xh = mx * cosf(Pitch * DEG2RAD)
       + my * sinf(Roll * DEG2RAD) * sinf(Pitch * DEG2RAD)
       + mz * cosf(Roll * DEG2RAD) * sinf(Pitch * DEG2RAD);
    Yh = my * cosf(Roll * DEG2RAD) - mz * sinf(Roll * DEG2RAD);

    *Heading = atan2f(-Yh, Xh) * RAD2DEG;
    return 1;
}

/* ---------- 融合到 yaw ---------- */
if (MagGetHeading(Pitch, Roll, &MagHeading))
{
    /* 处理角度回绕 */
    float Err = MagHeading - Yaw;
    while (Err >  180.0f) Err -= 360.0f;
    while (Err < -180.0f) Err += 360.0f;

    /* 互补滤波：陀螺仪为主，磁力计慢修正（系数要小，避免干扰带偏） */
    Yaw += gz * dt + 0.02f * Err;
}
else
{
    /* 磁干扰太大 → 退回纯积分（会漂，但比被干扰带偏好） */
    Yaw += gz * dt;
}
```

---

# 十四、常见误区

## ❌ 误区 1："调一下滤波器参数就不漂了"

**不对。** 滤波能改善的是"抖动"和"短期噪声"，对**常值零偏造成的线性漂移无能为力** ——
因为滤波器看到的是"陀螺仪说我转了"，它没有别的信息来否证这一点。

**唯一有效的是**：标定零偏 + （需要绝对航向时）引入磁力计。

## ❌ 误区 2："卡尔曼滤波能消除 yaw 漂移"

**不对。** 卡尔曼滤波是**最优估计器**，不是**误差消除器**。
输入里没有关于 yaw 的信息，输出里就不可能有 —— 这是信息论的结论，不是算法能突破的。

**能改善的部分**：卡尔曼可以**估计陀螺仪零偏**（把它作为状态量），
所以对"零偏引起的漂移"有一定抑制 —— 但这和"零偏标定"是同一类手段，不是根治。

> [!note] 一个细节
> 本文档里的卡尔曼滤波实现**确实估计了零偏**（`KBias[]`），所以它比互补滤波略好。
> 但即使零偏估计完全正确，**随机游走和温漂造成的漂移依然存在**。

## ❌ 误区 3："漂移是因为我代码写错了"

**大部分情况下不是。** 先用本文档第五章的方法**实测漂移率**：
- 漂移率在 0.02 ~ 0.5 °/s 之间 → **正常**，物理极限
- 漂移率 > 5 °/s → 可能是：
  - 标定时模块在动（最常见）
  - 电源纹波大 / 供电不稳
  - 模块在振动（放在音响、风扇旁边）
  - 附近有强磁场（磁力计坏了，但陀螺仪影响不大）

## ❌ 误区 4："静止标定一次就够了，以后不用管"

**不对。** 三个原因：

| 原因 | 说明 |
|---|---|
| **零偏重复性** | 每次上电零偏略有不同 → **每次都要重新标定** |
| **温漂** | 工作温度变了，零偏跟着变 |
| **机械应力变化** | 拆装、碰撞后零偏会变 |

**正确做法**：每次上电都标定。有条件的话提供"手动重新标定"的按键。

## ❌ 误区 5："用 mpu6050 的 DMP 就没有漂移了"

**部分不对。**

MPU6050 内置 **DMP（Digital Motion Processor，数字运动处理器）**，
可以硬件运行姿态融合算法，直接输出四元数。**它好用，但不是万能**：

| 优点 | 局限 |
|---|---|
| 融合在芯片内做，不占 CPU | **6 轴 DMP 的 yaw 依然会漂**（同样没有绝对参考） |
| MicroPython/Arduino 有现成库 | DMP 库较难移植、资料零散 |
| 输出四元数，避免万向锁 | 无法调整内部滤波参数 |

**关键**：DMP 的 6 轴模式用加速度计 + 陀螺仪 —— **和我们的互补滤波信息量完全一样**，
所以 yaw 的漂移问题**一模一样**。要用 DMP 解决 yaw，同样得接磁力计（9 轴模式）。

## ❌ 误区 6："yaw 漂移是硬件质量问题，换个模块就好了"

**不完全对。** 换模块能改善的只有"常值零偏的大小"（好模块出厂零偏更小），
但**漂移的物理本质不会变** —— 换任何 6 轴 IMU（哪怕几千元的工业级）都还是只有陀螺仪能测 yaw。

工业级 IMU 的优势是**零偏更小更稳**（比如 0.01 °/s 甚至更低），
所以漂得慢，但**不是不漂**。（惯导系统依然需要定期用外部参考校准。）

## ✅ 正确的心态

```text
1. 先接受"6 轴 IMU 的 yaw 一定会漂"这个物理事实
2. 然后问："我的应用真的需要绝对 yaw 吗？"
   ├─ 不需要 → 绕开它（本题的做法）
   ├─ 需要短期准 → 零偏标定 + ZUPT，够用
   └─ 需要长期准 → 加磁力计或外部参考，接受其代价
```

---

# 附：一句话回答"如何解决 yaw 零飘"

> **yaw 零飘的根源是"没有参考量"：加速度计测重力，而绕重力轴旋转时重力方向不变，所以加速度计对 yaw 完全无感，yaw 只能靠陀螺仪积分。**
>
> **解决路径分三层：**
> 1. **抑制**：零偏标定（必做，10~50 倍改善）、温度补偿、静止检测 ZUPT
> 2. **根治**：加磁力计做椭球校准 + 倾斜补偿 + 融合，获得绝对航向
> 3. **绕开**：如果应用不需要 yaw 就不要用（本题手势控制只用 pitch/roll）
>
> **注意**：前两者都无法让 6 轴 IMU 的 yaw 不漂 —— 零偏标定只消除常值项，
> 随机游走和温漂依然存在。这是物理限制，不是算法问题。

---

## 相关

- [[阶段五 任务3 角度稳定性与Yaw漂移]] — 实测程序与实验步骤
- [[阶段五 任务2 原理详解]] — 互补滤波与卡尔曼滤波的数学细节
- [[阶段五 任务1 原理详解]] — MPU6050 与 I2C 基础
- [[五阶段 MOC]] — 阶段索引
