tomorrozy/gesture-control-car/docs/03-零基础落地包/01-器材采购与到货核对清单.md

---
tags:
  - STM32/硬件
  - 电控组
  - 零基础
aliases:
  - 器材采购清单
  - 采购清单
  - 到货核对清单
  - 01 器材采购与到货核对清单
type: 清单
status: ⬜ 待执行（未下单）
project: STM32手势小车
---

# 01 器材采购与到货核对清单

> [!summary] 这一页解决什么问题
> 库里的 `STM32手势小车 MOC` 有一张「硬件物资」表，但它只有 **10 行「型号 + 数量」**，
> **没有规格、没有接插件、没有充电器、没有机械件、没有到货核对**。
> 这一篇把它补成**能直接下单、能照着点货**的版本。
>
> ★ **规格以实物铭牌为准**：下面凡是「约 / 典型」的值，都是常见型号的量级，
> 买到手第一件事是**核对铭牌**并回填到 [[硬件实测清单]] 的参数表。

---

## 一、必买清单（完整八阶段版）

> 说明：**「阶段」列**表示这件东西从第几阶段开始要用。
> 只做到阶段 2、3 的同学可以照着最后一列裁剪。

| # | 类别 | 规格（★ 关键点） | 数量 | 参考价 | 从哪阶段要 | 为什么是这个 / 买错的后果 |
|:--:|---|---|:--:|:--:|:--:|---|
| 1 | **主控板** | STM32F103C8T6 最小系统板（蓝色核心板，带 8MHz 晶振 + Micro-USB 或 Type-C） | **2**（★ 强烈建议备 1 = 3） | ¥15~25/片 | 1 | 双机阶段必须**两块板**；烧录失误容易锁片，备一片能救命 |
| 2 | **电机** | JGB37-520 **12V 带霍尔编码器**减速电机，**减速比 1:30**，输出轴 **6mm D 型**；引出 **6 根线**（M+ M- VCC GND A B） | **2** | ¥35~55/个 | 2 | ★ 必须**带编码器**（阶段 7 的 PID 要反馈）；★ 不要买 TT 马达 / 无编码器电机 —— **到阶段 7 直接卡死，只能重买** |
| 3 | **驱动板** | TB6612FNG 模块（双路，VM 独立供电，STBY 使能脚） | **1**（备 1） | ¥8~15 | 2 | ★ **不要买 L298N**：压降大（约 2V）、发热大，12V 进去到电机只剩 10V，且体积大 |
| 4 | **姿态传感器** | GY-521 模块（MPU6050 + 板载 LDO + 上拉），**AD0 可接地** | **1**（备 1） | ¥8~15 | 5 | 板载 LDO 让你能用 5V 供电；★ AD0 接 GND = 地址 0x68（代码按这个写） |
| 5 | **无线** | HC-05 蓝牙模块，**带底板、带配对按键、带状态 LED** | **2**（★ 一主一从，建议备 1） | ¥20~35/个 | 4 | ★ 必须**买带底板的**（裸模块是 3.3V，接 5V 会烧）；必须**带按键**才能进 AT 模式 |
| 6 | **显示** | 0.96 寸 OLED，**SSD1306，I2C 接口（4 针：VCC/GND/SCL/SDA）** | **2** | ¥10~18 | 2 | ★ 一定买 **I2C 版**，不要 7 针 SPI 版（代码只支持 I2C，接错就是全黑屏） |
| 7 | **电池** | **3S 11.1V 锂聚合物电池**（满电 12.6V），容量 **≥ 1500mAh**，放电 **≥ 20C**（即 ≥ 30A 能力） | 1~2 | ¥60~120 | 2 | ★ 电机启动/换向瞬间电流很大，**9V 方电池 / 18650 单节绝对带不动**（会表现为「一换向就复位」） |
| 8 | **充电器** | 配套 3S 平衡充（B3 / B6 之类），**带平衡头** | 1 | ¥35~80 | 2 | ★ 锂电池必须用平衡充；别用「万能充」 |
| 9 | **降压模块** | LM2596 可调降压模块（或 MP1584 / mini-360），**输出电流 ≥ 2A 档** | **2**（备 1） | ¥3~8 | 2 | 一路降到 **5V** 给两块板 / HC-05 / OLED；★ 电机**绝不能**经过降压模块 |
| 10 | **电源开关** | 船型开关或自锁按钮，**额定 ≥ 3A** | 1 | ¥2~5 | 2 | ★ 验收时「一键断电」比拔电池体面也安全（第八阶段任务 2 提到） |
| 11 | **保险丝座** | 5A 保险管 + 座（或自恢复保险） | 1 | ¥2~5 | 8 | ★ 第一次上电、第一次给电机上电，**有保险不会烧板** |
| 12 | **电容** | 电解电容 **470µF/25V** ×2、**100µF/25V** ×2、陶瓷 **0.1µF** ×6 | 若干 | ¥5 | 4 | ★ HC-05 掉线的头号原因是**电源塌陷**，VCC 并 100µF+0.1µF 是最便宜的解药 |
| 13 | **接插件** | 电池端 **T 插 / XT60**（公母成对）、DC 头、**免焊端子** | 1 套 | ¥10 | 2 | ★ 别用杜邦线直接怼电池（接触电阻大、会打火） |
| 14 | **杜邦线** | 公对母 20cm ×40、母对母 ×40、公对公 ×20，**彩色分色** | 1 套 | ¥15~25 | 1 | ★ 分色（红=VCC 黑=GND 其他=信号）能省掉大量排查时间 |
| 15 | **USB-TTL** | CH340 模块（**能 3.3V/5V 切换**，带 TX/RX 指示灯） | 1 | ¥8~15 | 1 | 阶段 1 要和电脑通信；AT 配置蓝牙也要它 |
| 16 | **下载器** | ST-Link V2（或 V2-1 / DAPLink） | 1 | ¥15~30 | 1 | ★ 比 USB 串口 ISP 稳定得多；**必须能连上 SWD** |
| 17 | **万用表** | 数字万用表（**带通断蜂鸣档、直流电压档**） | **1** | ¥30~80 | ★ **全程必备** | ★ 没有它你只能靠猜：短路、共地、STBY 电压、电池跌落都测不了 |
| 18 | **轮子** | **65mm 橡胶轮**，轮毂孔位与电机 **6mm D 轴**匹配 | **2** | ¥8~15/个 | 8 | ★ 轮径直接影响速度标定（`WHEEL_RADIUS_M`），量了再改代码 |
| 19 | **万向轮 / 第三点** | 尼龙万向轮 或 钢珠万向轮，**高度与 65mm 轮匹配**（保证底盘水平） | 1~2 | ¥5~15 | 8 | ★ 两轮车没有第三点就会**前后翻**；高度不对会一直往一边跑 |
| 20 | **底盘** | 亚克力/铝合金 2WD 小车底盘（约 15×12cm），或自制洞洞板 | 1 | ¥20~50 | 8 | 用来固定电池、驱动、主控 |
| 21 | **电机支架** | 与 JGB37-520 匹配的 L 型支架（**孔距要对**） | 2 | ¥5~10/个 | 8 | ★ 孔径/孔距不匹配 = 装不上 |
| 22 | **螺丝铜柱** | M3 螺丝螺母 + 铜柱套装（6/10/20mm） | 1 套 | ¥15~25 | 8 | 固定驱动板、主控、底盘 |
| 23 | **固定耗材** | 3M 双面胶/魔术贴、扎带、热缩管、尼龙扎线 | 若干 | ¥15 | 5 | ★ MPU6050 和 OLED 必须**粘贴牢固**：松动 = 读数跳 |
| 24 | **焊接工具** | 烙铁 + 焊锡 + 助焊剂 + 吸锡带 + 斜口钳 + 剥线钳 | 1 套 | ¥50~120 | 8 | 电机线、电池线**必须焊**（杜邦线过不了电机电流） |
| 25 | **示波器 / 逻辑分析仪** | 逻辑分析仪 8 通道（¥30 起）就够用 | 1（★ 强烈建议） | ¥30~300 | 4 | 量 PWM 频率、串口波特率、I2C 时序 —— 有它排查速度快 10 倍 |

> [!tip] 预算参考（不含 Keil、不含示波器）
> **最小可跑（阶段 1~2）约 ¥120~180**；
> **完整八阶段约 ¥350~600**；
> 加上烙铁套装与逻辑分析仪约 ¥500~900。

---

## 二、分档裁剪：你只需要哪一块

| 你的目标 | 需要的条目 |
|---|---|
| **只做阶段 1（双机通信）** | 1、14、15、16、17 |
| **只做阶段 2（电机驱动）** | 1、2、3、6、7、8、9、10、14、16、17（+ 12） |
| **做到阶段 4（蓝牙无线）** | 上面 + 5、13 |
| **做到阶段 8（完整小车）** | **全买** |

> ⚠️ **别为了省钱跳编码器阶段**：阶段 7、8 是整套材料的**重点**（PID 闭环 + 差速），
> 也是面试/答辩最看重的部分，跳过等于白做。

---

## 三、选型避坑：10 条「买错就走不通」

| # | 别买 / 别做 | 为什么 |
|:--:|---|---|
| 1 | ★★ **无编码器电机、TT 马达、L298N** | 阶段 7 必须有测速反馈；L298N 压降大、发热 |
| 2 | ★★ **9V 方电池 / 单节 18650 直供** | 电流能力不够 → 电机一转就复位 |
| 3 | ★ **裸装 HC-05（无底板）** | 直接上 5V 会烧；且没有按键进不了 AT 模式 |
| 4 | **7 针 SPI OLED** | 代码里的 OLED 驱动是 I2C（PB8/PB9），SPI 版接不上 |
| 5 | **MPU6050 模块无 AD0 引出** | 无法把地址定成 0x68；代码按 0x68 写 |
| 6 | **轮毂孔位与电机轴不匹配** | 装不上，只能重新买；下单前问清「是否适配 6mm D 轴」 |
| 7 | **万向轮高度随意买** | 底盘不水平 → 车会自己往一边跑，PID 参数怎么调都不对 |
| 8 | ★ **只用杜邦线走电机电流** | 接触电阻大、会发热打火；电机线要焊接、≥ 0.5mm² |
| 9 | **两块板 3.3V 输出互连** | 两个电源硬连会互相灌电流，可能损坏板子（库内一阶段任务 2 有明确警告） |
| 10 | **想用 USB 供电跑电机** | 违反 PDF 硬性要求 1，而且必然拉塌电压 |

---

## 四、到货核对表（收到货当天逐项打勾）

> ★ **先点货，再焊接**。缺件、错件、坏件在**收货当天**发现最好退换。

| # | 核对项 | 怎么核对 | ✔ |
|:--:|---|---|:--:|
| 1 | 两块 STM32 板**都能被电脑识别** | 插 USB，看设备管理器是否出现串口/ST-Link | ⬜ |
| 2 | 两块板**都能下载程序** | ST-Link + Keil 下载一个 LED 闪灯例程 | ⬜ |
| 3 | 电机**轴能手动转动**、无异响 | 手转输出轴，感觉是否有轻微阻尼（有减速箱是正常的） | ⬜ |
| 4 | 电机**6 根引线有标签**（M+/M-/VCC/GND/A/B） | ★ 没标签的用万用表/示波器自己确认，或查卖家图 | ⬜ |
| 5 | 编码器**供电电压**确认（3.3V 还是 5V） | 看模块铭牌/卖家资料；**接错会烧编码器** | ⬜ |
| 6 | TB6612 模块丝印清楚（VM/VCC/GND/STBY/AIN1/AIN2/BIN1/BIN2/AO1/AO2/BO1/BO2/PWMA/PWMB） | 丝印不清的拍照放大看 | ⬜ |
| 7 | 两个 HC-05 **都能进 AT 模式** | 按住按键上电，LED 约 2 秒闪一次 | ⬜ |
| 8 | 两个 OLED **通电有反应**（接 3.3V/5V + I2C 后能显示） | 先用卖家给的例程点一次 | ⬜ |
| 9 | GY-521 **AD0 引出了** | 看模块丝印有 AD0 焊盘/排针 | ⬜ |
| 10 | 电池**电压正常**且**能充电** | 万用表量 3S 应在 9.0~12.6V | ⬜ |
| 11 | 降压模块**空载能不能调到 5.0V** | ★ **先调好再上板**（用万用表看着调电位器） | ⬜ |
| 12 | 轮子/支架**孔位对得上电机** | 拿实物对一下，不对立刻换 | ⬜ |
| 13 | 万用表**通断档正常** | 两表笔短接应蜂鸣 | ⬜ |
| 14 | 杜邦线**通断抽检 10 根** | ★ 便宜排线常有断芯，抽检能省后面几小时 | ⬜ |
| 15 | 焊锡/烙铁可用 | 试焊一根线，看是否上锡顺畅 | ⬜ |

---

## 五、收货当天 30 分钟自检（★ 别急着接整机）

> ★ **这一步的目的：把「器件本身是坏的」和「接线/代码错」分开。**
> 库里 [[12 模拟面试题库 第三轮 故障模拟30题与答辩预演]] 反复强调第一原则：
> **先分物理层（供电/接线/共地/电平），再怀疑代码。**

| # | 做什么 | 期望 | 不对怎么办 |
|:--:|---|---|---|
| 1 | 万用表通断档，量电池正负极**不短路** | 不蜂鸣 | 蜂鸣 → 检查接插件焊点是否搭锡 |
| 2 | 电池 → 降压模块，**空载**调出 5.00V | 4.9~5.1V | 调不出 → 模块坏或输入电压超范围 |
| 3 | 只给 STM32 供 5V（USB 也行），下载一个 GPIO 翻转程序 | LED 闪 / 示波器有方波 | 下载失败先看 [[02 工具链与软件安装配置]] |
| 4 | 电机两端直接接电池（**点一下就好，别久接**） | 电机转 | 不转 → 电机或线坏 |
| 5 | 电机接 TB6612，给 PWMA 一个固定 PWM，AIN1/AIN2 给方向 | 能正反转 | 不转 → 先量 STBY 是否高、VM 是否有 12V |
| 6 | 手转电机轴，示波器/逻辑分析仪看 A/B 相 | 能看到两路错开 90° 的方波 | 没有 → 编码器没供电或线接错 |
| 7 | 单个 HC-05 进 AT 模式，串口助手发 `AT` | 回 `OK` | 没回 → 波特率 38400、勾选「发送新行」 |
| 8 | 单独给 OLED 上电，跑一次点亮例程 | 屏幕有内容 | 全黑 → 先查 I2C 地址与供电 |

---

## 六、采购关键词（方便直接搜索）

```text
STM32F103C8T6 最小系统板
JGB37-520 12V 编码器电机 1:30
TB6612FNG 电机驱动模块
GY-521 MPU6050 模块
HC-05 蓝牙模块 带底板 带按键
0.96寸 OLED I2C SSD1306 4针
3S 11.1V 锂聚合物电池 1500mAh 20C
3S 平衡充电器 B3
LM2596 可调降压模块
CH340 USB转TTL 模块
ST-Link V2 下载器
65mm 橡胶轮 6mm D 轴 轮毂
万向轮 小车 第三轮
M3 铜柱螺丝套装
船型开关 3A
杜邦线 公对母 母对母 公对公
```

---

> 关联文档：
> - ★ 下一步：[[02 工具链与软件安装配置]]
> - ★ 接线前必看：[[05 引脚权威总表与阶段接线改动]]
> - ★ 电源与上电：[[03 供电共地与上电安全]]
> - 原有物资表：[[STM32手势小车 MOC]] 的「硬件物资」章节
> - 实测与回填：[[硬件实测清单]]
