tomorrozy/gesture-control-car/docs/04-调试笔记/阶段一_双机通信.md

---
title: Debug 阶段一 双机通信
tags:
  - RM电控
  - STM32/阶段一
  - Debug/UART
version: V2
updated: 2026-10-23
---

> [!danger] 🚨 版本交接指令
> 请将旧版 `Debug_阶段一_双机通信_V1.md` 移入回收站，保存此 `_V2` 文件，并把主教程与全库双链改指本文件。

# Debug · 阶段一 · 双机通信

> [!tip] 配套主教程
> 本章代码讲解见：[[阶段一_主教程_双机通信_V2]]

---

## 一、排查总顺序

```text
① 接线：PA9→RXD、PA10→TXD、GND 共地
② 参数：115200 8N1、无流控、两边一致
③ 供电与时钟：USART1/GPIOA 时钟是否开
④ 发送：fputc 等的是 TC(0x40) 还是 TXE
⑤ 接收：RXNE 中断是否开、USART_RX_STA 是否在变
```

> [!info] 三个速查点
> ① 乱码先量波特率；② 完全没动静先查时钟；③ 收到但拼不出帧先看 `0x0D/0x0A`。

---

## 二、【现象】→【可能原因】→【排查步骤】→【修正与防范】

| 现象 | 可能原因 | 排查步骤 | 修正与防范 |
|---|---|---|---|
| 串口助手**全是乱码** | 波特率/校验/停止位不一致 | 两边都设 115200 8N1；示波器量 1 bit ≈ 8.68 µs | 统一参数，写进注释 |
| **完全没输出** | ① PA9 未配 `AF_PP` ② 没开 USART1 时钟 ③ 没调 `USART_Cmd` ④ 没重定向 `fputc` | 万用表量 PA9 空闲高；示波器夹 PA9 发字符看波形；查 `usart.c:69/74/100` | 按 3.3/3.4 顺序检查；用 `printf("T")` 做最小验证 |
| **能发不能收** | PA10 未配 `IN_FLOATING`；RXNE 未开 | 查 `usart.c:79`、`:99` | 改 `IN_FLOATING`、`USART_ITConfig(...RXNE, ENABLE)` |
| **能收不能发** | PA9 配成输入；`USART_Mode` 只开 Rx | 查模式字（`:96`） | `USART_Mode_Rx \| USART_Mode_Tx` |
| **连发丢字符** | 等的是 TXE 而不是 TC，或压根没等 | 看 `usart.c:29` 是不是 `0x40` | 等 TC 再写 `DR` |
| **收到但拼不出帧** | 没用 `\r\n` 结尾；或长度/校验不符 | 看 `USART_RX_STA` 是否 `0x8000`；发 `abc\r\n` 应得到 `0x8003` | 按 13 字节协议发，或确认状态机语义 |
| **偶尔整帧作废** | 帧内出现 0x0D 后又非 0x0A | 抓原始字节看是否混入回车 | 二进制协议不要用 `0x0D/0x0A` 做数据 |

---

## 三、工具怎么用

| 工具 | 怎么测 | 正常值 |
|---|---|---|
| 万用表 | 量 PA9 空闲电平 / VCC | PA9 高（≈3.3 V） |
| 示波器 | 夹 PA9 发一个字符 | 方波，1 bit ≈ **8.68 µs**（115200） |
| 串口助手 | 发 `abc\r\n` | `USART_RX_STA` 变 `0x8003`（bit15=1、计数=3） |
| 调试器 | Watch `USART_RX_STA`、`USART_RX_BUF` | 状态位/缓冲随数据变化 |

---

## 四、本阶段 4 个必踩坑

> [!warning] 坑 1 · 忘开时钟
> `RCC_APB2PeriphClockCmd(RCC_APB2Periph_USART1|RCC_APB2Periph_GPIOA, ENABLE)` 少一个：**不报错，只沉默**。

> [!warning] 坑 2 · PA9/PA10 模式不对称
> TX 必须 `AF_PP`，RX 必须 `IN_FLOATING`；两个都配成一样的，必然单向不通。

> [!warning] 坑 3 · 半主机没关
> 不勾 MicroLIB 且没有 `#pragma import(__use_no_semihosting)`，程序可能卡在启动阶段（`usart.c:12`）。

> [!warning] 坑 4 · 用 ASCII 协议思路测二进制协议
> 你的帧里有 `0x0D` 帧尾、`0xA5` 帧头；用文本模式发会破坏长度/校验——用十六进制发送。

---

## 五、10 分钟定位法

1. 万用表量 VCC、GND，确认共地。
2. 串口助手 115200 8N1，发一个字符看是否回显。
3. 没回显 → 查时钟/引脚/`USART_Cmd`；有回显但乱码 → 查波特率。
4. 示波器夹 PA9，确认 8.68 µs 位宽。
5. 发 `abc\r\n`，调试器看 `USART_RX_STA` 是否 `0x8003`。
6. 拼 13 字节帧（十六进制），确认 `Protocol_Unpack` 返回 0。

---

## 六、防幻觉审计报告

> [!success] 🛡️ 防幻觉审计报告
> 1. **代码出处核实**：是。`usart.c:29/69/74/79/96/99/100`、`USART_RX_STA/BUF`、`FRAME_LEN=13` 均来自你提供的文件。
> 2. **库的纯洁性**：未混用，StdPeriph。
> 3. **脑补排查**：否。位宽 8.68 µs 为算术换算；排针位置标为需按丝印确认；`0x8003` 为按状态机推导。
> 4. **本次悬空依赖**：无新增。

#RM电控 #STM32 #Debug #UART
