tomorrozy/gesture-control-car/docs/04-调试笔记/阶段七_速度闭环PID.md

---
title: Debug 阶段七 速度闭环PID
tags:
  - RM电控
  - STM32/阶段七
  - Debug/PID
version: V2
updated: 2026-10-23
---

> [!danger] 🚨 版本交接指令
> 请将旧版 `Debug_阶段七_速度闭环PID_V1.md` 移入回收站，保存此 `_V2` 文件，并把主教程与全库双链改指本文件。

# Debug · 阶段七 · 速度闭环 PID

> [!tip] 配套主教程
> 本章代码讲解见：[[阶段七_主教程_速度闭环PID_V2]]

---

## 一、排查总顺序

```text
① 反馈有没有：g_act 是否随轮子变化
② 反馈符号对不对：给正目标看反馈是否上升
③ 输出有没有：pwm_L_temp 是否在变
④ 输出能不能驱动：电机是否真转（阶段二）
⑤ 波形：接 VOFA 看超调/振荡/稳态误差
```

> [!info] 三个速查点
> ① 不动先查反馈；② 发散先查符号；③ 抖先查周期。

---

## 二、【现象】→【可能原因】→【排查步骤】→【修正与防范】

| 现象 | 可能原因 | 排查步骤 | 修正与防范 |
|---|---|---|---|
| 车不动但 PWM 有值 | 电机/驱动问题 | 直接给固定 PWM 试 | 回阶段二 |
| **猛冲/发散** | 反馈符号反；Ki 太大 | 给正目标看反馈是否上升 | 反相/降 Ki |
| **振荡** | Kp 太大、周期不稳、噪声 | 看波形；固定周期 | 降 Kp；`vTaskDelayUntil` |
| **稳态误差大** | Ki 太小；或标度错 | 看目标与实际长期差 | 加 Ki；修正减速比 |
| 松手后猛冲一下 | 积分饱和（无抗饱和） | 堵转几秒再松 | 输出饱和时停积分 |
| 低速调不准 | 补偿锁 30% | 目标 5/10/20 试 | 改补偿策略 |
| 两轮不一致 | 机械差/线数/参数 | 分别看两轮波形 | 单独微调 |
| 波形跳变 | 反馈标度错（9.27666 vs 13） | 手转输出轴一圈数计数 | 改 13（前提线数=13） |

---

## 三、工具怎么用

| 工具 | 用法 | 看什么 |
|---|---|---|
| VOFA/串口 | 打印 `目标,实际,PWM` | 上升时间/超调/稳态误差 |
| 调试器 | Watch `pid_left.integral` | 长期贴 ±100 = 饱和 |
| 示波器 | 夹 PWM 引脚 | 占空比是否跟随 |

---

## 四、本阶段 4 个必踩坑

> [!warning] 坑 1 · 改周期不重调 Ki
> `integral += err` 没乘时间，等效 `Ki=ki/T`；周期变，参数就变。

> [!warning] 坑 2 · 没有抗积分饱和
> 只有“积分夹紧”（`main.c:81–82`），堵转后松手仍会猛冲。

> [!warning] 坑 3 · `kd` 是摆设
> 公式只有 P+I（`main.c:84`），改 `kd` 输出不变。

> [!warning] 坑 4 · 打印拖慢周期
> 20 ms 任务里每拍打印 30 字符，周期被拉长，参数又得重调。

---

## 五、10 分钟定位法

1. 手转轮子，看 `g_act` 是否变化、符号是否正确。
2. 临时写死目标 50，看 `pwm_L_temp` 与电机是否动。
3. 串口打三列，观察 5 秒。
4. 把 Ki 设 0 看纯 P 稳态误差，再加回。
5. 手捏轮子 2 秒松开，看是否猛冲（判断抗饱和）。

---

## 六、防幻觉审计报告

> [!success] 🛡️ 防幻觉审计报告
> 1. **代码出处核实**：是。`PID_Calc`、`pid_left.target`、`g_act_left`、`pwm_L_temp`、`main.c:81–82/84`、起转补偿、`configTICK_RATE_HZ` 均来自你提供的文件。
> 2. **库的纯洁性**：未混用，StdPeriph + FreeRTOS。
> 3. **脑补排查**：否。未编造引脚或参数；`Ki/T` 关系为推导；线数标为反推值。
> 4. **本次悬空依赖**：`Encoder_Get`、`Motor_SetPWM`（阶段二）。

#RM电控 #STM32 #Debug #PID
