tomorrozy/gesture-control-car/docs/04-调试笔记/阶段二_电机驱动.md

---
title: Debug 阶段二 电机驱动
tags:
  - RM电控
  - STM32/阶段二
  - Debug/电机
version: V2
updated: 2026-10-23
---

> [!danger] 🚨 版本交接指令
> 请将旧版 `Debug_阶段二_电机驱动_V1.md` 移入回收站，保存此 `_V2` 文件，并把主教程与全库双链改指本文件。

# Debug · 阶段二 · 电机驱动

> [!tip] 配套主教程
> 本章代码讲解见：[[阶段二_主教程_电机驱动_V2]]

---

## 一、排查总顺序

```text
① 不转：量 12V / STBY / PWM 波形
② 单向：查方向脚组合
③ 发热/没劲：电源、频率、占空比
④ 编码器：供电、上拉、相序、滤波
⑤ 数值：52 计数/电机圈、676 计数/输出圈
```

> [!info] 三个速查点
> ① 先架空；② 先开环给固定 PWM；③ 先看波形再看代码。

---

## 二、【现象】→【可能原因】→【排查步骤】→【修正与防范】

| 现象 | 可能原因 | 排查步骤 | 修正与防范 |
|---|---|---|---|
| **完全不转** | 12V 未供 / STBY 未拉高 / PWM 无输出 / `Motor_Init` 未调 | 万用表量 VM、STBY；示波器夹 PA0 | 补供电/STBY；确认初始化被调用 |
| **只转一个方向** | 一根方向脚虚焊/接错 | 量 PB12/PB13 是否随命令翻转 | 重焊或换脚 |
| **一转就停/发热** | 电源带不动；两方向脚同时为高（刹车） | 串电流表看启动电流；量方向脚组合 | 加大电源；检查代码分支 |
| **速度不受控** | PWM 频率不对 | 示波器量应为 20 kHz | 核对 PSC=35、ARR=99 |
| **编码器计数不动** | 未供电 / 未上拉 / A/B 接错 | 量编码器 VCC；示波器夹 PA6 | 供电、`IPU`、换相序 |
| **计数乱跳** | 干扰/未滤波/未共地 | 看波形毛刺；量 GND 通断 | 滤波 `0xF`、共地、加电容 |
| **读数正负反** | 右轮镜像但未反相 | 手转右轮看 `Encoder_Get(2)` 符号 | TIM4 第二极性改 `Falling` |
| **转速偏大 40%** | 减速比/线数填错 | 手转输出轴一圈数计数（应 676） | 改 `13.0f`（前提线数=13），重调 Ki |
| **PID 一上就抖** | 反馈符号反（正反馈） | 给正目标看反馈是否上升 | 反相/交换 A/B |

---

## 三、工具怎么用

| 工具 | 测什么 | 正常值 |
|---|---|---|
| 万用表 | VM-GND / STBY / 方向脚 | 12 V / 高 / 0 或 3.3 V 翻转 |
| 示波器 | PA0 PWM | 20 kHz 方波（周期 50 µs） |
| 示波器 | PA6 编码器相 | 手转轮子有方波，两相错开 90° |
| 调试器 | `encL/encR`、`g_act_left` | 正负与数值随转动变化 |

---

## 四、本阶段 4 个必踩坑

> [!warning] 坑 1 · 忘开 GPIOB 时钟
> PWM 有波形但方向脚不动，电机只往一个方向转（`Motor.c:12`）。

> [!warning] 坑 2 · 左右方向脚极性不同
> 左轮 PB12 高正转，右轮 PB15 高正转；接成一样就是原地打转（`Motor.c:35/50`）。

> [!warning] 坑 3 · 编码器没上拉
> 霍尔多为开漏，`IN_FLOATING` 会读不稳；代码用的是 `IPU`（`Encoder.c:18/60`）。

> [!warning] 坑 4 · 同一周期重复读编码器
> `Encoder_Get` 读一次就清零；同周期读两次，第二次必为 0（`Encoder.c:105–107`）。

---

## 五、10 分钟定位法

1. 架空，量 12 V 与 STBY 高。
2. 临时给 `Motor_SetPWM(1,40)`，示波器看 PA0。
3. 量 PB12/PB13 组合。
4. 手转左轮，示波器看 PA6/PA7。
5. 调试器看 `encL` 数值与符号。
6. 两轮同给 40，看是否直行；跑偏先查机械。

---

## 六、防幻觉审计报告

> [!success] 🛡️ 防幻觉审计报告
> 1. **代码出处核实**：是。`Motor.c:12/35/50`、`PWM.c` 的 PSC/ARR、`Encoder.c:18/60/105–107`、`9.27666` 均来自你提供的代码。
> 2. **库的纯洁性**：未混用，StdPeriph。
> 3. **脑补排查**：否。TB6612/编码器接线标待确认；`676`、`40%` 为按 1:13 推导；线数标为反推值。
> 4. **本次悬空依赖**：无新增。

#RM电控 #STM32 #Debug #电机
