tomorrozy/gesture-control-car/docs/04-调试笔记/阶段八_手势控小车.md

---
title: Debug 阶段八 手势控小车
tags:
  - RM电控
  - STM32/阶段八
  - Debug/差速
version: V2
updated: 2026-10-23
---

> [!danger] 🚨 版本交接指令
> 请将旧版 `Debug_阶段八_手势控小车_V1.md` 移入回收站，保存此 `_V2` 文件，并把主教程与全库双链改指本文件。

# Debug · 阶段八 · 手势控小车

> [!tip] 配套主教程
> 本章代码讲解见：[[阶段八_主教程_手势控小车_V2]]

---

## 一、排查总顺序

```text
① 单轮能转吗（阶段二开环）
② 两轮同向吗（差速符号与安装）
③ 直行跑偏吗（左右参数/机械）
④ 转向对吗（REVERSE_TURN 一处）
⑤ 稳吗（归一化、斜坡、失联）
```

> [!info] 三个速查点
> ① 打转先看方向脚；② 失真看是否归一化；③ 断电不停看失联保护。

---

## 二、【现象】→【可能原因】→【排查步骤】→【修正与防范】

| 现象 | 可能原因 | 排查步骤 | 修正与防范 |
|---|---|---|---|
| 前进变后退 | 遥控 `×-1.0f` 或 `REVERSE_TURN` 反 | 看电机方向脚组合 | 调宏/调符号（只改一处） |
| 转向左右反 | `REVERSE_TURN`、`Gesture_Map:66`、遥控取反三者之一 | 侧翻看车实际方向 | 两处一起改会抵消 |
| **原地打转** | 左右方向脚极性不同（右轮 PB15 高正转） | 单独给两轮相同 PWM | 改接线或改 `Motor.c` |
| 直行跑偏 | 两轮机械差异、参数相同 | 空旷地直行 5 m 量偏移 | 左右单独微调/纠偏 |
| 大角度斜推失真 | 未归一化 | 打印 `targetL/targetR` 比例 | 加归一化（阶段八 3.8） |
| 起步窜/停车点头 | 目标无斜坡 | 看 PWM 阶跃 | 加 `slew` |
| 一顿一顿 | 周期抖动/补偿跳变 | 打印周期与 PWM | 固定周期、改补偿 |
| 遥控断电继续跑 | 无失联保护 | 关遥控观察 | 超时清零目标 |
| 屏幕倒装 | `SCREEN_FLIP` 未设 | 看四行顺序 | 改宏（`main.c:17`） |

---

## 三、工具怎么用

| 工具 | 测什么 | 正常值 |
|---|---|---|
| 调试器 | `speed_x/speed_y/targetL/targetR` | 比例随倾斜角稳定 |
| 串口 | `targetL,targetR,pwm_L,pwm_R` | 看比例与阶跃 |
| 卷尺/地砖 | 直行 5 m 偏移 | 越小越好 |

---

## 四、本阶段 4 个必踩坑

> [!warning] 坑 1 · 用“都置高”的直觉接方向脚
> 左轮 PB12 高正转、右轮 PB15 高正转；接反就是原地打转（`Motor.c:35/50`）。

> [!warning] 坑 2 · 各自截断破坏差速比例
> `main.c:256–259` 各自夹 ±100：`(169.2,30.8)` 变 `(100,30.8)`，比例 5.5:1→3.25:1。

> [!warning] 坑 3 · 目标直接阶跃
> 0→100 一步到位，电流与机械冲击都大；加斜坡（`step` 5~10）。

> [!warning] 坑 4 · `SCREEN_FLIP` 当旋转用
> 它只是把行坐标反写（48↔1、32↔16），不是旋转屏幕（`main.c:355–388`）。

---

## 五、10 分钟定位法

1. 架空，分别给 `Motor_SetPWM(1,40)`、`(2,40)`，确认两轮同向。
2. 给 `(1,40)`、`(2,-40)`，确认原地转。
3. 打印 `targetL/targetR`，倾斜 80/60 看比例是否失真。
4. 直行 5 m 量偏移。
5. 关遥控测停车时间；不停就加超时。

---

## 六、防幻觉审计报告

> [!success] 🛡️ 防幻觉审计报告
> 1. **代码出处核实**：是。`REVERSE_TURN`、`targetL/targetR`、`Motor_SetPWM`、`SCREEN_FLIP`（`main.c:17`）、`main.c:256–259/355–388` 均来自你提供的文件。
> 2. **库的纯洁性**：未混用，StdPeriph + FreeRTOS。
> 3. **脑补排查**：否。未编造机械参数；轮距/轮径标待确认；比例为算术推导。
> 4. **本次悬空依赖**：无新增。

#RM电控 #STM32 #Debug #差速
