tomorrozy/gesture-control-car/docs/04-调试笔记/阶段六_手势控电机.md

---
title: Debug 阶段六 手势控电机
tags:
  - RM电控
  - STM32/阶段六
  - Debug/手势
version: V2
updated: 2026-10-23
---

> [!danger] 🚨 版本交接指令
> 请将旧版 `Debug_阶段六_手势控电机_V1.md` 移入回收站，保存此 `_V2` 文件，并把主教程与全库双链改指本文件。

# Debug · 阶段六 · 手势控电机

> [!tip] 配套主教程
> 本章代码讲解见：[[阶段六_主教程_手势控电机_V2]]

---

## 一、排查总顺序

```text
① pitch/roll 稳不稳（阶段五）
② 遥控 G: 是否随倾斜变化（映射）
③ 小车 g_gesture 是否等于遥控 G（链路）
④ 车动不动 → 注意：车根本不读 gesture
```

> [!info] 三个速查点
> ① G 不变查角度与阈值；② 车不动先怀疑没接线；③ 左右反只改一处。

---

## 二、【现象】→【可能原因】→【排查步骤】→【修正与防范】

| 现象 | 可能原因 | 排查步骤 | 修正与防范 |
|---|---|---|---|
| 手势不切换 | 角度未超 15°；或符号反 | 看 OLED 角度；对比倾斜方向 | 加大倾斜；查 `×-1.0f` |
| 手势疯狂跳变 | 阈值附近抖动、无迟滞 | 停在 15° 附近看 `G:` | 加迟滞（进 20/退 12） |
| **改阈值车不变** | 小车不读 `g_gesture` | 搜 `g_gesture` 只有定义与赋值 | 属设计现状 |
| 左右反了 | `REVERSE_TURN` / `Gesture_Map:66` 后门 / 遥控取反 | 三处只改一处试 | 别同时改 |
| 小车状态与 G 不一致 | 三套阈值（15/15、10/15、10/15） | 停在 12° 看两屏 | 统一常量 |
| 回中后车不停 | 死区/目标未清零；或失联 | 看 `targetL` 是否回 0 | 修死区；加超时 |
| 数字正常但车一顿一顿 | 补偿 0→30 跳变 | 看 `pwm_L_temp` 是否直接 30 | 改补偿策略 |

---

## 三、工具怎么用

| 工具 | 测什么 | 正常值 |
|---|---|---|
| 调试器（遥控） | `pitch/roll/gesture` | 随倾斜变化 |
| 调试器（小车） | `g_gesture/targetL/pwm_L_temp` | 逐级跟随 |
| OLED | `G:` 两位数字 | 00~05 |
| 串口 | `targetL,targetR,pwm_L` | 目标随角度、输出随目标 |

---

## 四、本阶段 4 个必踩坑

> [!warning] 坑 1 · 以为改映射就能改车
> 遥控 `Gesture_Map` 只影响 `G:` 与协议字节；车由 `DEAD_ZONE/TURN_THRESHOLD` 决定。

> [!warning] 坑 2 · 阈值附近抖动
> 单阈值 + 无迟滞 → 15° 附近 `G` 在 1/5 间反复跳。

> [!warning] 坑 3 · 前后优先级吞掉转向
> `Gesture_Map` 先判 pitch：前倾+侧倾同时超阈值只判“前进”。

> [!warning] 坑 4 · 把 `g_gesture` 当活数据
> 搜全工程仅定义(96)与赋值(202)；调手势阈值不会改变车速。

---

## 五、10 分钟定位法

1. 遥控 OLED 看 `G:` 是否变化。
2. 不变 → 查角度是否超 15°、符号是否反。
3. 变了 → 小车 Watch `g_gesture` 是否同步。
4. 同步但车不对 → 问题在小车映射，不在手势。
5. 验证“是否被使用”：把所有 `return` 改 5，车不变即证明未使用。

---

## 六、防幻觉审计报告

> [!success] 🛡️ 防幻觉审计报告
> 1. **代码出处核实**：是。`Gesture_Map`（含 66 行注释）、`g_gesture`（96/202）、`DEAD_ZONE`、`REVERSE_TURN`、状态阈值均来自你提供的文件。
> 2. **库的纯洁性**：未混用，StdPeriph + FreeRTOS。
> 3. **脑补排查**：否。未编造引脚；方向判断依赖实物，已标待确认。
> 4. **本次悬空依赖**：无新增；角度链路依赖阶段五。

#RM电控 #STM32 #Debug #手势
