tomorrozy/gesture-control-car/docs/04-调试笔记/阶段四_蓝牙无线.md

---
title: Debug 阶段四 蓝牙无线
tags:
  - RM电控
  - STM32/阶段四
  - Debug/nRF24L01
version: V2
updated: 2026-10-23
---

> [!danger] 🚨 版本交接指令
> 请将旧版 `Debug_阶段四_蓝牙无线_V1.md` 移入回收站，保存此 `_V2` 文件，并把主教程与全库双链改指本文件。

# Debug · 阶段四 · 蓝牙无线（nRF24L01）

> [!tip] 配套主教程
> 本章代码讲解见：[[阶段四_主教程_蓝牙无线_V2]]

---

## 一、排查总顺序

```text
① Check() 返回 0 吗（SPI 四线+供电）
② 读 STATUS 是否合理（不是 0x00/0xFF）
③ 射频参数一致吗（信道/速率/地址/CRC/载荷宽度）
④ 能收吗（RX_OK 位、RX FIFO）
⑤ 能发吗（TxPacket 返回 0x20 还是 0x10）
```

> [!info] 三个速查点
> ① 不通过先查供电与引脚；② 通过但收不到查参数；③ 返回 0x10 查 ACK 地址。

---

## 二、【现象】→【可能原因】→【排查步骤】→【修正与防范】

| 现象 | 可能原因 | 排查步骤 | 修正与防范 |
|---|---|---|---|
| `Check()` 一直失败 | 没供电（3.3 V）/ SPI 接错 / 小车忘开 GPIOB 时钟 / CSN 错 | 万用表量 VCC；示波器看 SCK 有无 8 拍 | 补供电/接线/时钟（`nRF24L01_API.c:3–8`） |
| Check 过但**收不到** | 信道/地址/速率/CRC 不一致；CE 没拉高 | 逐项比对两端初始化值；量 CE | 两端同步改 |
| 收发**距离很短** | 2 Mbps 灵敏度低、电源差、天线差 | 走近再试；给模块并 10 µF+0.1 µF | 降 1 Mbps；加去耦 |
| 发送**总失败 0x10** | ACK 地址错配（`RX_ADDR_P0` ≠ 接收端管道地址） | 打印 `TxPacket` 返回值；核对两端地址 | 第 191 行改 `(uchar*)tx_addr` |
| 接收端**每次都说有数据** | 没清 `RX_OK`；没 `FLUSH_RX` | 读 STATUS 看 bit6 是否一直 1 | 写 STATUS 清标志 + FLUSH（抄遥控端 292–303） |
| 数据**偶尔错位** | 轮询太慢、FIFO 覆盖 | 减小轮询间隔；读 FIFO_STATUS | 提高轮询频率/加序号 |
| 插电机就丢包 | 电机干扰、电源跌落 | 示波器看 3.3 V 纹波 | 独立供电/加电容/远离电机线 |

---

## 三、工具怎么用

| 工具 | 测什么 | 正常值 |
|---|---|---|
| 万用表 | VCC-GND / CE / CSN | 3.3 V / 接收时高 / 空闲高 |
| 示波器 | SCK 一次访问 | 8 拍（或 16/24）时钟 |
| 示波器 | CE | 发送时约 10 µs 高脉冲 |
| 调试器 | `STATUS` | bit6=RX_OK、bit5=TX_OK、bit4=MAX_TX |

---

## 四、本阶段 4 个必踩坑

> [!warning] 坑 1 · 两端引脚混用
> 小车 MISO/IRQ 在 **PB0/PB1**，遥控在 **PA4/PA5**；同名文件不同内容，改错文件=白改。

> [!warning] 坑 2 · 小车忘开 GPIOB 时钟
> 只开 GPIOA 时 MISO/IRQ 不工作，`Check()` 必然失败。

> [!warning] 坑 3 · 把注释当手册
> `SETUP_RETR=0x1A` 不是“500 µs/10 次”，而是“重发 1 次 / 间隔 2750 µs”。位域要拆开看。

> [!warning] 坑 4 · ACK 地址 ≠ 管道地址
> `TX_ADDR` 是“包飞去哪”，`RX_ADDR_P0` 是“在哪等回执”；不一致就是每包白重发。

---

## 五、10 分钟定位法

1. 量模块 VCC=3.3 V、GND 导通。
2. 单步过 `Check()`，看读出值是否等于写入值。
3. 打印两端 `RF_CH`、`RF_SETUP`、地址，逐项比对。
4. 断开一端，看另一端 STATUS 是否变化。
5. 打印 `TxPacket` 返回值：0x10 查 ACK，0x20 链路正常。
6. 拉远/加电机负载，观察丢包是否上升。

---

## 六、防幻觉审计报告

> [!success] 🛡️ 防幻觉审计报告
> 1. **代码出处核实**：是。`NRF24L01_Check`、`SPI_RW`、`TxPacket` 返回值、`SETUP_RETR`、引脚宏、`nRF24L01_API.c:191` 均来自你提供的文件。
> 2. **库的纯洁性**：未混用，StdPeriph + 位带宏。
> 3. **脑补排查**：否。供电/天线/去耦标待确认；寄存器位含义标为手册事实。
> 4. **本次悬空依赖**：嘉立创工程无法解析（已说明）。

#RM电控 #STM32 #Debug #nRF24L01
