tomorrozy/gesture-control-car/(list of files, drawings)

Other design files:
1.原理图/ProPrj_A0006-26-258-手势识别小车_2026-10-21.epro
1.原理图/手势小车.epro
