tomorrozy/gesture-control-car/(commit log)

2026-10-28 feat: 手势识别小车 v1.0.0
    基于 STM32 的体感遥控小车，含手柄端与小车端两个独立 Keil 工程。
    - 手柄端：MPU6050 姿态采集 + 13 字节自定义协议（XOR 校验）+ nRF24L01 发送
    - 小车端：FreeRTOS V9.0.0 四任务架构 + 双轮编码器速度闭环 PID + TIM2 PWM 驱动
    - 文档：README、硬件接线表、通信协议说明、第三方组件声明与致谢
    - 发布：两端预编译固件 hex，可直接烧录
2026-10-28 docs: 新增 47 篇学习文档，建立完整文档中心
    从零基础到完整实现的全套中文资料：
    - 00-学习路线与工程全景：架构分层与代码地图
    - 01-八阶段教程（13 篇）：阶段一到八逐步实现讲解
    - 02-图解字典（9 篇）：PWM/编码器/互补滤波/PID 概念图解
    - 03-零基础落地包（7 篇）：器材、工具链、供电、验收门禁、引脚总表
    - 04-调试笔记（8 篇）：各阶段真实踩坑记录
    - 05-参考资料（5 篇）：术语词典、代码模板、Yaw 零飘、硬件解析
    - README 增加文档导航；docs/README.md 提供阅读路线
2026-10-28 docs: 新增系统架构图，README 首屏展示
    - 手绘 SVG 架构图：手柄端姿态采集 → 2.4G 无线 → 小车端 FreeRTOS 闭环
    - 标注关键引脚、协议字段、PID 参数与任务优先级
    - README 首屏用架构图替代原空白占位；真机 GIF 位置保留待补
