tomorrozy/gesture-control-car/(notices)

Notices in the files:
README.md:
License: MIT
